RoboZag/zagHexa/androidRobotBTjoystick/README.md

# Android Bluetooth Joypad
Joystick app to control a robot over Bluetooth.

A demo video of the app can be found [here](https://drive.google.com/open?id=0B3lPRdhows9ATnFwX2w3UmVPc2M).

## Feature
  * video overlay through integration with IPwebcam [IPwebcam](https://play.google.com/store/apps/details?id=com.pas.webcam&hl=en)
  * Normal Joypad 4 direction and 4 buttons
  * Configurable buttons.
  * Quick setting using QRCode scanner.
  * Vibrate on click.
  * Debug mode.

## Screenshot

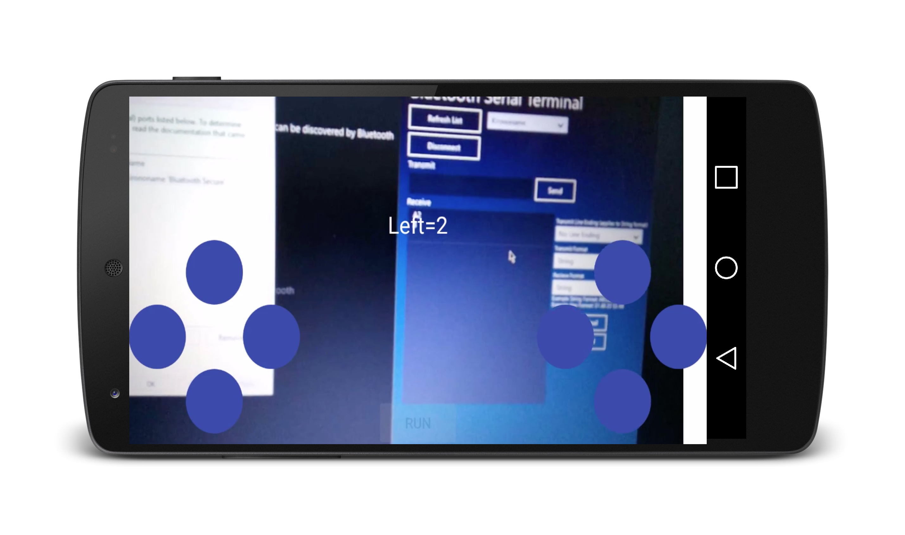
[picture p1: androidRobotBTjoystick/screenshots/vedioOverlay.png]


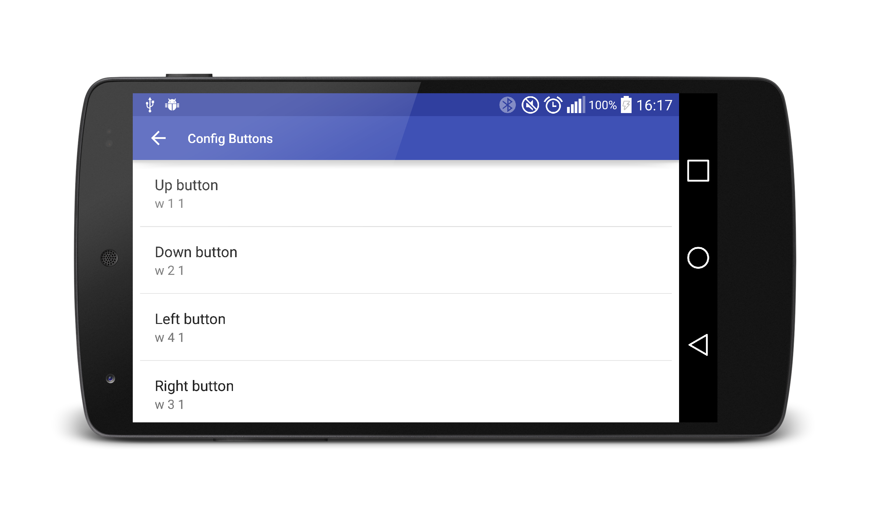
[picture p2: androidRobotBTjoystick/screenshots/DFG_2015-11-27-16-36-59.png]


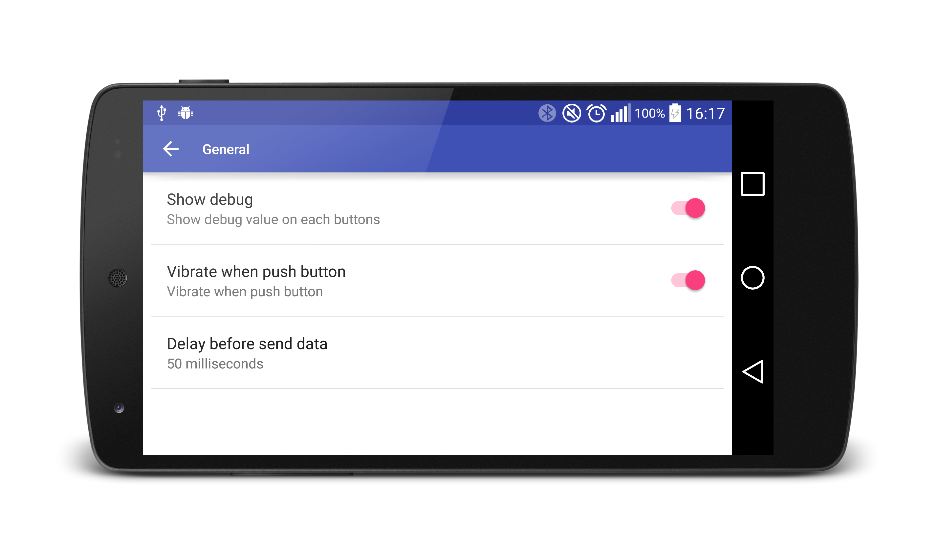
[picture p3: androidRobotBTjoystick/screenshots/DFG_2015-11-27-16-37-12.png]
     

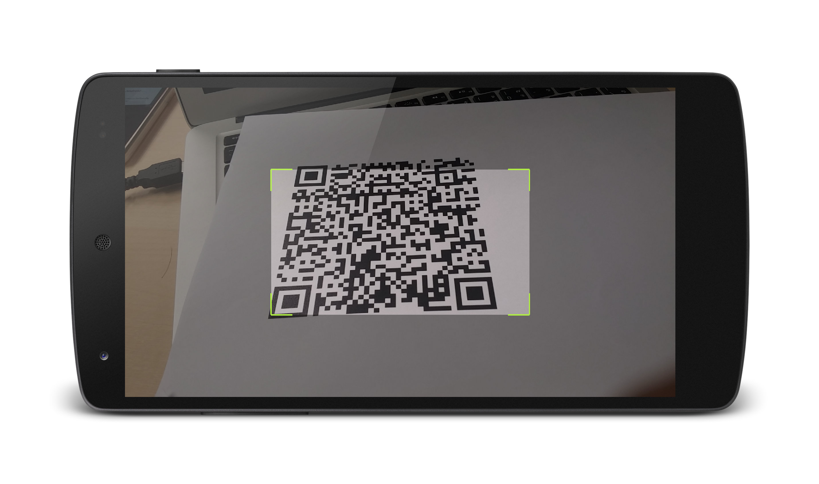
[picture p4: androidRobotBTjoystick/screenshots/DFG_2015-12-09-10-57-40.png]
         

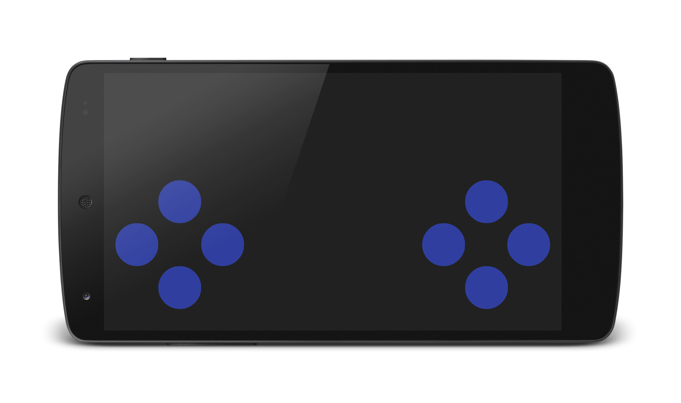
[picture p5: androidRobotBTjoystick/screenshots/DFG_2015-12-16-21-09-15.png]
 

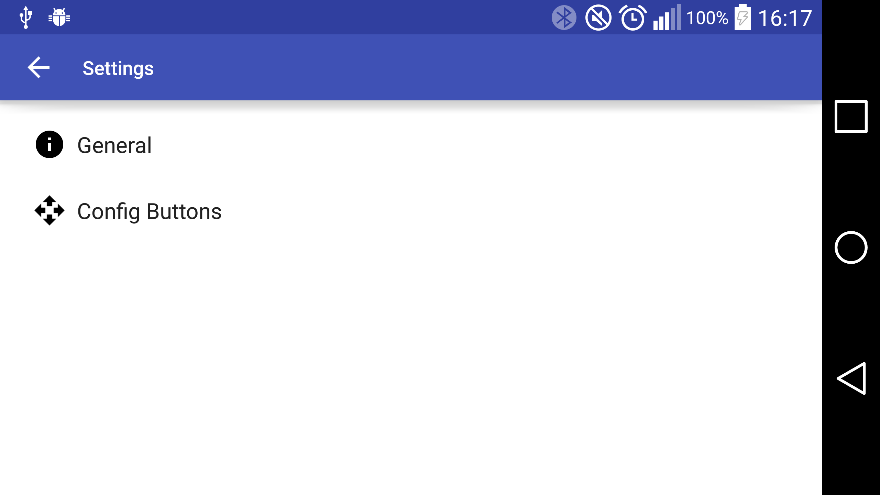
[picture p6: androidRobotBTjoystick/screenshots/Screenshot_2015-11-27-16-17-21.png]
