RoboZag/zagHexa/publications/IUGRC/2017IUGRC-ZagHexa.tex

%% bare_conf.tex
%% V1.4b
%% 2015/08/26
%% by Michael Shell
%% See:
%% http://www.michaelshell.org/
%% for current contact information.
%%
%% This is a skeleton file demonstrating the use of IEEEtran.cls
%% (requires IEEEtran.cls version 1.8b or later) with an IEEE
%% conference paper.
%%
%% Support sites:
%% http://www.michaelshell.org/tex/ieeetran/
%% http://www.ctan.org/pkg/ieeetran
%% and
%% http://www.ieee.org/

%%*************************************************************************
%% Legal Notice:
%% This code is offered as-is without any warranty either expressed or
%% implied; without even the implied warranty of MERCHANTABILITY or
%% FITNESS FOR A PARTICULAR PURPOSE! 
%% User assumes all risk.
%% In no event shall the IEEE or any contributor to this code be liable for
%% any damages or losses, including, but not limited to, incidental,
%% consequential, or any other damages, resulting from the use or misuse
%% of any information contained here.
%%
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
% for subfigure.sty, the latter of which is no longer maintained and is
% incompatible with some LaTeX packages including fixltx2e. However,
% subfig.sty requires and automatically loads Axel Sommerfeldt's caption.sty
% which will override IEEEtran.cls' handling of captions and this will result
% in non-IEEE style figure/table captions. To prevent this problem, be sure
% and invoke subfig.sty's "caption=false" package option (available since
% subfig.sty version 1.3, 2005/06/28) as this is will preserve IEEEtran.cls
% handling of captions.
% Note that the Computer Society format requires a larger sans serif font
% than the serif footnote size font used in traditional IEEE formatting
% and thus the need to invoke different subfig.sty package options depending
% on whether compsoc mode has been enabled.
%
% The latest version and documentation of subfig.sty can be obtained at:
% http://www.ctan.org/pkg/subfig

% *** FLOAT PACKAGES ***
%
%\usepackage{fixltx2e}
% fixltx2e, the successor to the earlier fix2col.sty, was written by
% Frank Mittelbach and David Carlisle. This package corrects a few problems
% in the LaTeX2e kernel, the most notable of which is that in current
% LaTeX2e releases, the ordering of single and double column floats is not
% guaranteed to be preserved. Thus, an unpatched LaTeX2e can allow a
% single column figure to be placed prior to an earlier double column
% figure.
% Be aware that LaTeX2e kernels dated 2015 and later have fixltx2e.sty's
% corrections already built into the system in which case a warning will
% be issued if an attempt is made to load fixltx2e.sty as it is no longer
% needed.
% The latest version and documentation can be found at:
% http://www.ctan.org/pkg/fixltx2e

%\usepackage{stfloats}
% stfloats.sty was written by Sigitas Tolusis. This package gives LaTeX2e
% the ability to do double column floats at the bottom of the page as well
% as the top. (e.g., "\begin{figure*}[!b]" is not normally possible in
% LaTeX2e). It also provides a command:
%\fnbelowfloat
% to enable the placement of footnotes below bottom floats (the standard
% LaTeX2e kernel puts them above bottom floats). This is an invasive package
% which rewrites many portions of the LaTeX2e float routines. It may not work
% with other packages that modify the LaTeX2e float routines. The latest
% version and documentation can be obtained at:
% http://www.ctan.org/pkg/stfloats
% Do not use the stfloats baselinefloat ability as the IEEE does not allow
% \baselineskip to stretch. Authors submitting work to the IEEE should note
% that the IEEE rarely uses double column equations and that authors should try
% to avoid such use. Do not be tempted to use the cuted.sty or midfloat.sty
% packages (also by Sigitas Tolusis) as the IEEE does not format its papers in
% such ways.
% Do not attempt to use stfloats with fixltx2e as they are incompatible.
% Instead, use Morten Hogholm'a dblfloatfix which combines the features
% of both fixltx2e and stfloats:
%
% \usepackage{dblfloatfix}
% The latest version can be found at:
% http://www.ctan.org/pkg/dblfloatfix

% *** PDF, URL AND HYPERLINK PACKAGES ***
%
\usepackage{url}
% url.sty was written by Donald Arseneau. It provides better support for
% handling and breaking URLs. url.sty is already installed on most LaTeX
% systems. The latest version and documentation can be obtained at:
% http://www.ctan.org/pkg/url
% Basically, \url{my_url_here}.

% *** Do not adjust lengths that control margins, column widths, etc. ***
% *** Do not use packages that alter fonts (such as pslatex).         ***
% There should be no need to do such things with IEEEtran.cls V1.6 and later.
% (Unless specifically asked to do so by the journal or conference you plan
% to submit to, of course. )

% correct bad hyphenation here
\hyphenation{op-tical net-works semi-conduc-tor}

%2nd IUGRC International Undergraduate Research Conference,
%Military Technical College, Cairo, Egypt, July 24-27, 2017.	

\begin{document}
%
% paper title
% Titles are generally capitalized except for words such as a, an, and, as,
% at, but, by, for, in, nor, of, on, or, the, to and up, which are usually
% not capitalized unless they are the first or last word of the title.
% Linebreaks \\ can be used within to get better formatting as desired.
% Do not put math or special symbols in the title.
\title{ZagHexa: Design, Construction and Control\\of a Hexapod Walking Robot}

%Faculty of Engineering, Zagazig University, Egypt, 
% khaledrisha@gmail.com, mahmoud.elsyed21@gmail.com, 3bqar10@gmail.com, amirafadaly90@gmail.com, enghkho@gmail.com, engvida2@gmail.com
%Supervisor: Mohammed Nour Abdel Gwad Ahmed, Dr. Ing.
%Faculty of Engineering, Zagazig University, Egypt, 
%mnahmed@eng.zu.edu.eg

% author names and affiliations
% use a multiple column layout for up to three different
% affiliations

\author{
      \IEEEauthorblockN{Mohammed Nour Abdelgwad Ahmed}
    \IEEEauthorblockA{Computer and Systems Dept., Faculty of Engineering, Zagazig University, Egypt}

    \IEEEauthorblockN{Khaled Mohamed Risha, Mahmoud Mohamed Awadallah, Muhammad Alaa Muhammad, \\
        Amira Elsayed Fadaly, Hend Khairy Abdelhamed, Nehad Abdelsalam Afifi}
    \IEEEauthorblockA{Computer and Systems Dept., Faculty of Engineering\\
         Zagazig University, Egypt\\
     Email: mnahmedeng.zu.edu.eg}}

%\author{\IEEEauthorblockN{Author One\IEEEauthorrefmark{1},
%        Author Two\IEEEauthorrefmark{2}, Author Three\IEEEauthorrefmark{3} and
%        Author Four\IEEEauthorrefmark{4}}
%    \IEEEauthorblockA{Computer and Systems Dept., Faculty of Engineering, Zagazig University, Egypt\\
%        Email: \IEEEauthorrefmark{1}author.one@add.on.net,
%        \IEEEauthorrefmark{2}author.two@add.on.net,
%        \IEEEauthorrefmark{3}author.three@add.on.net,
%        \IEEEauthorrefmark{4}author.four@add.on.net}}
%    
%\author{%
%\IEEEauthorblockN{Khaled Mohamed Mohamed Abdelrahman Risha}
%\IEEEauthorblockA{khaledrisha@gmail.com}
%\and
%\IEEEauthorblockN{Mahmoud Mohamed Awadallah}
%\IEEEauthorblockA{khaledrisha@gmail.com}
%\and
%\IEEEauthorblockN{Muhammad Alaa Muhammad}
%\IEEEauthorblockA{khaledrisha@gmail.com}
%\and
%\IEEEauthorblockN{ Amira Elsayed Soliman Fadaly}
%\IEEEauthorblockA{khaledrisha@gmail.com}
%\and
%\IEEEauthorblockN{Hend Khairy Abdelhamed}
%\IEEEauthorblockA{khaledrisha@gmail.com}
%\and
%\IEEEauthorblockN{Nehad Abdelsalam Afifi}
%\IEEEauthorblockA{khaledrisha@gmail.com}

%\IEEEauthorblockA{School of Electrical and\\Computer Engineering\\
%Georgia Institute of Technology\\
%Atlanta, Georgia 30332--0250\\
%Email: http://www.michaelshell.org/contact.html}
%\and
%\IEEEauthorblockN{Homer Simpson}
%\IEEEauthorblockA{Twentieth Century Fox\\
%Springfield, USA\\
%Email: homer@thesimpsons.com}
%\and
%\IEEEauthorblockN{James Kirk\\ and Montgomery Scott}
%\IEEEauthorblockA{Starfleet Academy\\
%San Francisco, California 96678--2391\\
%Telephone: (800) 555--1212\\
%Fax: (888) 555--1212}}

% conference papers do not typically use \thanks and this command
% is locked out in conference mode. If really needed, such as for
% the acknowledgment of grants, issue a \IEEEoverridecommandlockouts
% after \documentclass

% for over three affiliations, or if they all won't fit within the width
% of the page, use this alternative format:
% 
%\author{\IEEEauthorblockN{Michael Shell\IEEEauthorrefmark{1},
%Homer Simpson\IEEEauthorrefmark{2},
%James Kirk\IEEEauthorrefmark{3}, 
%Montgomery Scott\IEEEauthorrefmark{3} and
%Eldon Tyrell\IEEEauthorrefmark{4}}
%\IEEEauthorblockA{\IEEEauthorrefmark{1}School of Electrical and Computer Engineering\\
%Georgia Institute of Technology,
%Atlanta, Georgia 30332--0250\\ Email: see http://www.michaelshell.org/contact.html}
%\IEEEauthorblockA{\IEEEauthorrefmark{2}Twentieth Century Fox, Springfield, USA\\
%Email: homer@thesimpsons.com}
%\IEEEauthorblockA{\IEEEauthorrefmark{3}Starfleet Academy, San Francisco, California 96678-2391\\
%Telephone: (800) 555--1212, Fax: (888) 555--1212}
%\IEEEauthorblockA{\IEEEauthorrefmark{4}Tyrell Inc., 123 Replicant Street, Los Angeles, California 90210--4321}}

% use for special paper notices
%\IEEEspecialpapernotice{(Invited Paper)}

% make the title area
\maketitle

% As a general rule, do not put math, special symbols or citations
% in the abstract
\begin{abstract}
This paper presents design, construction and control of a hexapod robot named ZagHexa which is a six-legged walking robot. As walking robots in general and hexapod robots in particular attract considerable attention for several decades. Thus, many studies are carried out in research and industry. We provide an overview of the state of the art on walking robots. In addition, an account of the basic characteristics of legged robots will be given with description of some of existing robots and their pros and cons. 

Our main goal is to produce an efficient walking machines that is designed and built with performances suitable for as many as possible applications. Therefore, careful attention is given to the main design issues and constraints that influence the technical feasibility and operation performance. A design procedure is outlined to systematically design a hexapod walking robot. In particular, the proposed design procedure considers the main features, such as mechanical structure and leg configuration, actuating and driving systems, payload, motion conditions, and walking gait.

The result of this project is the legged robot ZagHexa, which can walk using tripod, wave and ripple gait and is equipped with a couple of sensors. The robot is controlled and monitored from a user interface program based on the Robotic Operating System (ROS). It can display data from the sensors and the positions of robot legs. The robot can be used to test and verify algorithms, gaits and features of walking machines.
\end{abstract}

% no keywords
\begin{IEEEkeywords}
Hexapod, Legged chassis, Walking robot, Hexapod gaits, design procedure.
\end{IEEEkeywords}

% For peer review papers, you can put extra information on the cover
% page as needed:
% \ifCLASSOPTIONpeerreview
% \begin{center} \bfseries EDICS Category: 3-BBND \end{center}
% \fi
%
% For peerreview papers, this IEEEtran command inserts a page break and
% creates the second title. It will be ignored for other modes.
\IEEEpeerreviewmaketitle

%==============================================================================
\section{Introduction}
% no \IEEEPARstart
Robots can be found everywhere. One of the most
important part of a robot is its chassis. There are several
basic chassis types: wheeled, tracked and legged chassis. Wheeled chassis are fast, but not suitable for rough terrain. Tracked chassis are slower, but more suitable to rugged terrain. Legged chassis are quite slow and more difficult to control, but extremely robust in rough terrain. Legged chassis are capable to cross large holes and can operate even after losing a leg. [1] Many researches were performed in this
field in past few years, because of its large potential. Legged chassis are especially ideal for space missions [2,3]. There are also several projects in military research [4, 5, 6].

A hexapod robot is a mechanical vehicle that walks on six legs. Since a robot can be statically stable on three or more legs, a hexapod robot has a great deal of flexibility in how it can move. If legs become disabled, the robot may still be able to walk. Furthermore, not all of the robot's legs are needed for stability; other legs are free to reach new foot placements or manipulate a payload.

As technology developed, so did the potential uses for the robots. With six legs, the hexapod has a remarkable degree of stability. It can balance its weight on a combination of its legs using an alternating tripod gait, and can engage in complex activities like climbing stairs relatively easily.

Development of hexapods is increasingly robust in the military sector. Armies all over the world are exploring ways of using hexapods to detect land mines, traverse rocky, unstable terrain, and carry out simple delivery missions in danger zones.
\begin{figure}
    \centering
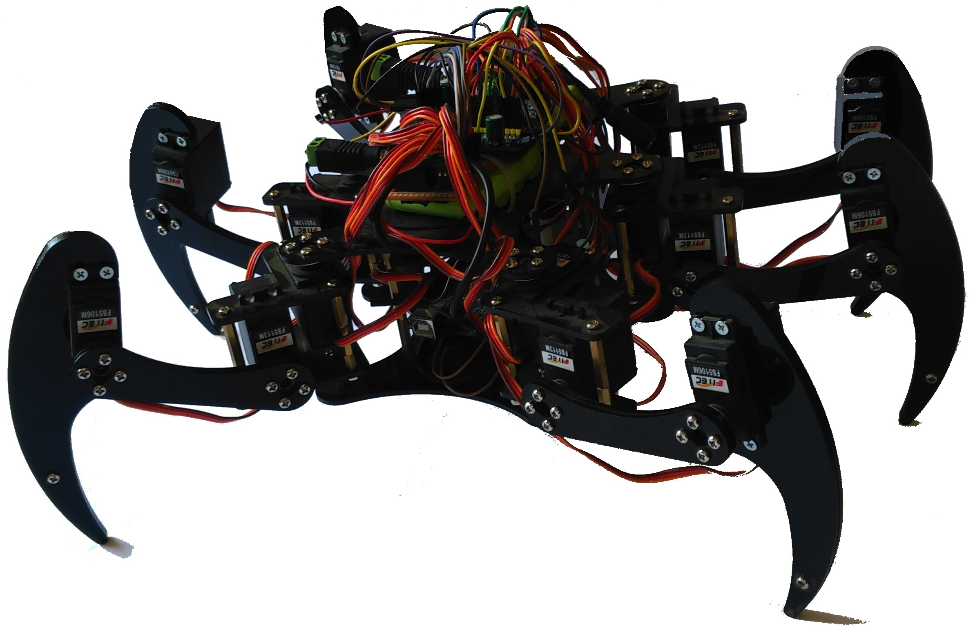
[picture p80: publications/IUGRC/figures/ZagHexa.jpg]
    
    \caption{ZagHexa Robot.}
    \label{fig:zaghexa}
\end{figure}

We aim to create a cheap legged platform, which would allow research and testing of walking patterns. Create a system with many sensors that allows the robot any movement or behavior. The robot should be driven from wirelessly connected computer and should send all available data from sensors, which will be displayed on the computer in the user interface program. Figure 1 shows the 3D CAD design of the robot.
%==============================================================================

\section{Hardware and software architectures}
There are many ways how to classify walking robots – by a body shape [7], number of legs, number of degrees of freedom per leg or locomotion technique. Various options can be combined to achieve many different configurations. At least two degrees of freedom are needed to construct a walking robot – the first for lifting the leg, second for rotating it. Nevertheless, there should be three degrees of freedom for a good functioning chassis, because the legs move along a circle and the forward movement of the body causes slipping between the foot and the terrain, which can be compensated by third joint [8, 9]. Walking chassis movement can be divided into statically stable and dynamically stable [1, 9]. Static stability represents the ability of the chassis to remain in a stable position in every moment of movement. Static stability is typical for hexapod, which is always stable during its movement. Dynamically stable chastises are sometimes out of balance – balancing or falling. This is common for two-legged robots.

ZagHexa is a hexapod robot with 18 DOFs (3 DOFs each leg), it can walk in any direction (translation), or turn in place (rotation), or any combination of the two. The leg lift and ride height is adjustable as well. 
It is an integrated multi-legged walking robot based on de fecto standard robotic platforms and operating system (ROS) that employs novel and different walking patterns.
We have an interactive website for robot inspection and online control in addition to leaning materials such as robot building and implementation walkthroughs and as well as step-by-setup tutorials.

The hexapod is controlled remotely using hand-held devices such as: a mobile application or a joystick. Furthermore, it has its own navigation system and a camera for instant video recording and streaming.

The power to the entire system is supplied through two 5 volts NiMH batteries, which can supply sufficient power required for basic movement. There is an additional power bank to power up the Raspberry Pi and other electronic components. 
%------------------------------------------------------------------------------

\subsection{Hardware}
ZagHexa is equipped with all necessary resources to interact with his world. The system is supplied with an embedded computing system which is Raspberry Pi 3 Model B that use Ubuntu Xilinx.  Raspberry Pi is a miniature computer the size of a credit card, to which a standard monitor, a keyboard and a mouse can be connected. It has extremely low power consumption (max. 3.5 W) and can run ROS based on Ubuntu operating system. There are several models, which differ in RAM, the number of USB ports or GPIO pins and the connation methods. Raspberry Pi is equipped with a USB Wi-Fi dongle, which is connected to a wireless network, and runs Qt [11] client program, which is able to find the IP address of the server and gets connected to it. Sensor data are sent to a computer after successful connection. Client is also capable of reconnect after disconnection.

ZagHexa can use all the sensors form any mobile phone thanks to its own mobile application that communicate through Bluetooth, which able it to sense the environment and deal with it. 

All servomotors are connected and driven by an external controller PCA9685 that take the walking pattern from the raspberry through I2C pins controlling the sequence of order and keep the position in the last order it was in (see Fig.2).
%------------------------------------------------------------------------------

\subsection{Software}
The high–level functionality and control of the robot are implemented in ROS packages. The Robot Operating System (ROS) is a standard and open–source operating system for robot control [10]. ROS is not an operating system in the traditional sense of process management and scheduling; rather, it provides a structured communication layer above the host operating systems of a heterogeneous compute cluster. Our software ROS packages interact with each of the subsystems in C++ and Python for direct system control. The system described uses a Linux based software framework as an operating system (OS) for providing the advantages of using an OS which supports developing additional modules that can be easily implemented and integrated. ROS provides operating system like service for the robot. It is a meta-operating system which loads on top of an operating system to provide a standardized set of software framework and APIs. These facilities cannot only help robots but also other embedded systems with a rich set of tools to successfully manage the complexity. With ROS handling the basic communications and data exchange.
%==============================================================================

\section{Mechanical Design}
We, firstly, developed our hexapod robot design using the well-known solid design software called SOLIDWORKS, then we have our model into real world using a laser cutter.

This hexapod has rectangular body type – it has two groups of legs, three on each side. Each leg has three degrees of freedom and is powered by hobby servomotors with different torque rating (FS5113M on coxa and femur and FS5106M on tibia joints

\begin{figure}
    \centering
   % \includegraphics[width=0.7\linewidth]{"../../Google Drive/ZagHexa2017/publications/IUGRC/Untitled"}
    \caption{Front view of the leg}
    \label{fig:untitled}
\end{figure}

Servomotors must be sufficiently powerful, depending on the desired behavior. If tripod gait is required, then each motor on the middle legs must be powerful enough to hold half of the weight of the robot.
It is important to choose a suitable material for the body. It must be solid enough, but not too heavy.
Therefore, aluminum profiles were chosen for the body construction. They are quite light-weighted and solid enough. In addition, they are available in various sizes and shapes and are easy to handle. The project is made of a double layer profile of thickness equals 3 mm each. 
%==============================================================================

\section{Conclusion}
This paper presents a system description and the main aspects related to the design, construction, and implementation of six leg robot "ZagHexa", a legged robot for search and rescue mission. The robot benefits form the reliability of the legged robot with the ﬂexibility and versatility required to operate in different types of surface.

These features are mainly achieved due to its original movement that make it deal with different surfaces. Additionally, its shape and weight give it more stability, and its ability to continue with its moving and sensing capabilities after collisions or even small falls. However, more tests and experiments to improve and validate the design and sensor performance are to be carried out in order to optimize the system performance.

Finally, some issues have to be addressed in order to fulﬁll fully autonomous operation and integration into a heterogeneous system. in order to make the integration of ZagHexa into different missions easier, an effort is being carried out so as to provide it with a standard connectivity by using the common robot operating system (ROS) framework. This task becomes easier since it natively works using Ubuntu as its operating system and encapsulate its functionality in ROS packages.
%==============================================================================

\section*{Acknowledgment}
We thank all team members of this project who provided valuable comments, ideas, and assistance, which were essential to this study. This work is developed for and funded by CSE Department Zagazig University as a part of development for graduation project.

\subsubsection{Subsubsection Heading Here}
Subsubsection text here.

% An example of a floating figure using the graphicx package.
% Note that \label must occur AFTER (or within) \caption.
% For figures, \caption should occur after the \includegraphics.
% Note that IEEEtran v1.7 and later has special internal code that
% is designed to preserve the operation of \label within \caption
% even when the captionsoff option is in effect. However, because
% of issues like this, it may be the safest practice to put all your
% \label just after \caption rather than within \caption{}.
%
% Reminder: the "draftcls" or "draftclsnofoot", not "draft", class
% option should be used if it is desired that the figures are to be
% displayed while in draft mode.
%
%\begin{figure}[!t]
%\centering
%\includegraphics[width=2.5in]{myfigure}
% where an .eps filename suffix will be assumed under latex, 
% and a .pdf suffix will be assumed for pdflatex; or what has been declared
% via \DeclareGraphicsExtensions.
%\caption{Simulation results for the network.}
%\label{fig_sim}
%\end{figure}

% Note that the IEEE typically puts floats only at the top, even when this
% results in a large percentage of a column being occupied by floats.

% An example of a double column floating figure using two subfigures.
% (The subfig.sty package must be loaded for this to work.)
% The subfigure \label commands are set within each subfloat command,
% and the \label for the overall figure must come after \caption.
% \hfil is used as a separator to get equal spacing.
% Watch out that the combined width of all the subfigures on a 
% line do not exceed the text width or a line break will occur.
%
%\begin{figure*}[!t]
%\centering
%\subfloat[Case I]{\includegraphics[width=2.5in]{box}%
%\label{fig_first_case}}
%\hfil
%\subfloat[Case II]{\includegraphics[width=2.5in]{box}%
%\label{fig_second_case}}
%\caption{Simulation results for the network.}
%\label{fig_sim}
%\end{figure*}
%
% Note that often IEEE papers with subfigures do not employ subfigure
% captions (using the optional argument to \subfloat[]), but instead will
% reference/describe all of them (a), (b), etc., within the main caption.
% Be aware that for subfig.sty to generate the (a), (b), etc., subfigure
% labels, the optional argument to \subfloat must be present. If a
% subcaption is not desired, just leave its contents blank,
% e.g., \subfloat[].

% An example of a floating table. Note that, for IEEE style tables, the
% \caption command should come BEFORE the table and, given that table
% captions serve much like titles, are usually capitalized except for words
% such as a, an, and, as, at, but, by, for, in, nor, of, on, or, the, to
% and up, which are usually not capitalized unless they are the first or
% last word of the caption. Table text will default to \footnotesize as
% the IEEE normally uses this smaller font for tables.
% The \label must come after \caption as always.
%
%\begin{table}[!t]
%% increase table row spacing, adjust to taste
%\renewcommand{\arraystretch}{1.3}
% if using array.sty, it might be a good idea to tweak the value of
% \extrarowheight as needed to properly center the text within the cells
%\caption{An Example of a Table}
%\label{table_example}
%\centering
%% Some packages, such as MDW tools, offer better commands for making tables
%% than the plain LaTeX2e tabular which is used here.
%\begin{tabular}{|c||c|}
%\hline
%One & Two\\
%\hline
%Three & Four\\
%\hline
%\end{tabular}
%\end{table}

% Note that the IEEE does not put floats in the very first column
% - or typically anywhere on the first page for that matter. Also,
% in-text middle ("here") positioning is typically not used, but it
% is allowed and encouraged for Computer Society conferences (but
% not Computer Society journals). Most IEEE journals/conferences use
% top floats exclusively. 
% Note that, LaTeX2e, unlike IEEE journals/conferences, places
% footnotes above bottom floats. This can be corrected via the
% \fnbelowfloat command of the stfloats package.

\section{Conclusion}
The conclusion goes here.

% conference papers do not normally have an appendix

% use section* for acknowledgment
\section*{Acknowledgment}

The authors would like to thank...

% trigger a \newpage just before the given reference
% number - used to balance the columns on the last page
% adjust value as needed - may need to be readjusted if
% the document is modified later
%\IEEEtriggeratref{8}
% The "triggered" command can be changed if desired:
%\IEEEtriggercmd{\enlargethispage{-5in}}

% references section

% can use a bibliography generated by BibTeX as a .bbl file
% BibTeX documentation can be easily obtained at:
% http://mirror.ctan.org/biblio/bibtex/contrib/doc/
% The IEEEtran BibTeX style support page is at:
% http://www.michaelshell.org/tex/ieeetran/bibtex/
%\bibliographystyle{IEEEtran}
% argument is your BibTeX string definitions and bibliography database(s)
%\bibliography{IEEEabrv,../bib/paper}
%
% <OR> manually copy in the resultant .bbl file
% set second argument of \begin to the number of references
% (used to reserve space for the reference number labels box)
\begin{thebibliography}{1}

\bibitem{IEEEhowto:kopka}
H.~Kopka and P.~W. Daly, \emph{A Guide to \LaTeX}, 3rd~ed.\hskip 1em plus
  0.5em minus 0.4em\relax Harlow, England: Addison-Wesley, 1999.

\end{thebibliography}

% that's all folks
\end{document}
