RoboZag/zagHexa/documents/Presentation/Pck.pptx

Movement

Up U
Down D
Left L
Right R
BUTTON_X X
BUTTON_Y Y
BUTTON_B B
BUTTON_A A
BUTTON_RB M
BUTTON_RT N
BUTTON_LB O
BUTTON_LT P
BUTTON_Back K
BUTTON_Start S

Joystick_node

Arduino_node

Joystick_

Publish

Subscribe

Publish

Ultrasonic

## Slide 2

Sensors Reading

Get sensor Reading

Over TCP/IP

Client_node

sensorsV

ROS GUI

Publish

Subscribe

Subscribe

Oreading

Publish
