RoboZag/zagHexa/documents/finalReport/myFrontMatter/title.tex

%\titlehead{\centering\includegraphics[width=0.15\textwidth]{myFrontMatter/figures/zuLogo}
%    \includegraphics[width=0.2\textwidth]{myFrontMatter/figures/engLogo}}
\begin{titlepage}
\centering
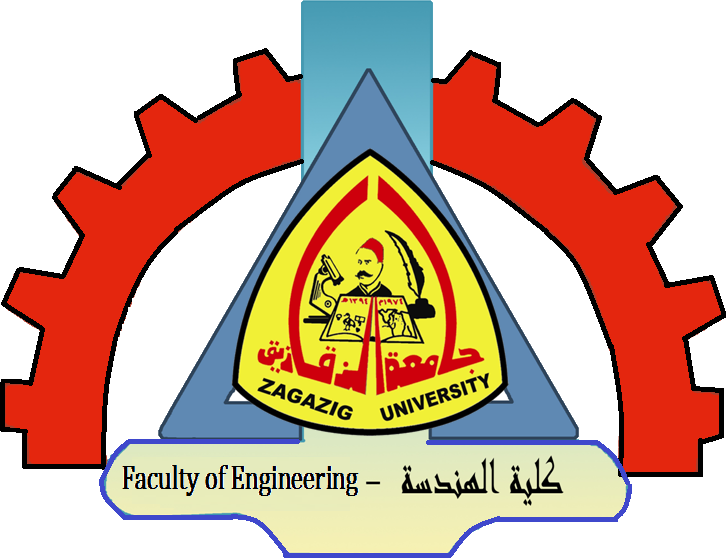
[picture p81: documents/finalReport/myFrontMatter/figures/engLogo.png]
 \qquad \\
{\usekomafont{titlehead}   Zagazig University, Faculty of Engineering,\\Computer and Systems Engineering Dept.}

  \vskip 10ex
{\LARGE\usekomafont{title} {\LARGE  ZagHexa: Design, Construction and Control of a Hexapod Walking Robot} }
\vskip 8ex
\emph{Graduation project for the degree Bachelor of Science (B.Sc.)\\
Submitted to Computer and Systems Engineering Dept., Faculty of Engineering, Zagazig University, Egypt}

\vskip 8ex
{\usekomafont{subtitle} By}
\vskip 1ex
{\usekomafont{author} 
    Mahmoud Mohammed Elsayed\\
    Khaled Mohammed  Risha\\
    Mohammed Alaa Mohammed\\
    Hend Khairy Abdelhamed\\
    Nehad Abdelsalam Mohammed\\
    Amira Elsayed Soliman
}

\vskip 6ex
{\usekomafont{subtitle} Supervisor}
\vskip 1ex

{\usekomafont{author}
    \emph{\normalsize  Asst. Prof. Dr.Ing.}\\
    \textbf{Mohammed Nour A. Ahmed} \\
     {\itshape\small Computer and Systems Engineering Dept.\\
    Faculty of Engineering, Zagazig University, Zagazig, Egypt}
}

\vfill
July, 2017
\end{titlepage}
%%% Rückseite der Titelseite %%%%%%%%%%%%%%%%%%%%%%%%%%%%%%%%%%%%%%%%%%%
%\uppertitleback{Graduation Project Report to be submitted to\\
%Zagazig University, faculty of Engineering\\
%in partial fulfillment of the requirements for the degree \\
%Bachelor of Science in Engineering (B.Sc.)\\
%\textcopyright 2017\\
%
%\vspace{2cm}
%   {\footnotesize
%      Copyright \textcopyright 2017 Dr.Ing. Mohammed Nour Abdelgwad Ahmed as part of the course work and learning material. All Rights Reserved. 
%      Where otherwise noted, this work is licensed under 
%      \href{https://creativecommons.org/licenses/by-nc-sa/4.0/}{ a Creative Commons Attribution-NonCommercial-ShareAlike 4.0 International License}.}
% \includegraphics[width=0.2\textwidth]{byncsa}
%
%}
%
%
%
%\lowertitleback{\textbf{Date of Presentation}\\
%  18. July 2017\\~\\
%  
%  \textbf{Supervisors}\\
%Dr.Ing. \textbf{Mohammed Nour Abdel Gwad Ahmed}\\
%\footnotesize{\itshape 
% Computer and Systems Engineering Department,\\
%  Faculty of Engineering, Zagazig University, Egypt}\\~\\
%
%
%%\textbf{Defense Commete}\\
%%Prof. Dr. Xyz Wuv\\
%%Prof. Dr. Abc Def
%}
%

%% Rückseite der Titelseite %%%%%%%%%%%%%%%%%%%%%%%%%%%%%%%%%%%%%%%%%%%
\newpage
{Graduation Project Report submitted to\\
    \textbf{Zagazig University, faculty of Engineering, Computer and Systems Engineering Department}, Zagazig, Egypt\\
    in partial fulfillment of the requirements for the degree \\
    Bachelor of Science in Engineering (\textbf{B.Sc.})\\
    \textcopyright 2017\\~\\
    
      \vspace{1cm}
    {\footnotesize
        Copyright \textcopyright 2017 Asst. Prof. Dr.Ing. Mohammed Nour Abdelgwad Ahmed as part of his course work and learning material. All Rights Reserved. 
        Where otherwise noted, this work is licensed under 
        \href{https://creativecommons.org/licenses/by-nc-sa/4.0/}{ a Creative Commons Attribution-NonCommercial-ShareAlike 4.0 International License}.}\\
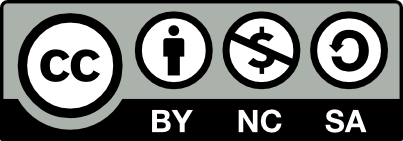
[picture p82: documents/finalReport/figures/byncsa.png]
    }\\

  \vspace{1cm}
{\textbf{Date of Presentation}\\
  18. July 2017\\~\\

    {\textbf{Project Team Members}\\
        \noindent\begin{tabular}{ll}
             Mahmoud Mohammed Elsayed&        Khaled Mohammed  Risha\\
            Mohammed Alaa Mohammed&            Hend Khairy Abdelhamed\\
            Nehad Abdelsalam Mohammed&        Amira Elsayed Soliman
        \end{tabular}\\~\\
        
        \textbf{Project Leader}\\
        Asst. Prof. Dr.Ing. \textbf{Mohammed Nour A. Ahmed}\\
        {\itshape \footnotesize
            Computer and Systems Engineering Department,\\
            Faculty of Engineering, Zagazig University, Egypt}\\~\\

        \vfill
        {\tiny Revision git.198.50.\mydate   % get git version number to be used as the version no. of the doc.
            \immediate\write18{./myGitVer.sh.command \jobname.txt}
            Version: \input{\jobname.txt}}
    }
