RoboZag/zagHexa/documents/finalReport/New Folder With Items/myFinalReportSettings.tex

\documentclass[12pt,BCOR=1cm,bibliography=totoc]{thesis}
\pdfminorversion=5 
\pdfcompresslevel=9 
\pdfobjcompresslevel=3
%\usepackage{showframe}

%\KOMAoptions{headings=small}
%\addtokomafont{disposition}{\rmfamily\mdseries}
%\renewcommand*{\contentsname}{Table of Contents}
%\setkomafont{chapterprefix}{\rmfamily\Large\bfseries}

% customize chapter format:
%\KOMAoption{headings}{twolinechapter}
%\renewcommand*\chapterformat{\thechapter\autodot}

% customize dictum format:
\setkomafont{dictumtext}{\itshape\small}
\setkomafont{dictumauthor}{\tiny}
\renewcommand*\dictumwidth{0.5\linewidth}
\renewcommand*\dictumauthorformat[1]{--- #1}
\renewcommand*\dictumrule{}

%*****************************************************************************
\graphicspath{ {figures/} }

%** new commands ******************************************************
\include{commands}

\usepackage{float}

\usepackage{pdfpages}
