RoboZag/zagHexa/documents/finalReport/New Folder With Items/myFrontMatter/title.tex

%%% German Title page----------------------------------------------------------------------
%% Angaben zur Standardformatierung des Titels %%%%%%%%%%%%%%%%%%%%%%%%
\titlehead{\centering
    }

\subject{Zagazig University, Faculty of Engineering,\\
    Computer and Systems Engineering Dept.}

\title{ZagHexa\\
    Design, Construction and Control\\
    of a Hexapod Walking Robot}

\subtitle{\vspace{2cm}a B.Sc. Graduation Project\\
\emph{Submitted by}}

\author{
    Mahmoud Mohammed Elsayed
\and{Khaled Mohammed  Risha} 
\and{Mohammed Alaa Mohammed} 
\and{Amira Elsayed Soliman} 
\and{Hend Khairy Abdelhamed} 
\and{Nehad Abdelsalam Mohammed}}

%\thanks{some foot note text} % entspr. \footnote im Fließtext
\date{July, 2017}

\publishers{Submitted to The  Computer and Systems Engineering Dept., Faculty of Engineering, Zagazig University, Egypt}

%% Rückseite der Titelseite %%%%%%%%%%%%%%%%%%%%%%%%%%%%%%%%%%%%%%%%%%%
\uppertitleback{Graduation Project Report to be submitted to\\
Zagazig University, faculty of Engineering\\
in partial fulfillment of the requirements for the degree \\
Bachelor of Science in Engineering (B.Sc.)\\
\textcopyright 2017}

\lowertitleback{\textbf{Date of Presentation}\\
  24. Juni 2015\\~\\
  
  \textbf{Supervisors}\\
Dr.Ing. \textbf{Mohammed Nour Abdel Gwad Ahmed}\\
\footnotesize{\itshape 
 Computer and Systems Engineering Department,\\
  Faculty of Engineering, Zagazig University, Egypt}\\~\\
Dr. \textbf{Ahmed Hamdy Hassanien}\\
\footnotesize{\itshape ~~ Mechanical Engineering Department, \\
    Faculty of Engineering, Zagazig University, Egypt}\\

\textbf{Defense Commete}\\
Prof. Dr. Xyz Wuv\\
Prof. Dr. Abc Def}
