RoboZag/zagHexa/docs/about/img/amira.jpg

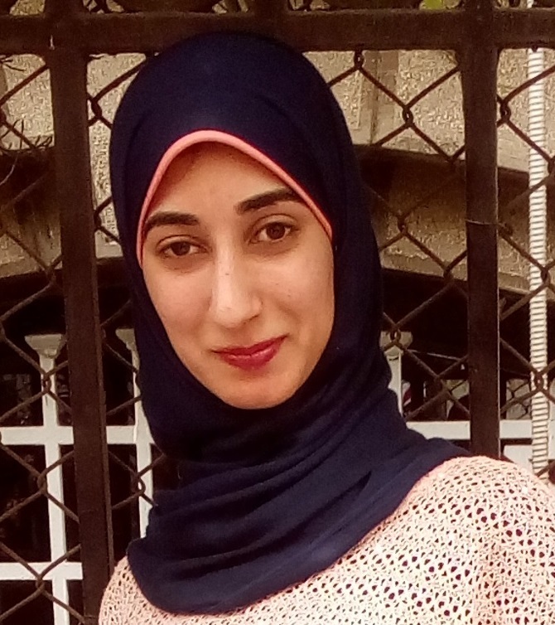
docs/about/img/amira.jpg
