RoboZag/zagHexa/docs/about/img/fw.png

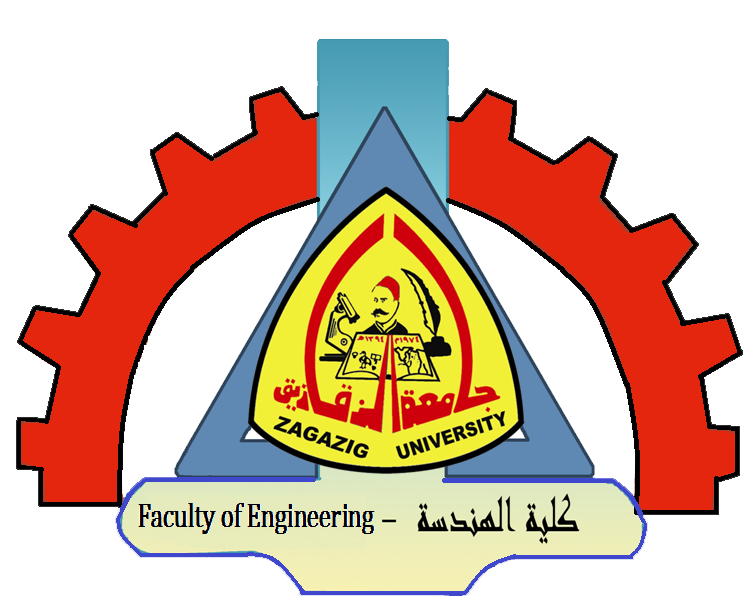
docs/about/img/fw.png
