RoboZag/zagHexa/docs/about/img/hend.png

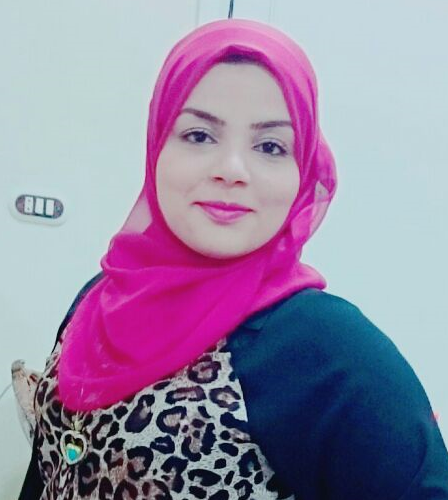
docs/about/img/hend.png
