RoboZag/zagHexa/docs/about/img/hexa1.png

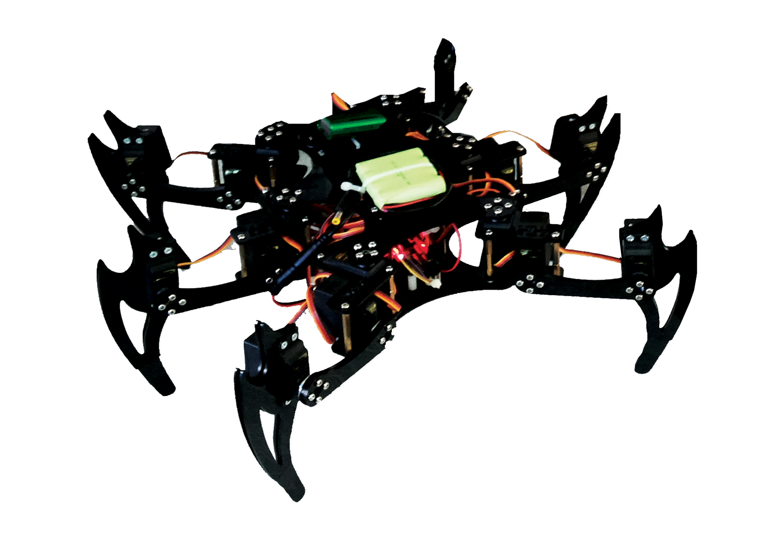
docs/about/img/hexa1.png
