RoboZag/zagHexa/docs/about/img/hexa2.png

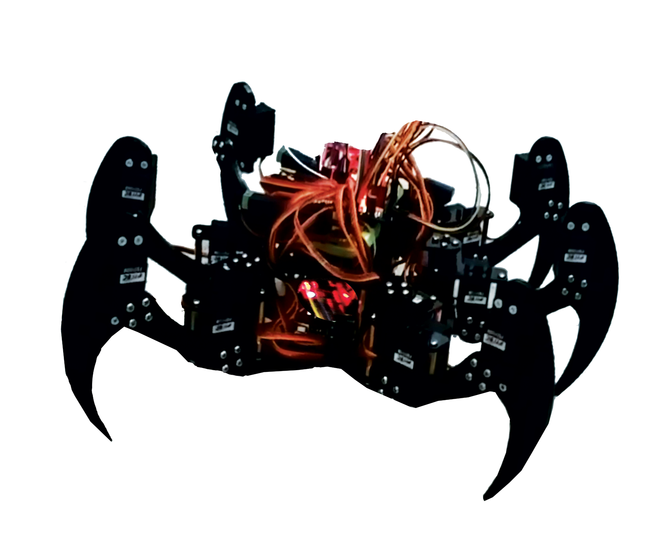
docs/about/img/hexa2.png
