RoboZag/zagHexa/docs/about/img/IMG-20170208-WA0011.jpg

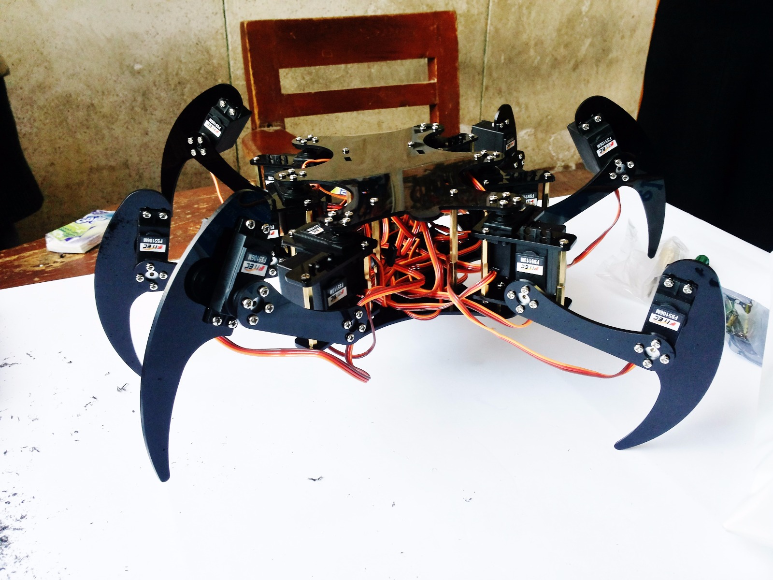
docs/about/img/IMG-20170208-WA0011.jpg
