RoboZag/zagHexa/docs/about/img/khaled.jpg

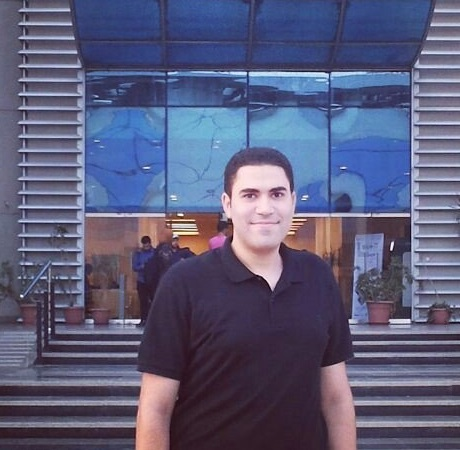
docs/about/img/khaled.jpg
