RoboZag/zagHexa/docs/about/img/mahmod.jpg

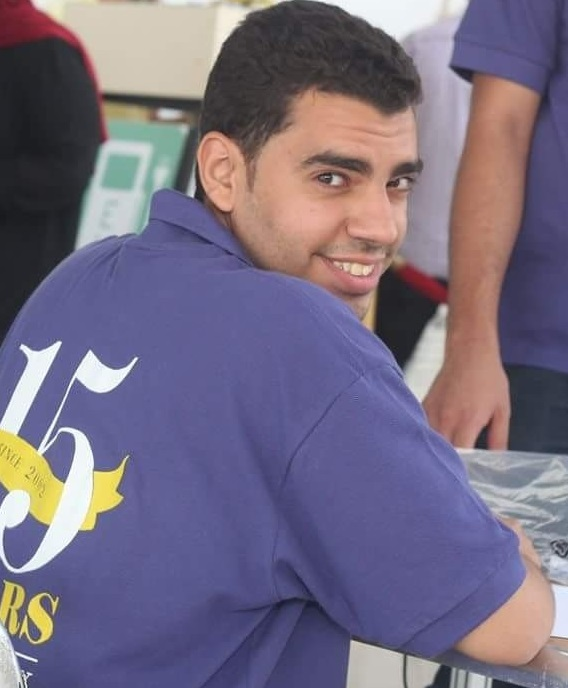
docs/about/img/mahmod.jpg
