RoboZag/zagHexa/docs/about/img/meSmall.jpg

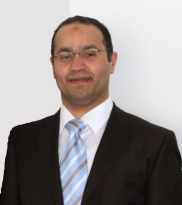
docs/about/img/meSmall.jpg
