RoboZag/zagHexa/docs/about/img/muhamed.jpg

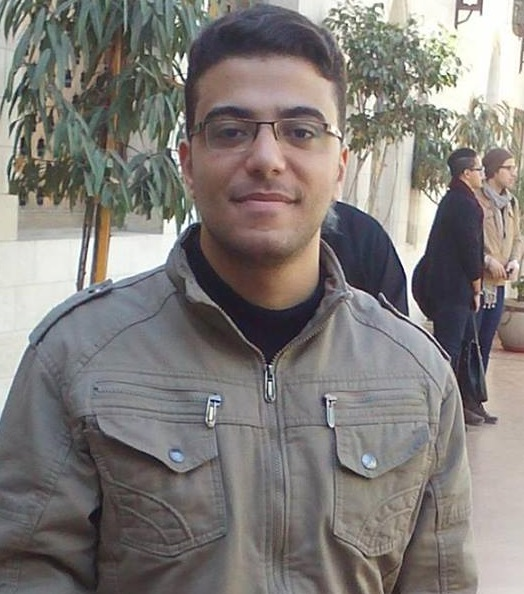
docs/about/img/muhamed.jpg
