RoboZag/zagHexa/docs/about/img/nehad.jpg

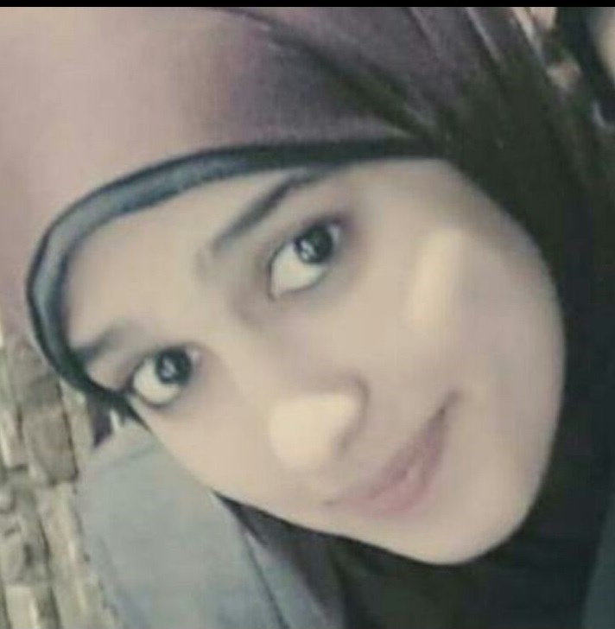
docs/about/img/nehad.jpg
