RoboZag/zagHexa/docs/about/img/roshero2.jpg

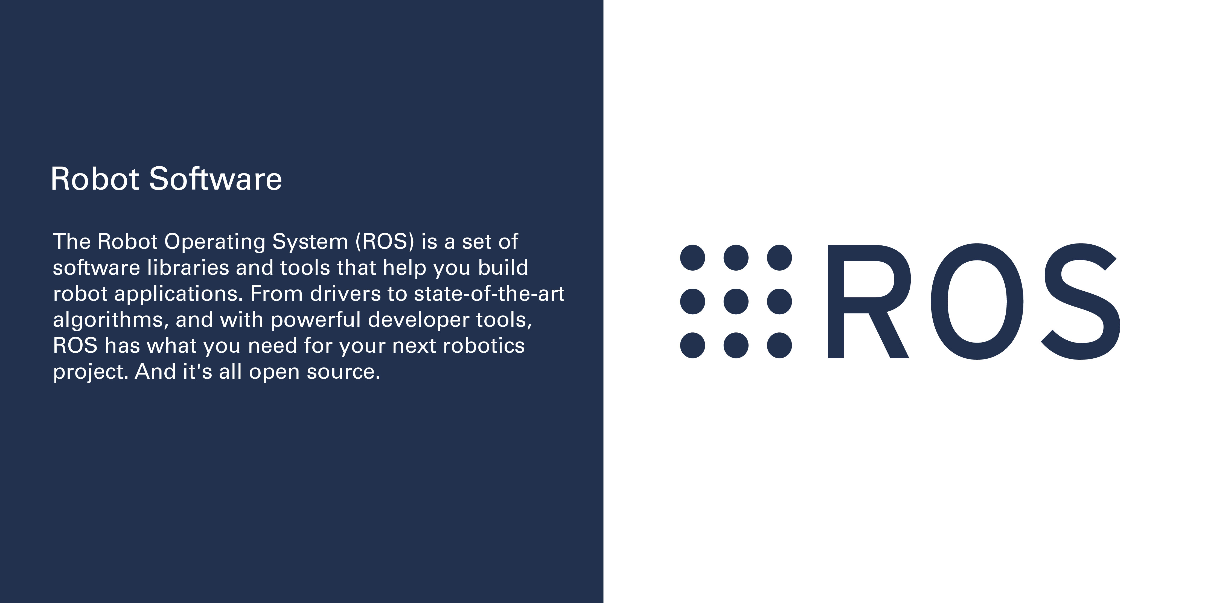
docs/about/img/roshero2.jpg
