RoboZag/zagHexa/docs/img/91668-Lynxmotion-CH3-R-Hexapod-Robot-Kit-with-BotBoarduino-2-700x700.jpg

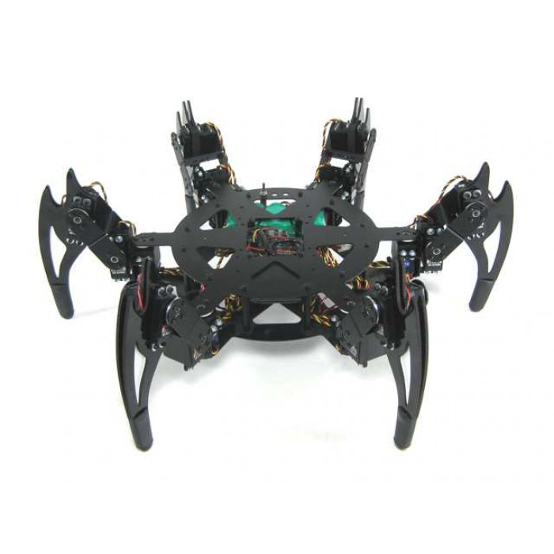
docs/img/91668-Lynxmotion-CH3-R-Hexapod-Robot-Kit-with-BotBoarduino-2-700x700.jpg
