RoboZag/zagHexa/docs/img/22274899.jpg

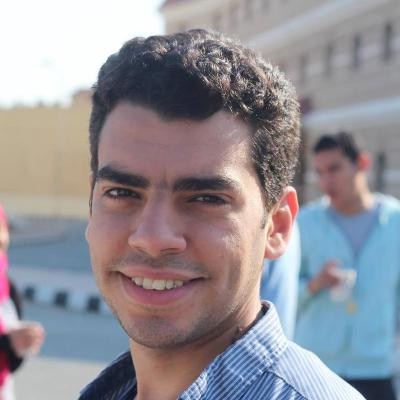
docs/img/22274899.jpg
