RoboZag/zagHexa/docs/img/23381247.jpg

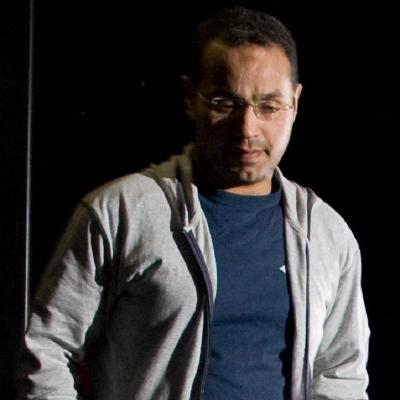
docs/img/23381247.jpg
