RoboZag/zagHexa/docs/img/download.jpg

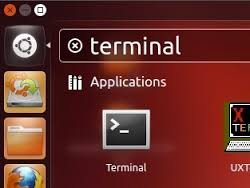
docs/img/download.jpg
