RoboZag/zagHexa/docs/img/Giant-ZagHexa1.png

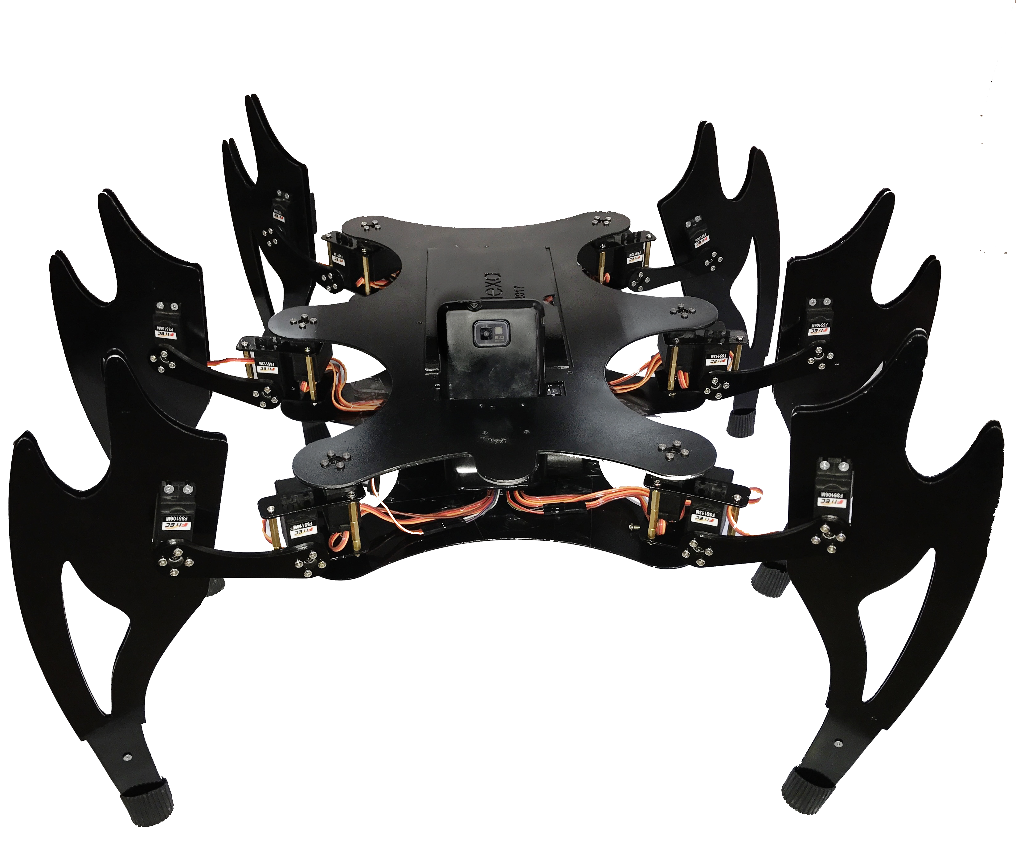
docs/img/Giant-ZagHexa1.png
