RoboZag/zagHexa/docs/img/Hexapod wgripperA.jpg

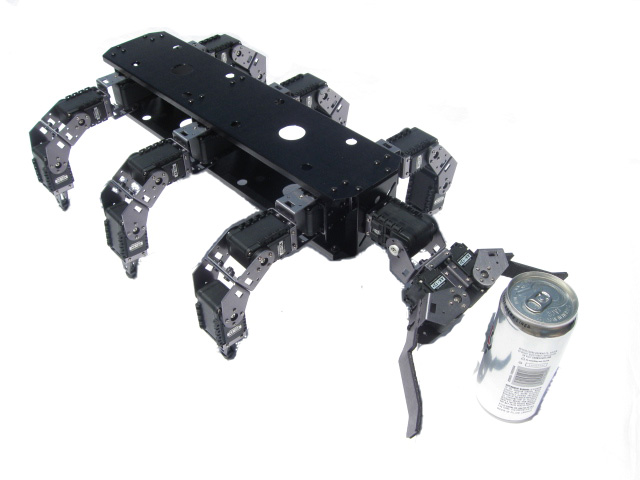
docs/img/Hexapod wgripperA.jpg
