RoboZag/zagHexa/docs/img/hexapod-portrait.jpg

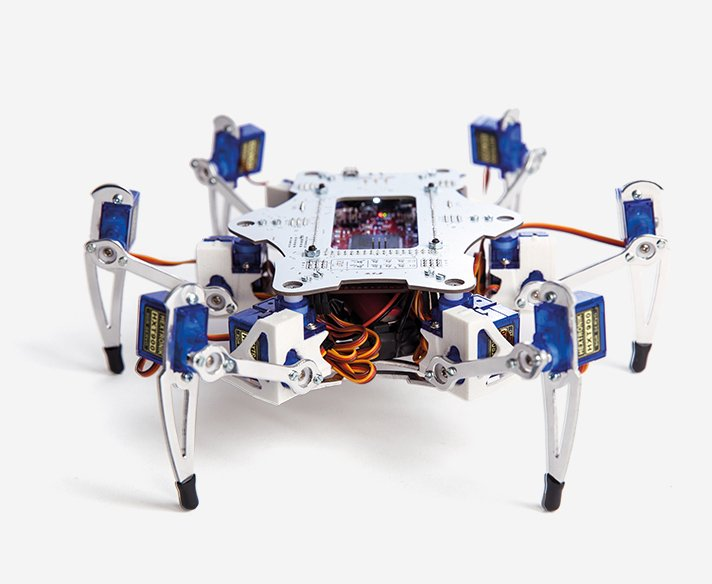
docs/img/hexapod-portrait.jpg
