RoboZag/zagHexa/docs/img/hexapod.jpg

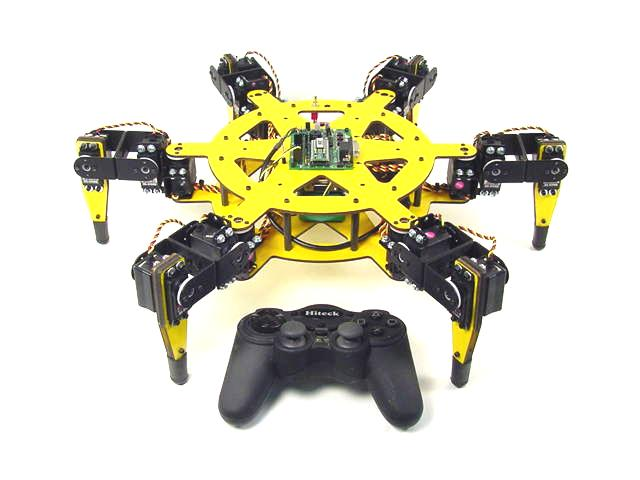
docs/img/hexapod.jpg
