RoboZag/zagHexa/docs/img/hqdefault.jpg

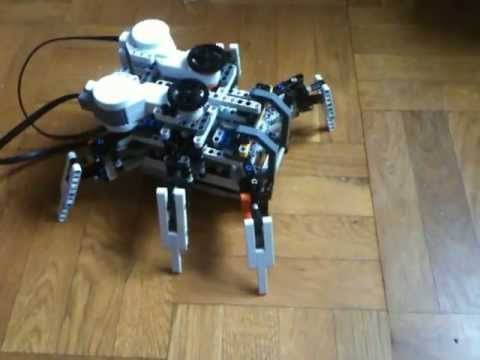
docs/img/hqdefault.jpg
