RoboZag/zagHexa/docs/img/linux.jpg

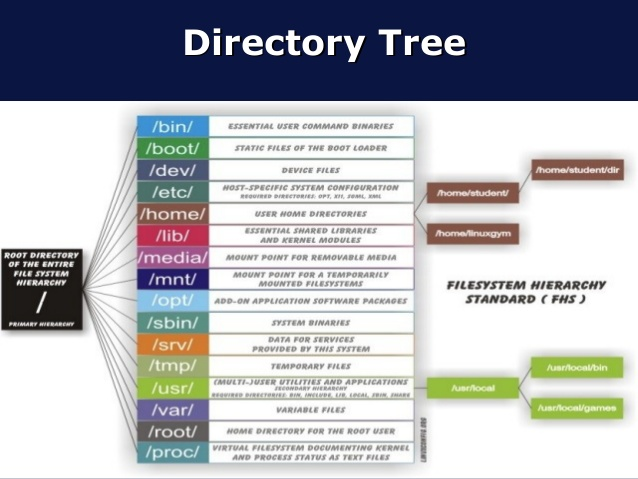
docs/img/linux.jpg
