RoboZag/zagHexa/docs/img/LqNxN.png

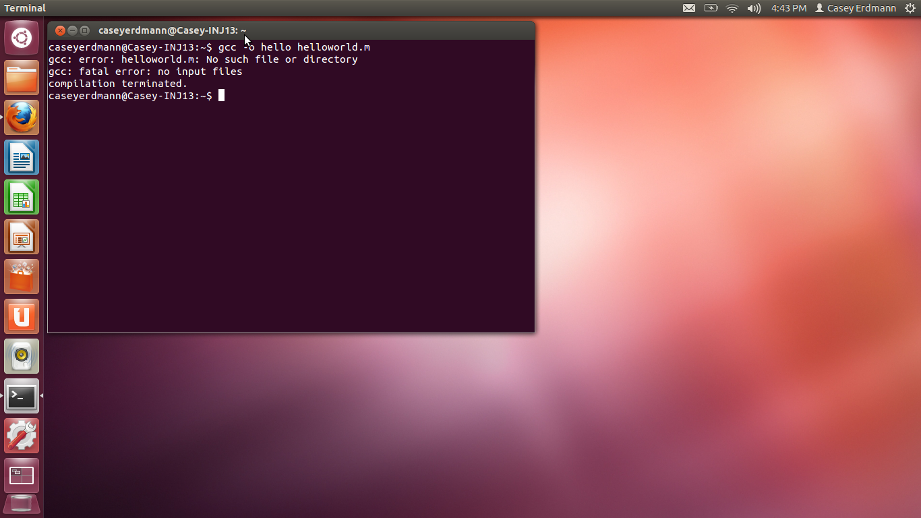
docs/img/LqNxN.png
