RoboZag/zagHexa/docs/img/lynxmotion-a-pod-hexapod-robot-kit-hardware-only-3-large.jpg

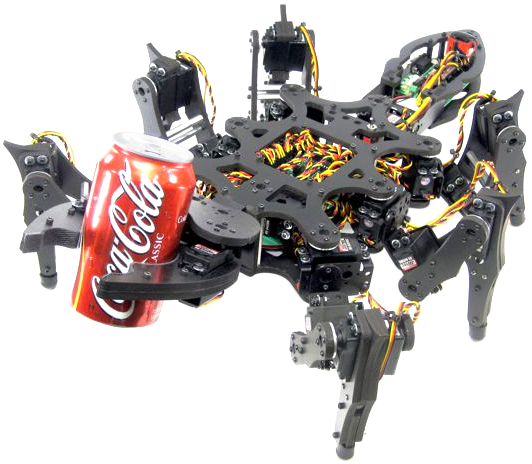
docs/img/lynxmotion-a-pod-hexapod-robot-kit-hardware-only-3-large.jpg
