RoboZag/zagHexa/docs/img/mantis02-heller.jpg

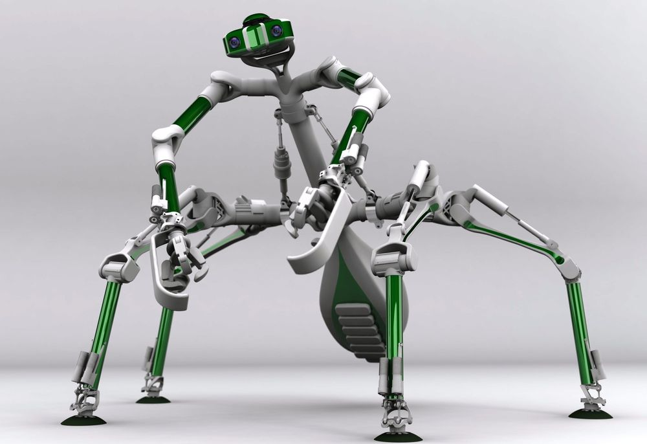
docs/img/mantis02-heller.jpg
