RoboZag/zagHexa/docs/img/Mantis-016_2_02.jpg

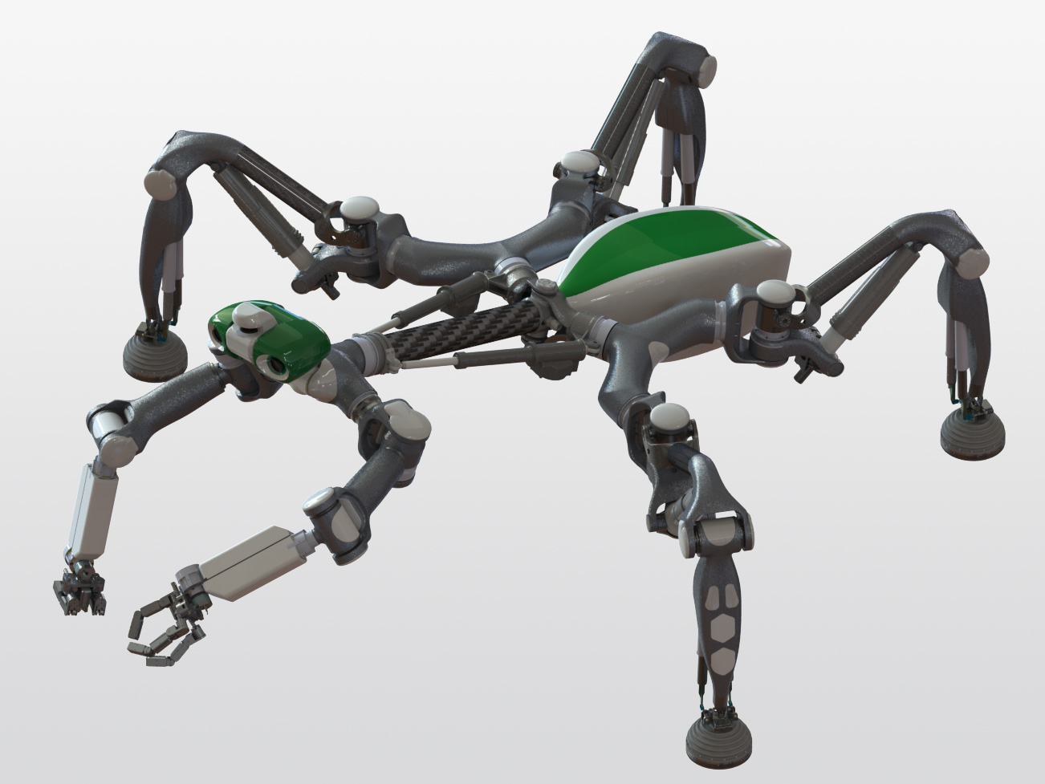
docs/img/Mantis-016_2_02.jpg
