RoboZag/zagHexa/docs/img/mantis.jpg

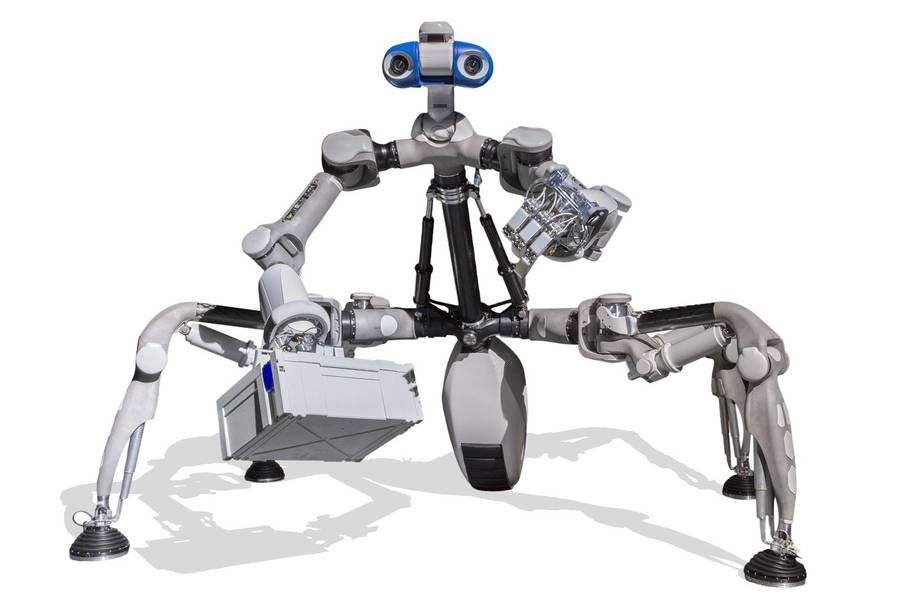
docs/img/mantis.jpg
