RoboZag/zagHexa/docs/img/poster1.png

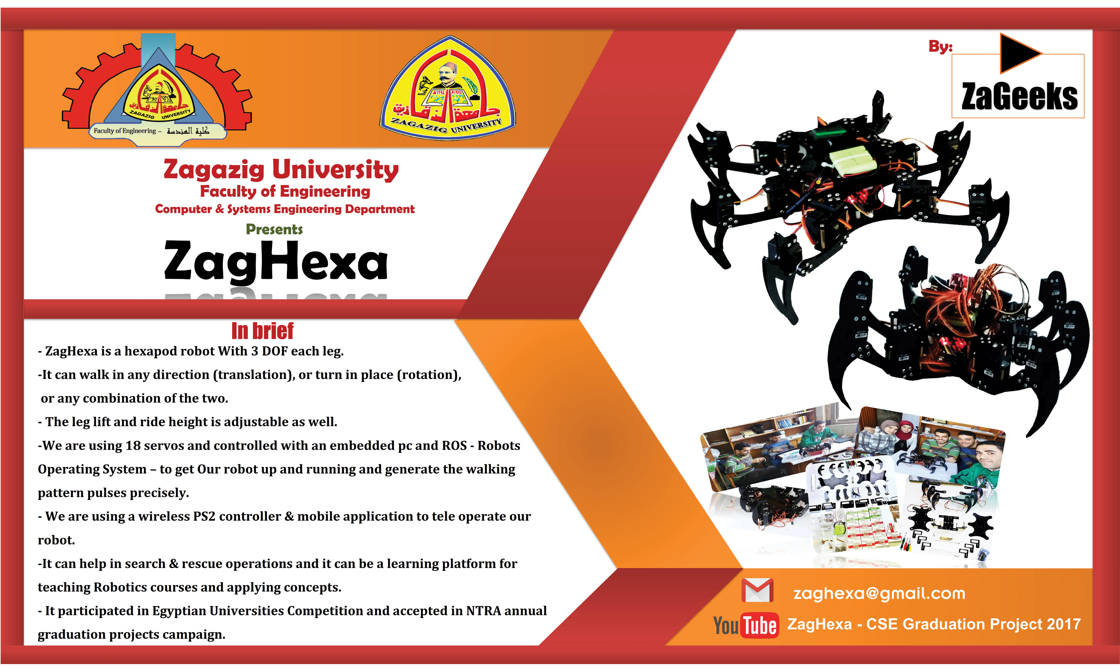
docs/img/poster1.png
