RoboZag/zagHexa/docs/img/raspberry-pi-ros-10-638.jpg

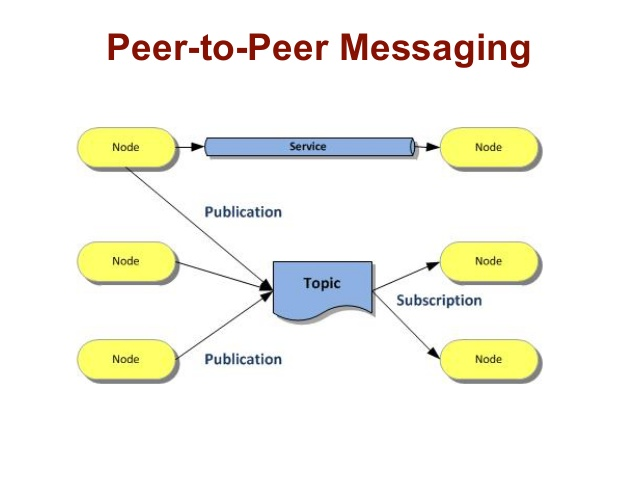
docs/img/raspberry-pi-ros-10-638.jpg
