RoboZag/zagHexa/docs/img/Slide1.png

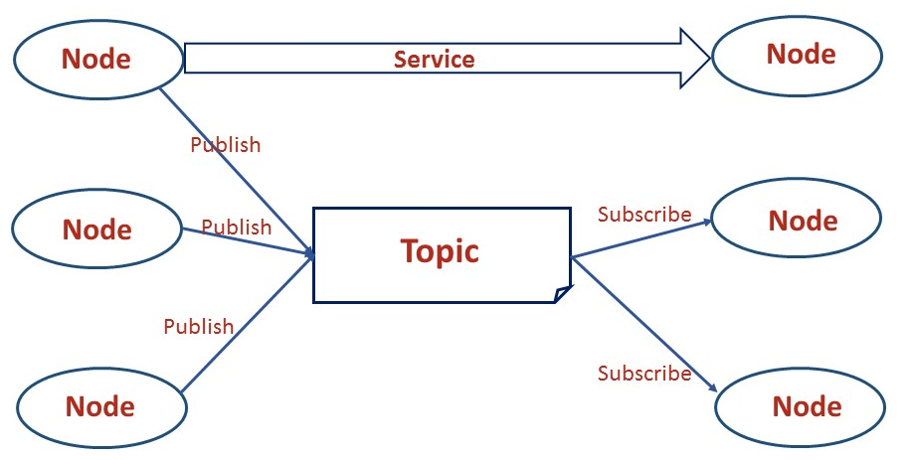
docs/img/Slide1.png
