RoboZag/zagHexa/docs/img/uZagHexaFinalShadows.JPG

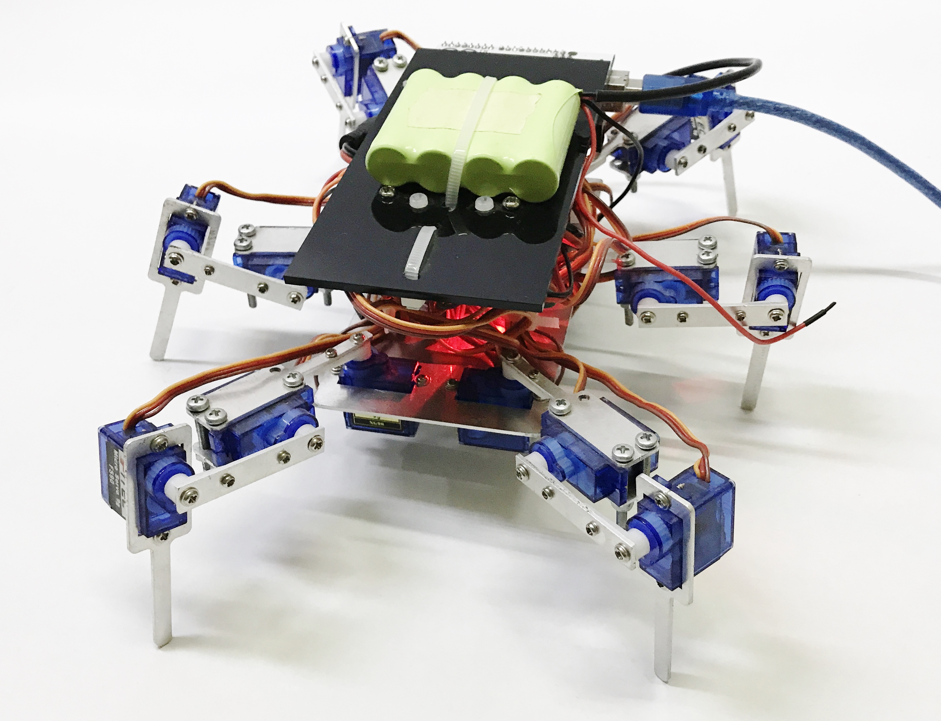
docs/img/uZagHexaFinalShadows.JPG
