RoboZag/zagHexa/docs/img/wpid-img_20121210_1227271.jpg

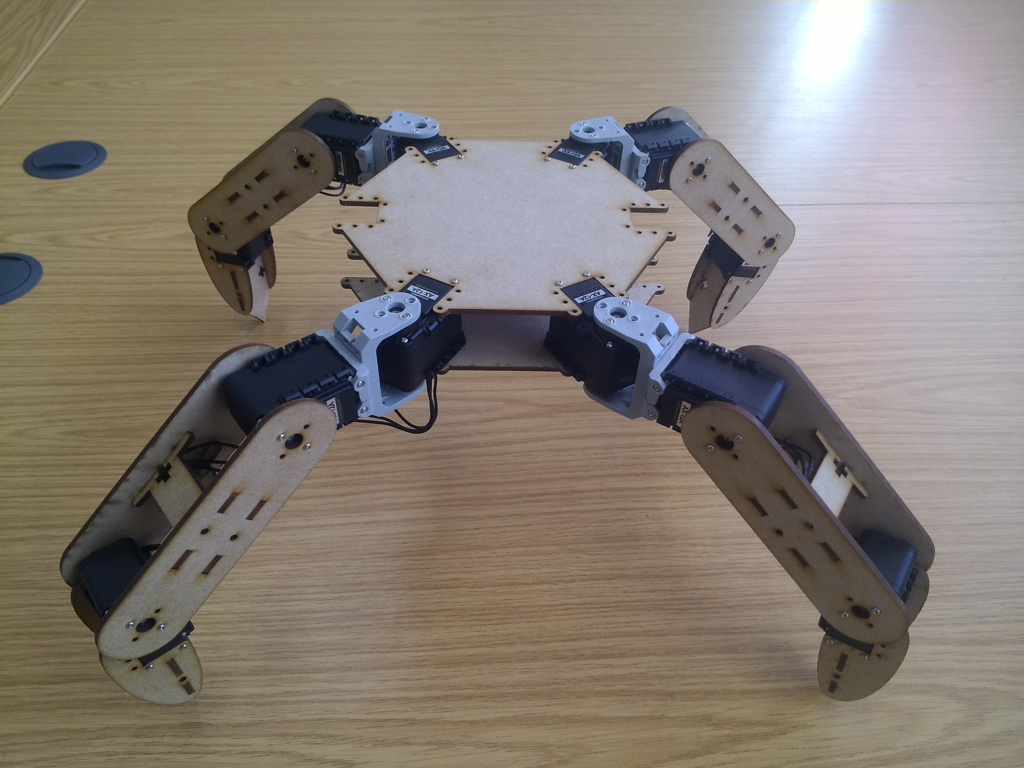
docs/img/wpid-img_20121210_1227271.jpg
