RoboZag/zagHexa/documents/finalReport/figures/9283982.png

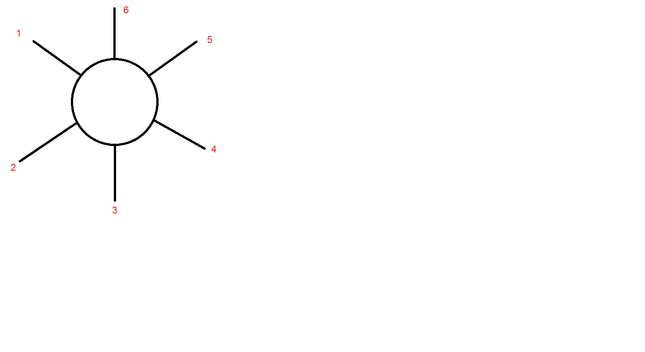
documents/finalReport/figures/9283982.png
