RoboZag/zagHexa/documents/finalReport/figures/1316341425.jpg

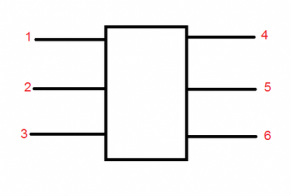
documents/finalReport/figures/1316341425.jpg
