RoboZag/zagHexa/documents/finalReport/figures/Architecture and Systems Integration.png

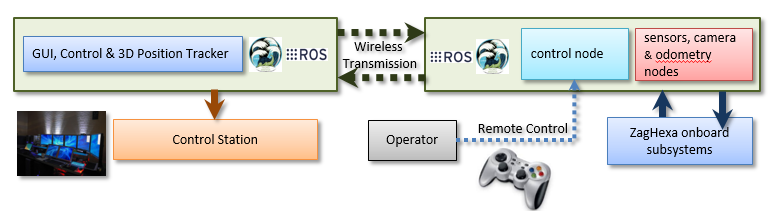
documents/finalReport/figures/Architecture and Systems Integration.png
