RoboZag/zagHexa/documents/finalReport/figures/axies.png

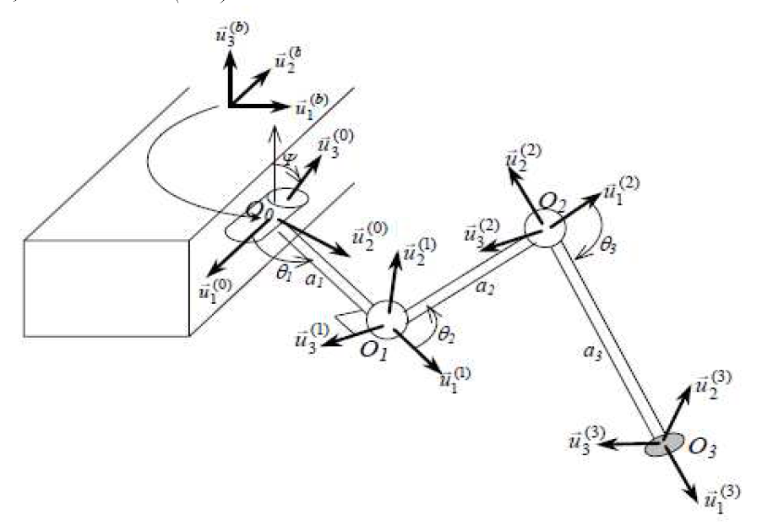
documents/finalReport/figures/axies.png
