RoboZag/zagHexa/documents/finalReport/figures/body motion.png

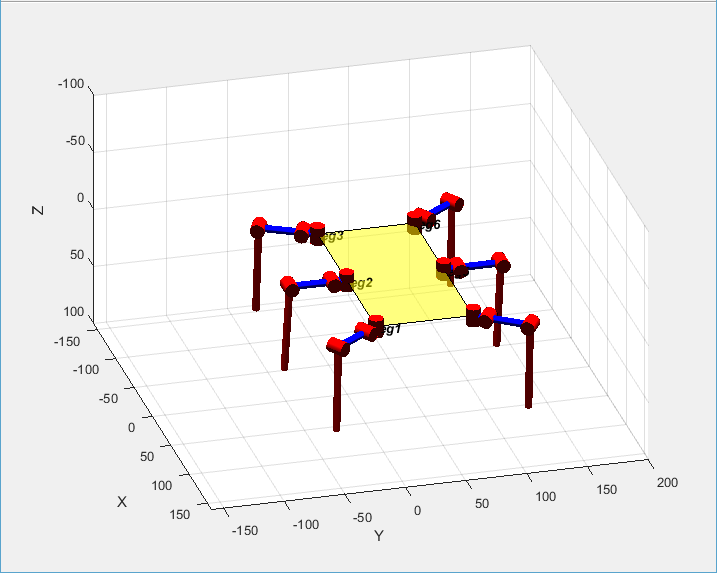
documents/finalReport/figures/body motion.png
