RoboZag/zagHexa/documents/finalReport/figures/Chassis.png

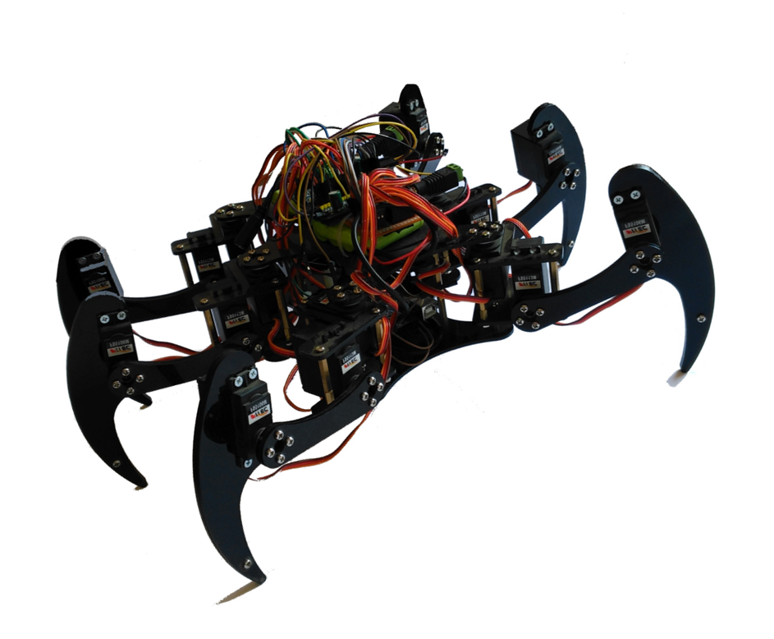
documents/finalReport/figures/Chassis.png
