RoboZag/zagHexa/documents/finalReport/figures/Communication system layout.jpg

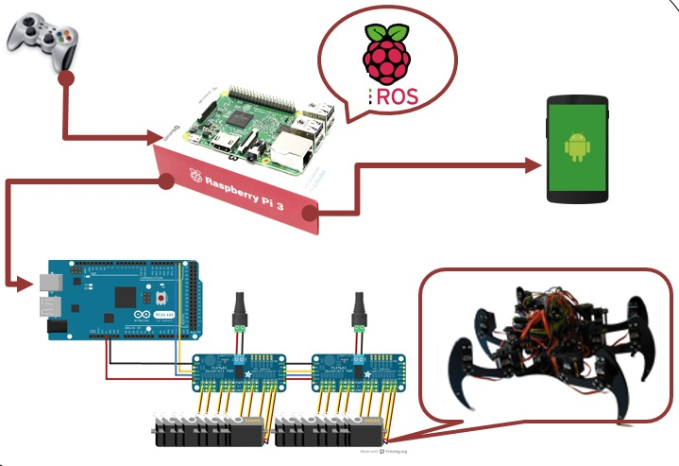
documents/finalReport/figures/Communication system layout.jpg
