RoboZag/zagHexa/documents/finalReport/figures/Control Layout.png

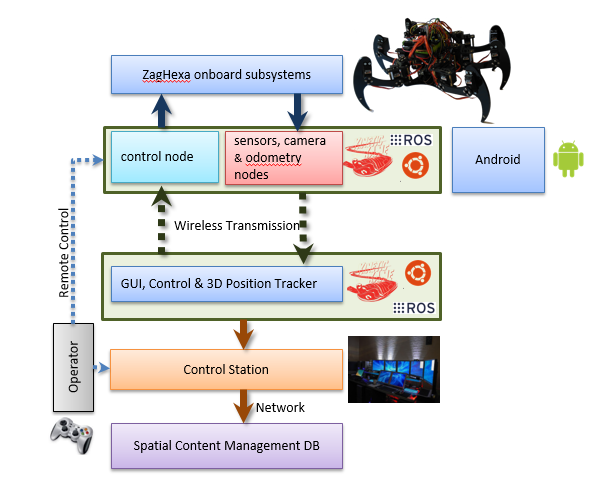
documents/finalReport/figures/Control Layout.png
