RoboZag/zagHexa/documents/finalReport/figures/fig1 sim.png

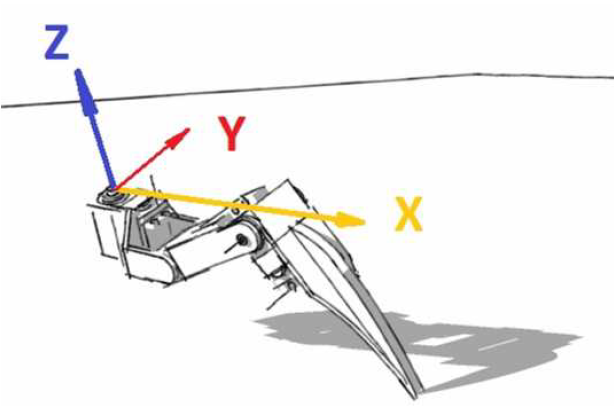
documents/finalReport/figures/fig1 sim.png
