RoboZag/zagHexa/documents/finalReport/figures/Fig1.png

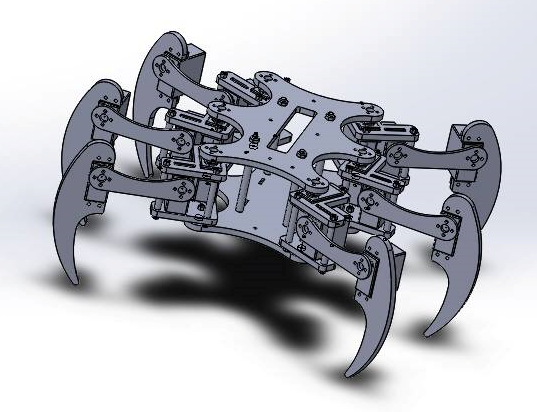
documents/finalReport/figures/Fig1.png
