RoboZag/zagHexa/documents/finalReport/figures/fig2 sim.png

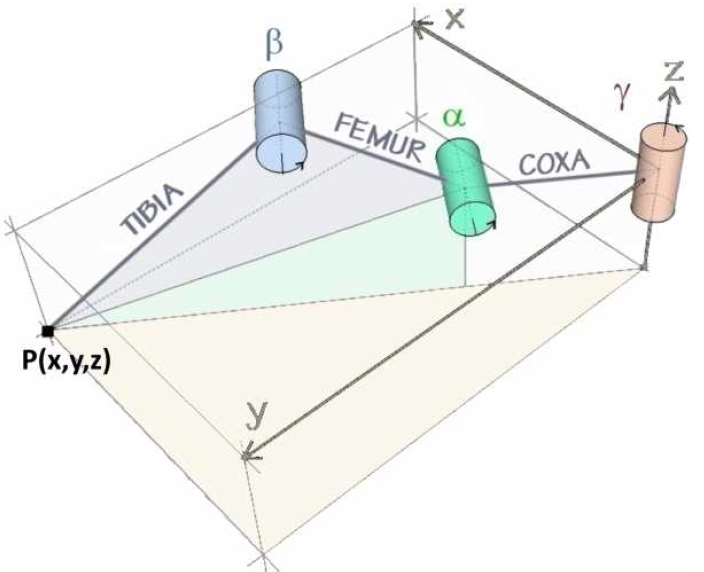
documents/finalReport/figures/fig2 sim.png
