RoboZag/zagHexa/documents/finalReport/figures/Fig4.png

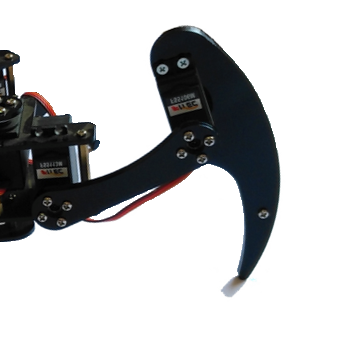
documents/finalReport/figures/Fig4.png
