RoboZag/zagHexa/documents/finalReport/figures/Fig5.jpg

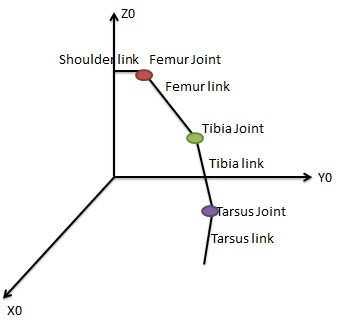
documents/finalReport/figures/Fig5.jpg
