RoboZag/zagHexa/documents/finalReport/figures/Fig6.png

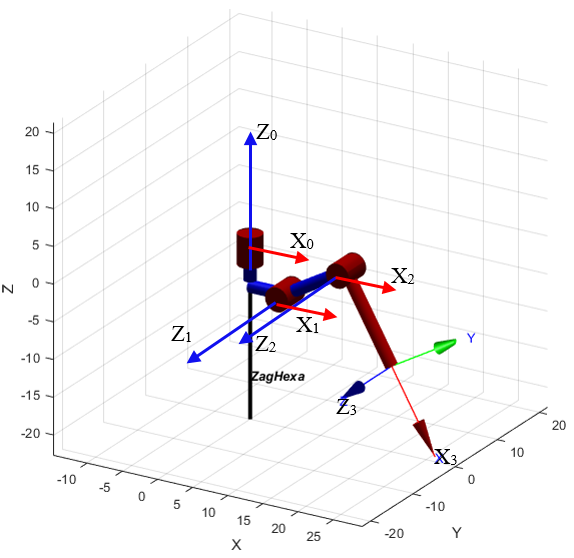
documents/finalReport/figures/Fig6.png
