RoboZag/zagHexa/documents/finalReport/figures/Fig9.jpg

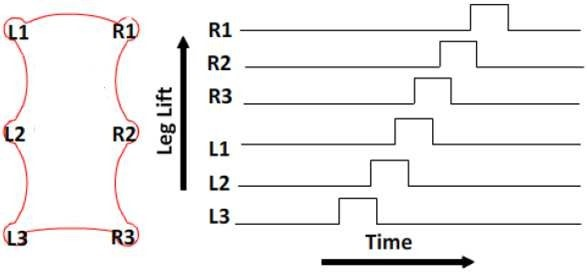
documents/finalReport/figures/Fig9.jpg
