RoboZag/zagHexa/documents/finalReport/figures/Fig10.jpg

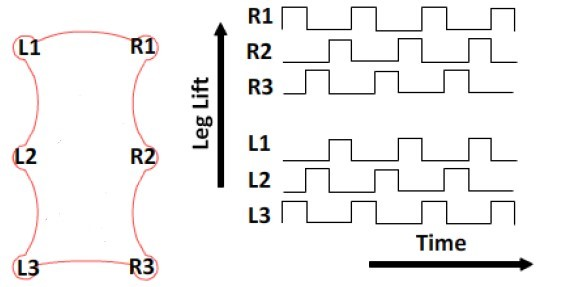
documents/finalReport/figures/Fig10.jpg
