RoboZag/zagHexa/documents/finalReport/figures/Fig11.jpg

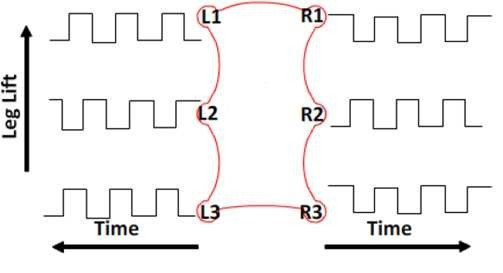
documents/finalReport/figures/Fig11.jpg
