RoboZag/zagHexa/documents/finalReport/figures/FS.png

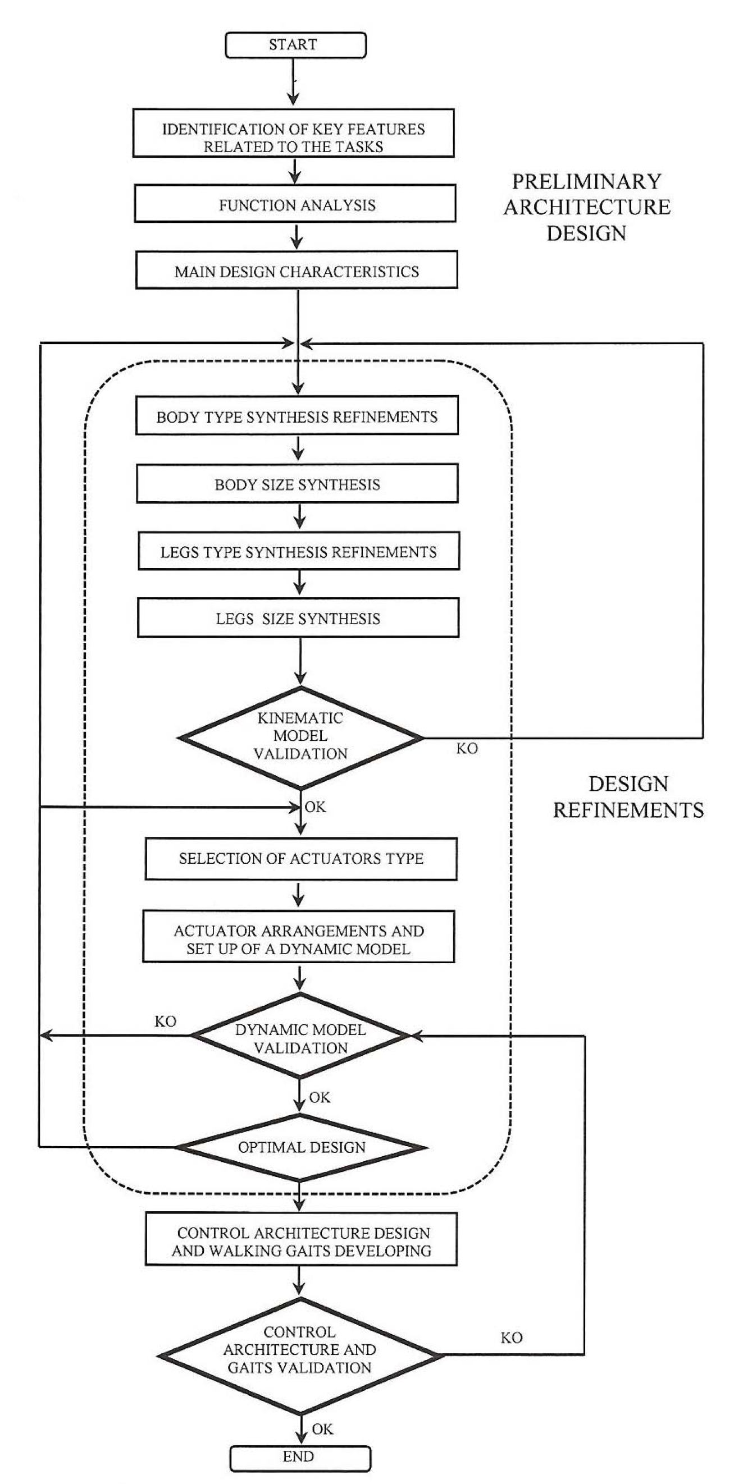
documents/finalReport/figures/FS.png
