RoboZag/zagHexa/documents/finalReport/figures/leg motion.png

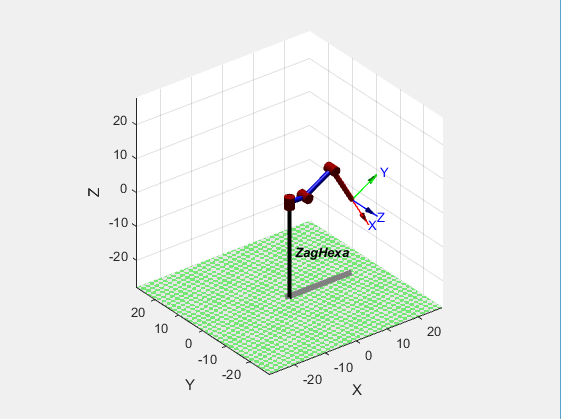
documents/finalReport/figures/leg motion.png
