RoboZag/zagHexa/documents/finalReport/figures/OC.png

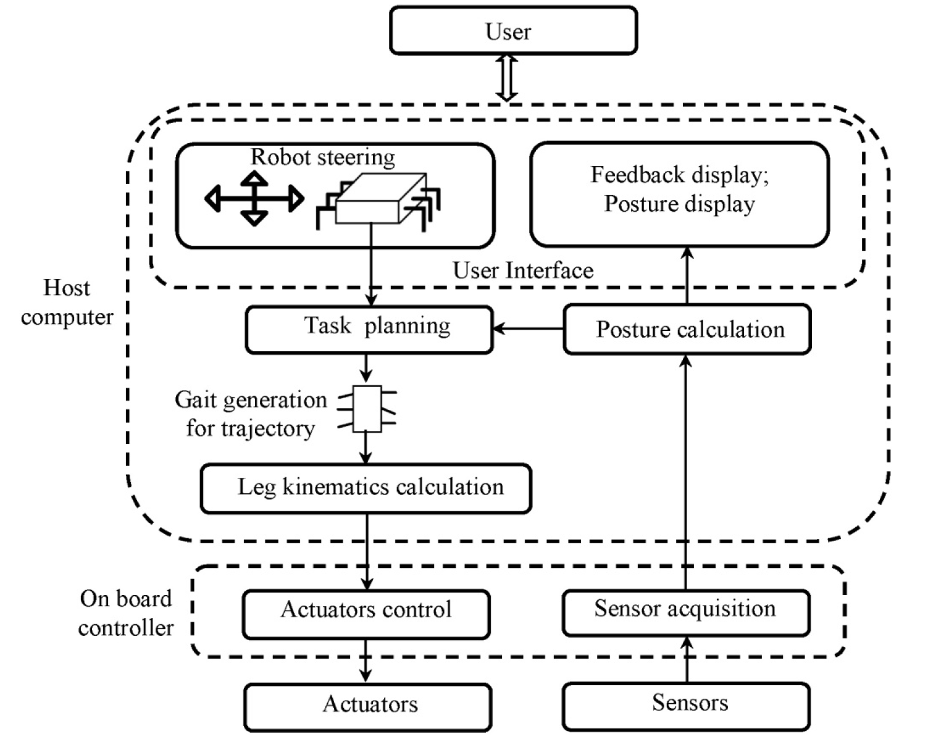
documents/finalReport/figures/OC.png
