RoboZag/zagHexa/documents/finalReport/figures/RP3.png

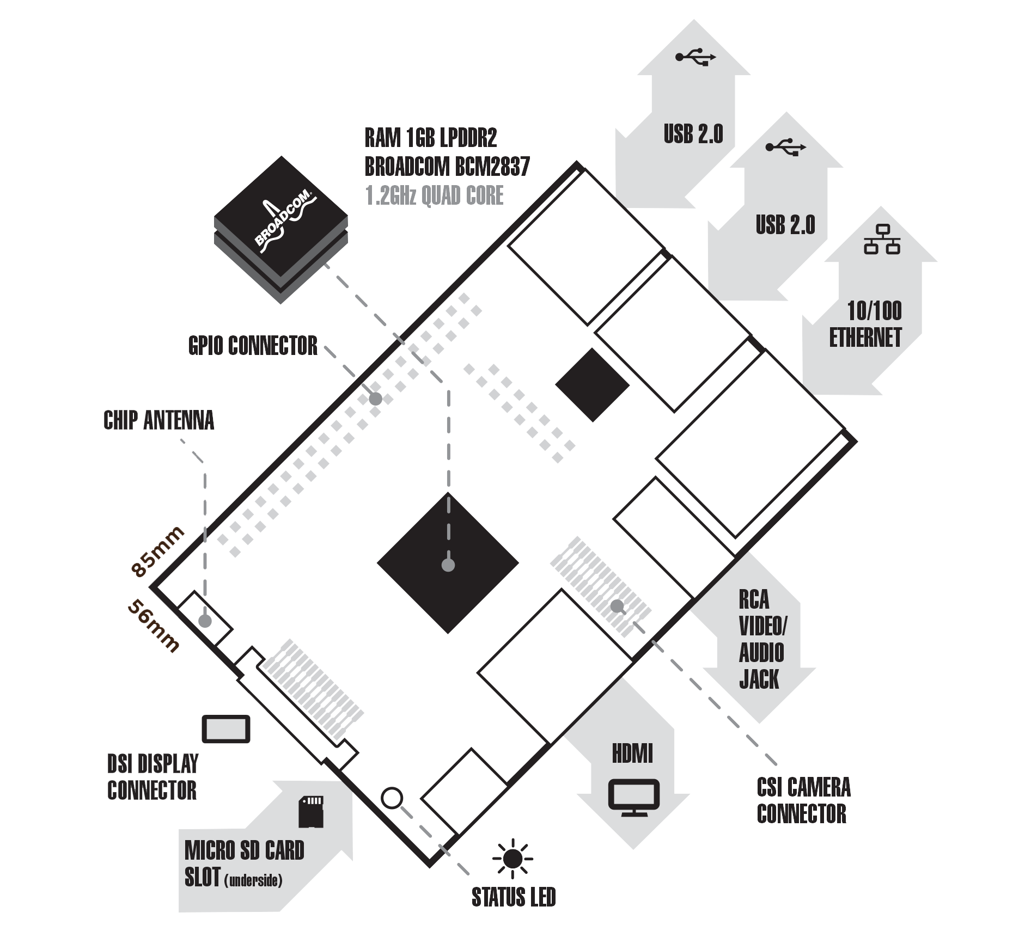
documents/finalReport/figures/RP3.png
