RoboZag/zagHexa/documents/finalReport/figures/System Design and Control.png

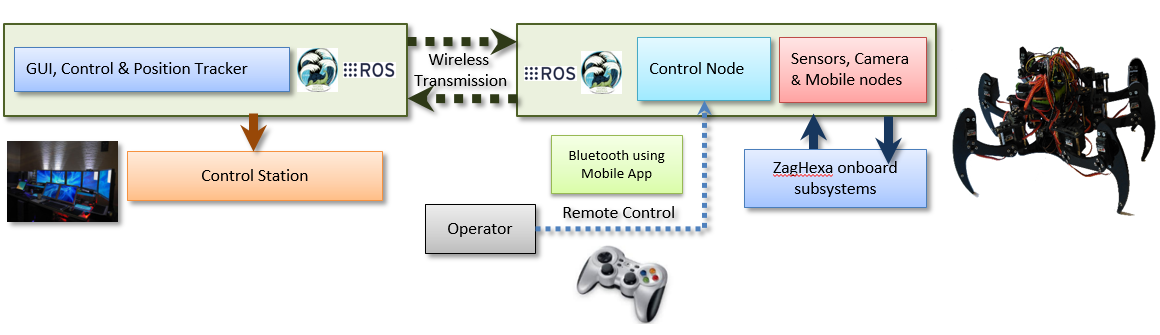
documents/finalReport/figures/System Design and Control.png
