RoboZag/zagHexa/documents/finalReport/figures/The Progression of the Mechanical Design of the Vehicle.jpg

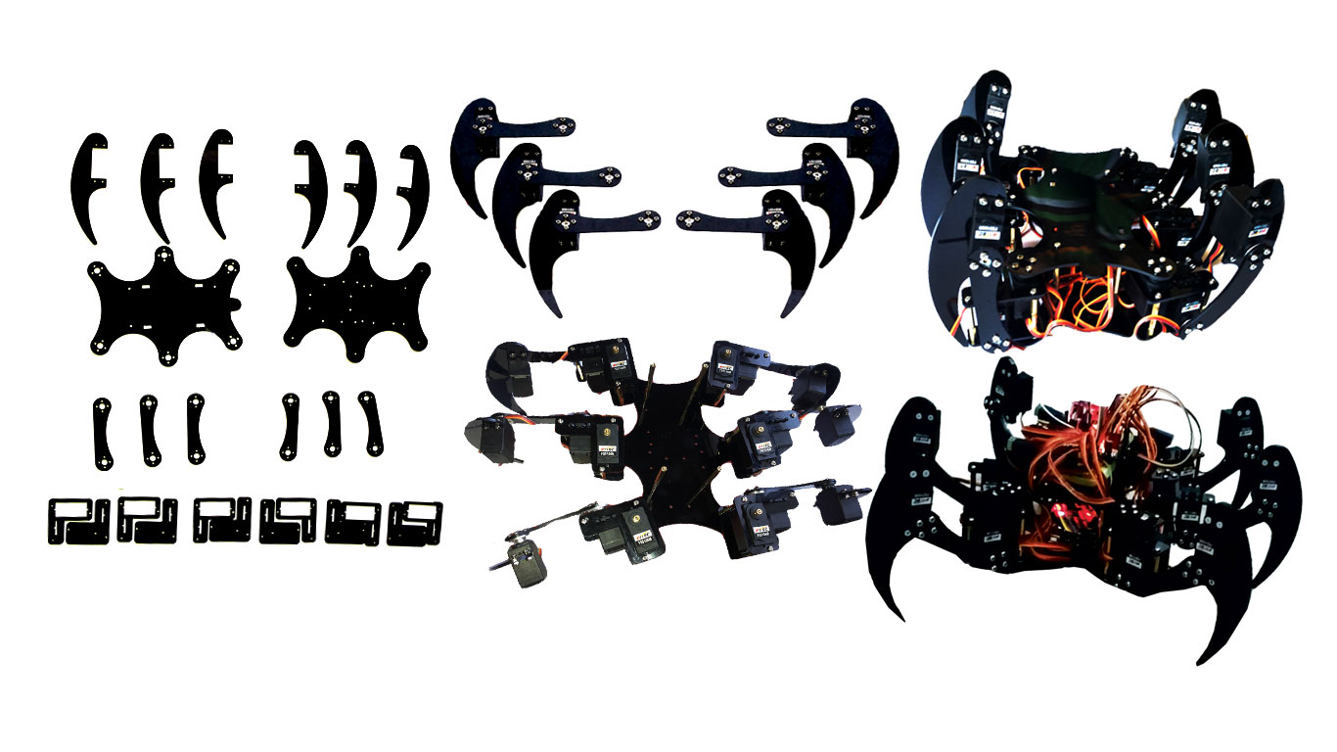
documents/finalReport/figures/The Progression of the Mechanical Design of the Vehicle.jpg
