RoboZag/zagHexa/documents/finalReport/figures/walking pattern.png

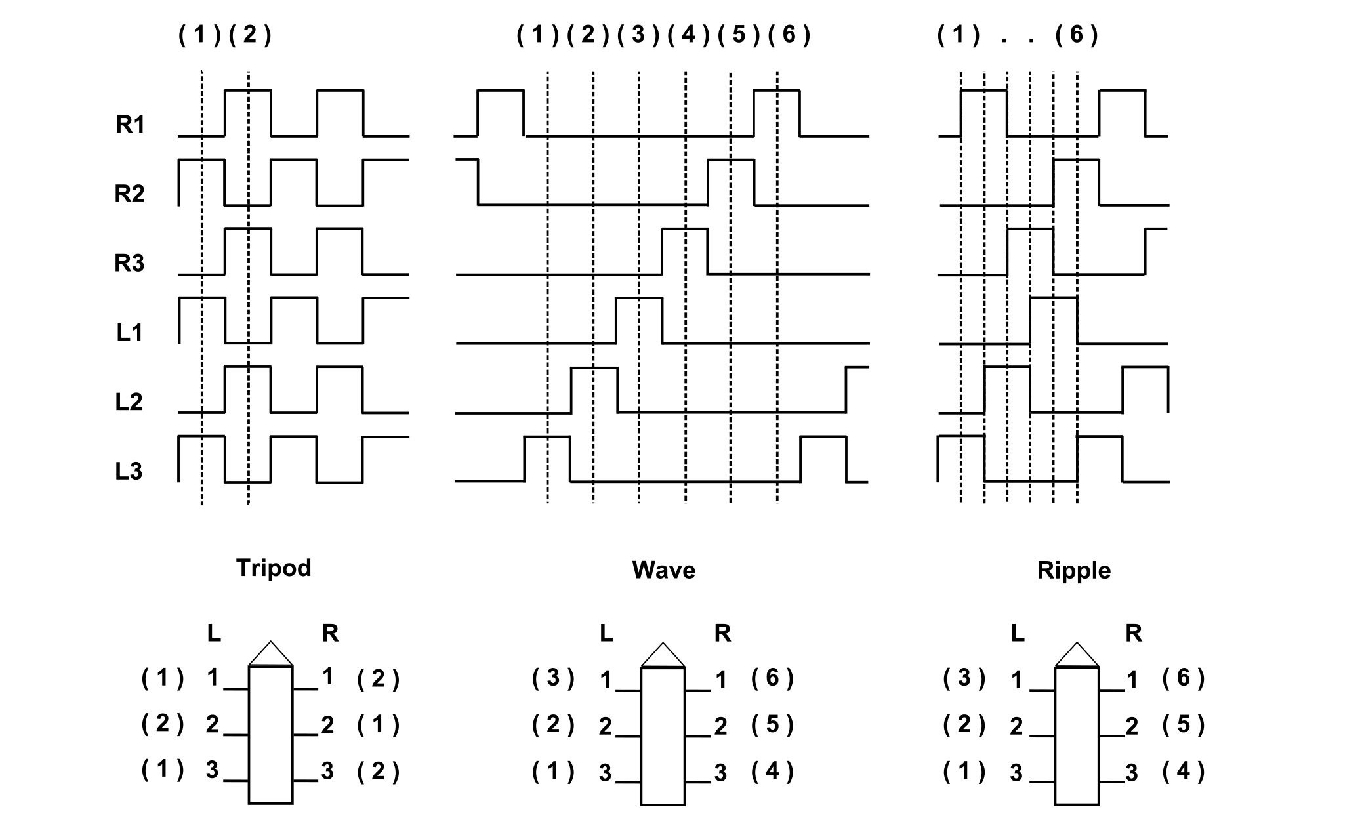
documents/finalReport/figures/walking pattern.png
