RoboZag/zagHexa/documents/finalReport/figures/walking.jpg

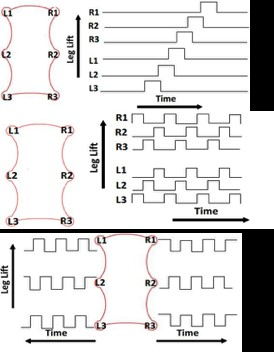
documents/finalReport/figures/walking.jpg
