RoboZag/zagHexa/documents/finalReport/figures/walking.png

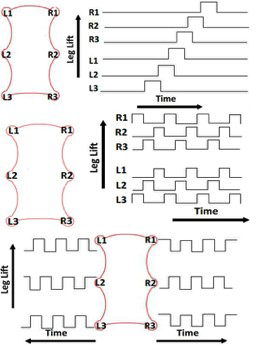
documents/finalReport/figures/walking.png
