RoboZag/zagHexa/documents/Media/Giant ZagHexa/Giant ZagHexa (2).JPG

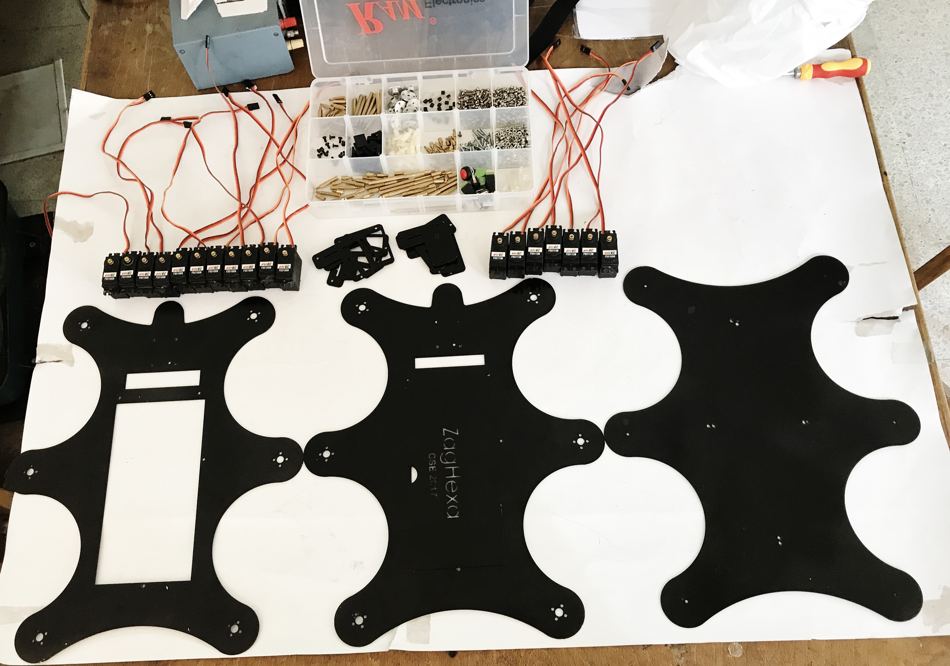
documents/Media/Giant ZagHexa/Giant ZagHexa (2).JPG
