RoboZag/zagHexa/documents/Media/Giant ZagHexa/Giant ZagHexa (3).JPG

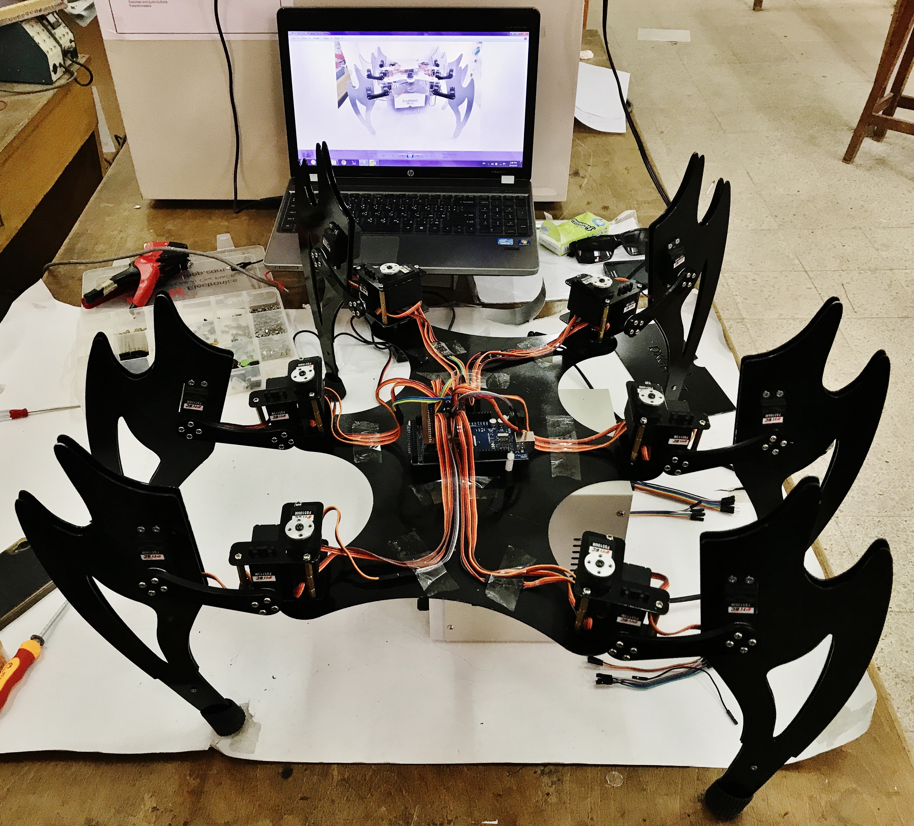
documents/Media/Giant ZagHexa/Giant ZagHexa (3).JPG
