RoboZag/zagHexa/documents/Media/Giant ZagHexa/Giant ZagHexa (4).JPG

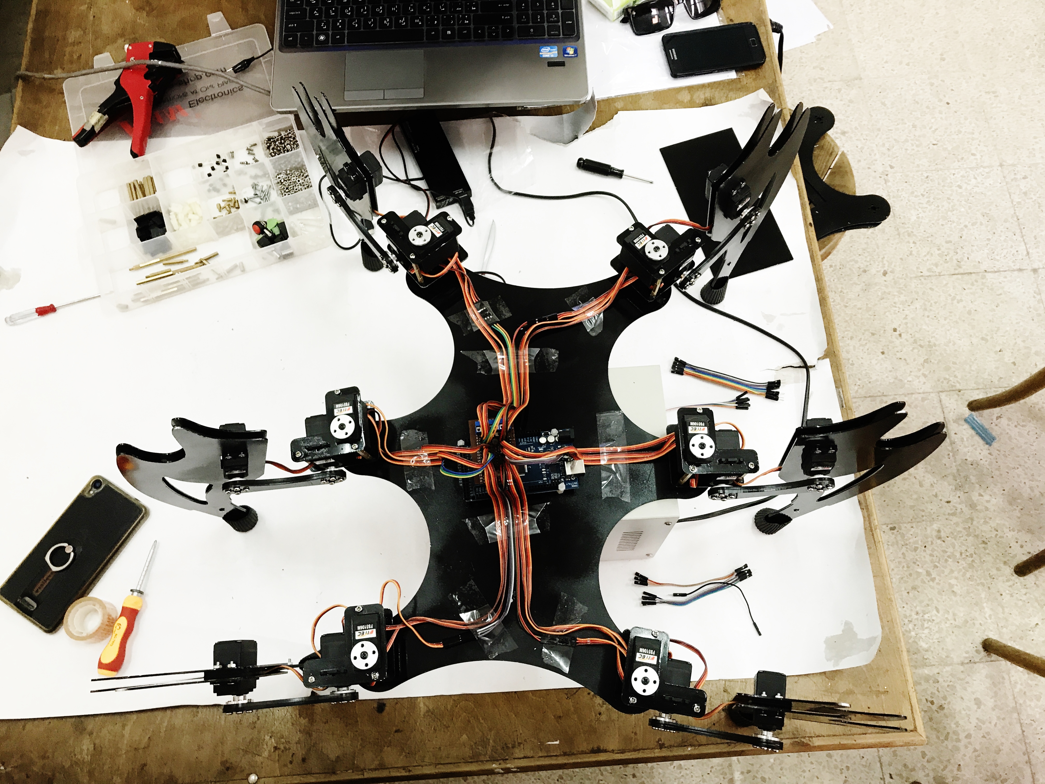
documents/Media/Giant ZagHexa/Giant ZagHexa (4).JPG
