RoboZag/zagHexa/documents/Media/Giant ZagHexa/Giant ZagHexa (6).JPG

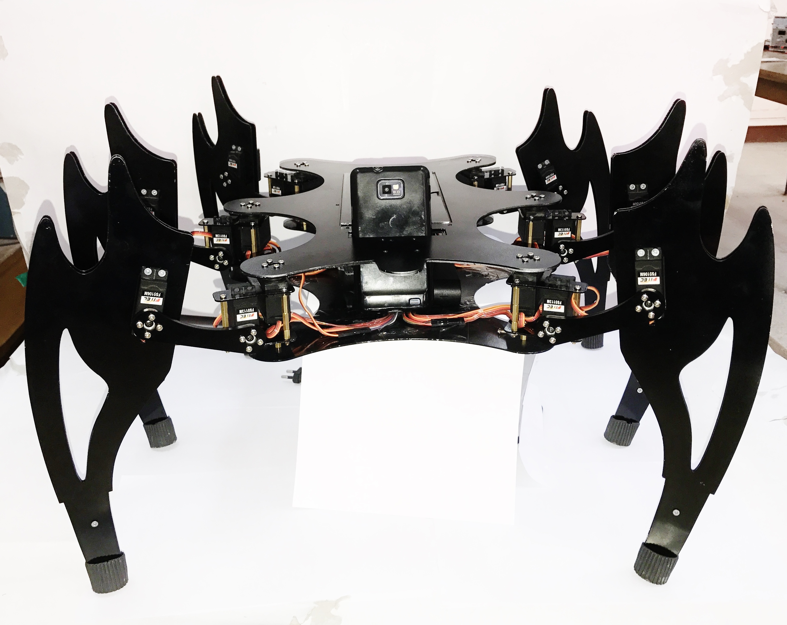
documents/Media/Giant ZagHexa/Giant ZagHexa (6).JPG
