RoboZag/zagHexa/documents/Media/Giant ZagHexa/Giant ZagHexa (7).JPG

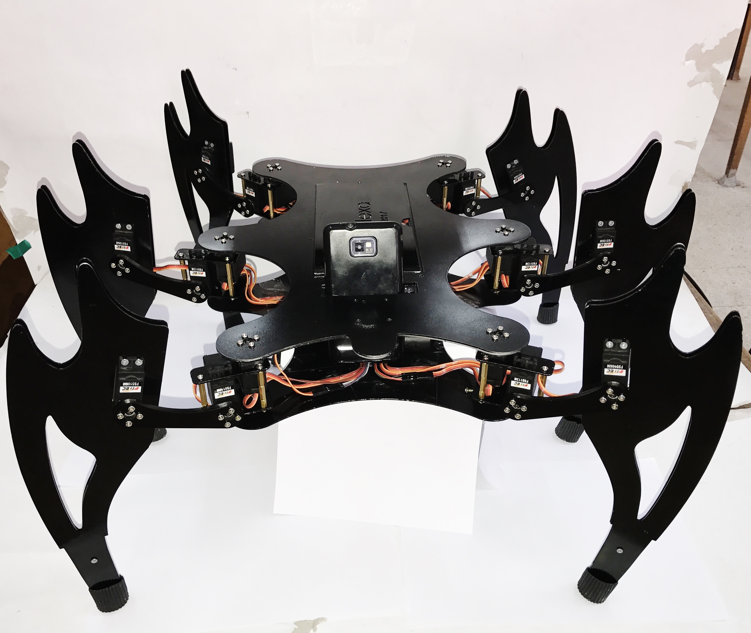
documents/Media/Giant ZagHexa/Giant ZagHexa (7).JPG
