RoboZag/zagHexa/documents/Media/Giant ZagHexa/Giant ZagHexa (8).JPG

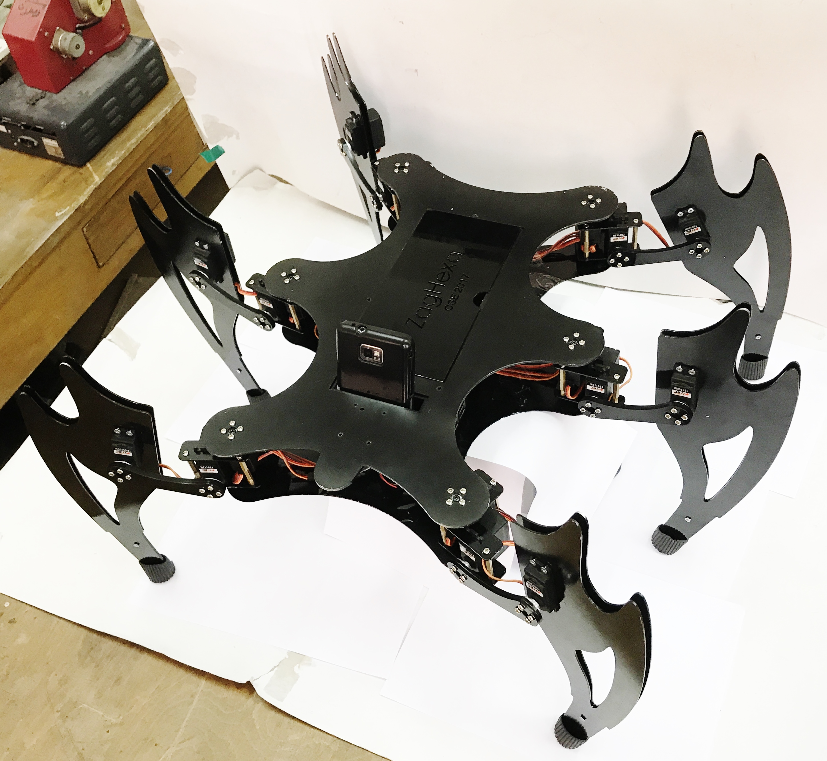
documents/Media/Giant ZagHexa/Giant ZagHexa (8).JPG
