RoboZag/zagHexa/documents/Media/Giant ZagHexa/Giant ZagHexa (9).JPG

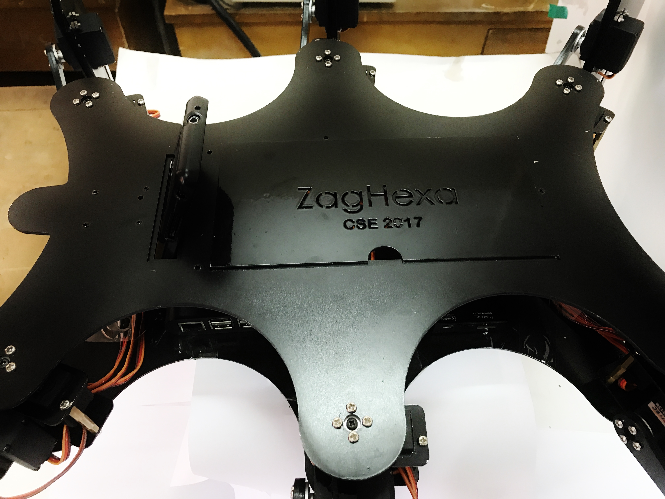
documents/Media/Giant ZagHexa/Giant ZagHexa (9).JPG
