RoboZag/zagHexa/documents/Media/Giant ZagHexa/Giant ZagHexa (10).JPG

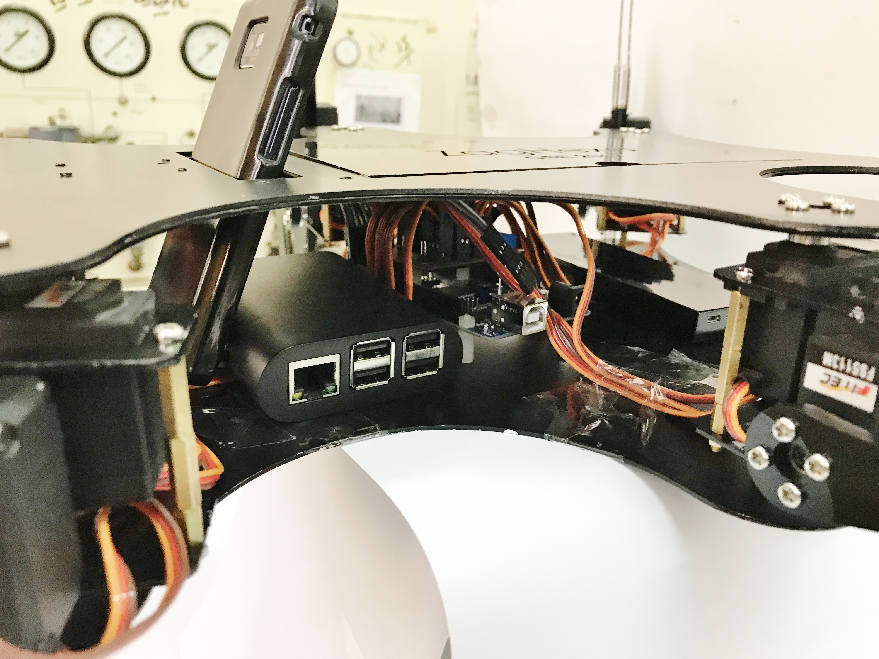
documents/Media/Giant ZagHexa/Giant ZagHexa (10).JPG
