RoboZag/zagHexa/documents/Media/Giant ZagHexa/Giant ZagHexa (11).JPG

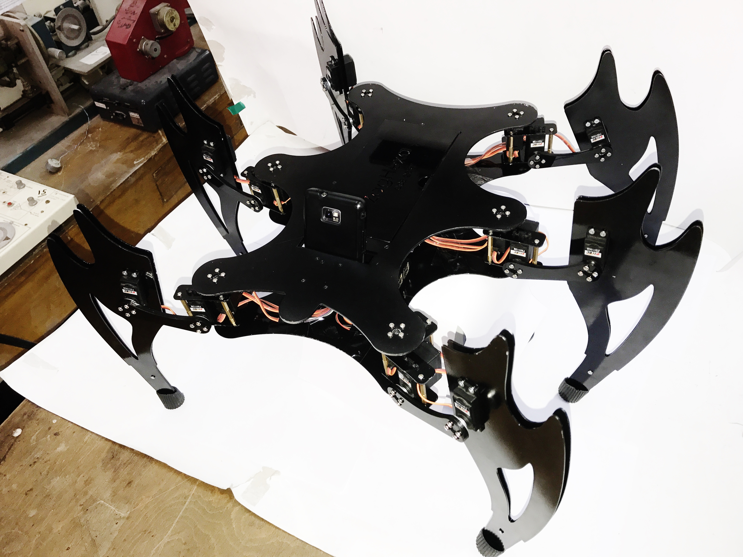
documents/Media/Giant ZagHexa/Giant ZagHexa (11).JPG
