RoboZag/zagHexa/documents/Media/Giant ZagHexa/Giant ZagHexa (12).JPG

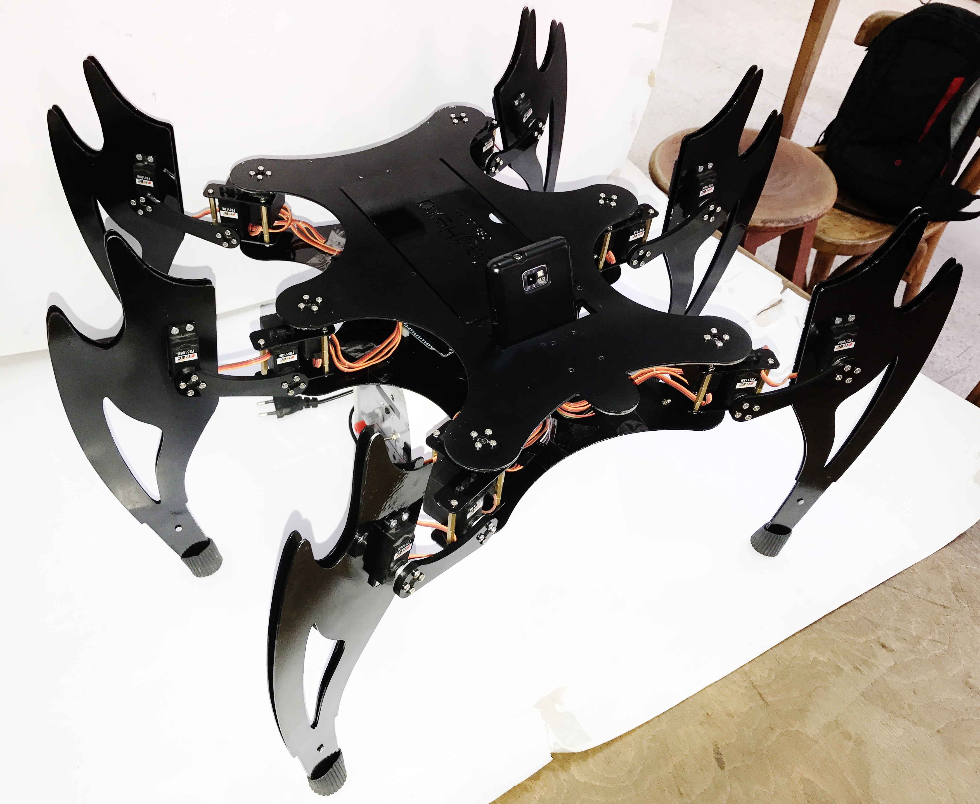
documents/Media/Giant ZagHexa/Giant ZagHexa (12).JPG
