RoboZag/zagHexa/documents/Media/Giant ZagHexa/Giant ZagHexa (13).JPG

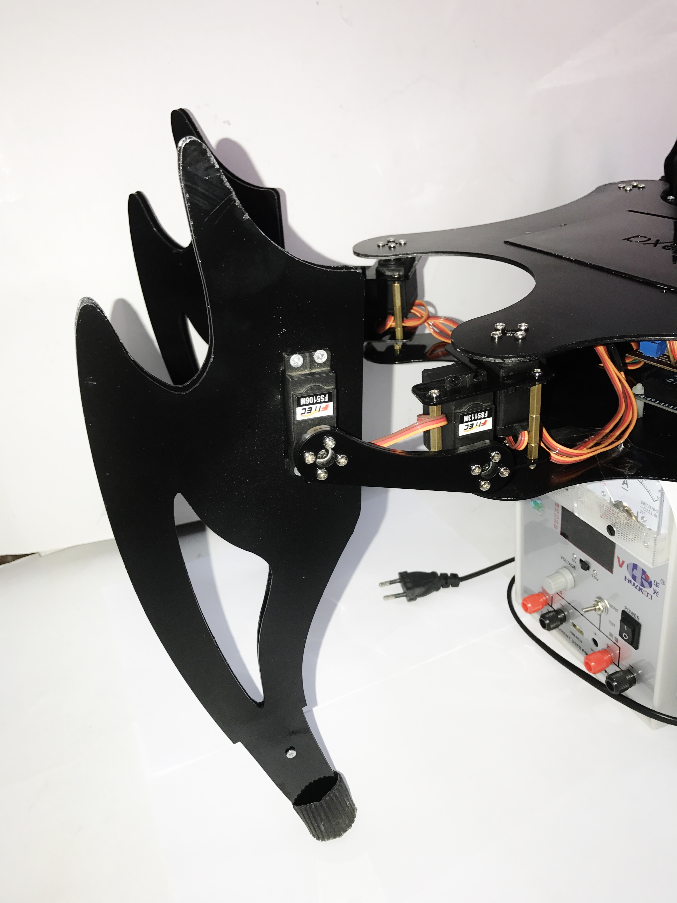
documents/Media/Giant ZagHexa/Giant ZagHexa (13).JPG
