RoboZag/zagHexa/documents/Media/Giant ZagHexa/Giant ZagHexa (14).JPG

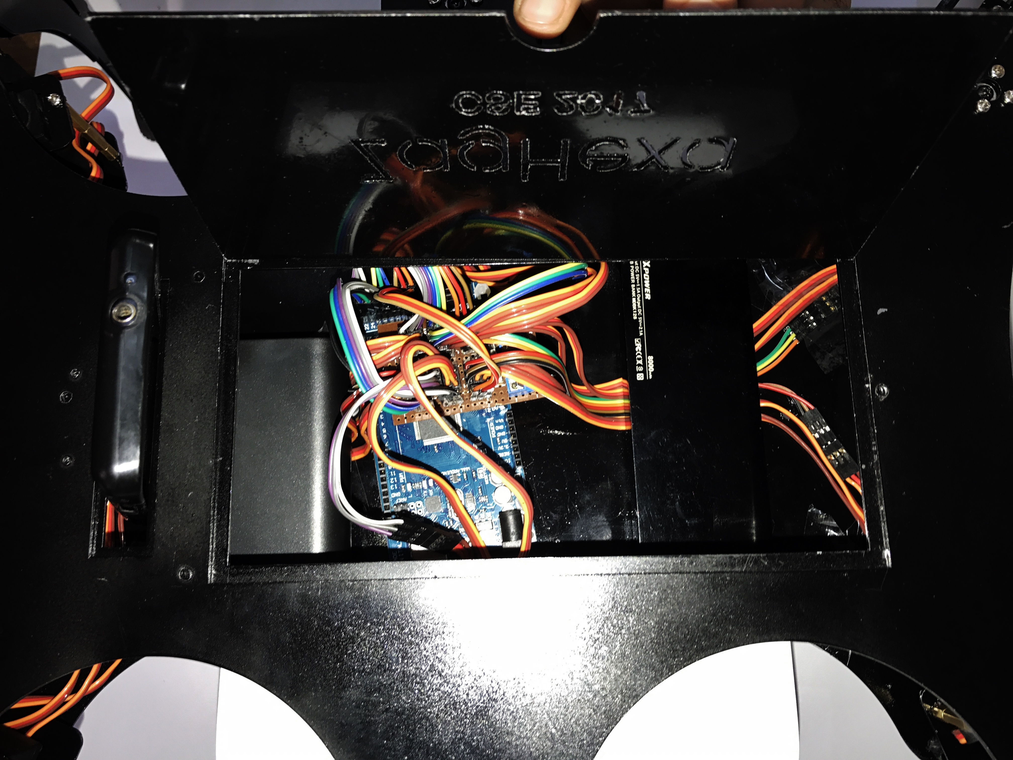
documents/Media/Giant ZagHexa/Giant ZagHexa (14).JPG
