RoboZag/zagHexa/documents/Media/Giant ZagHexa/Giant ZagHexa (15).JPG

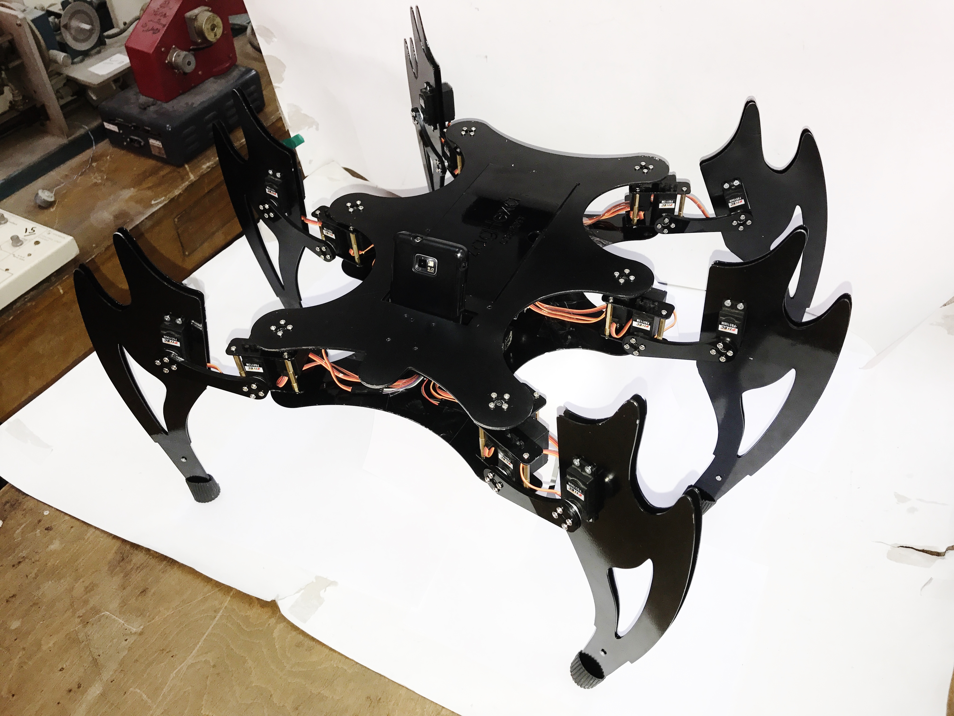
documents/Media/Giant ZagHexa/Giant ZagHexa (15).JPG
