RoboZag/zagHexa/documents/Media/Giant ZagHexa/Giant ZagHexa (16).JPG

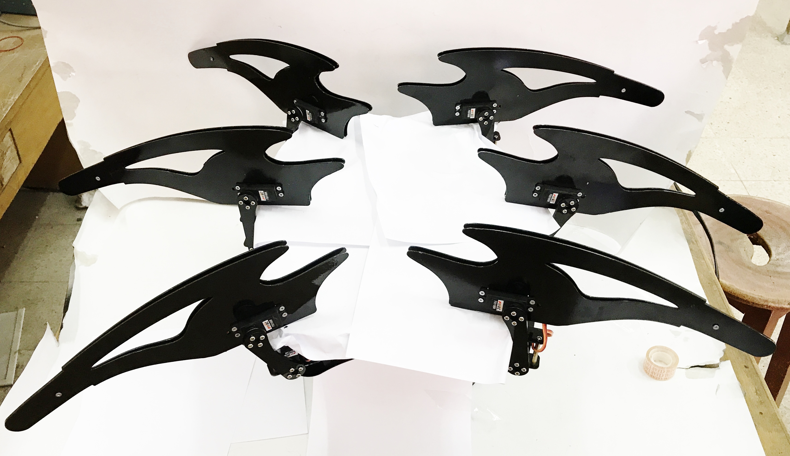
documents/Media/Giant ZagHexa/Giant ZagHexa (16).JPG
