RoboZag/zagHexa/documents/Media/Giant ZagHexa/Giant ZagHexa (17).JPG

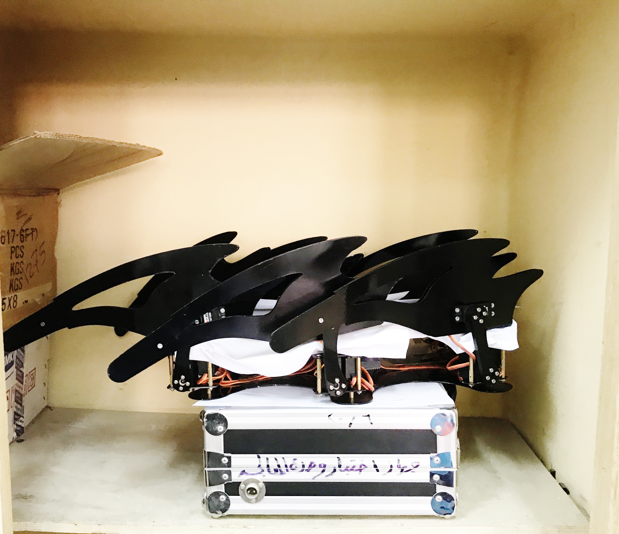
documents/Media/Giant ZagHexa/Giant ZagHexa (17).JPG
