RoboZag/zagHexa/documents/Media/Giant ZagHexa/Giant ZagHexa (18).JPG

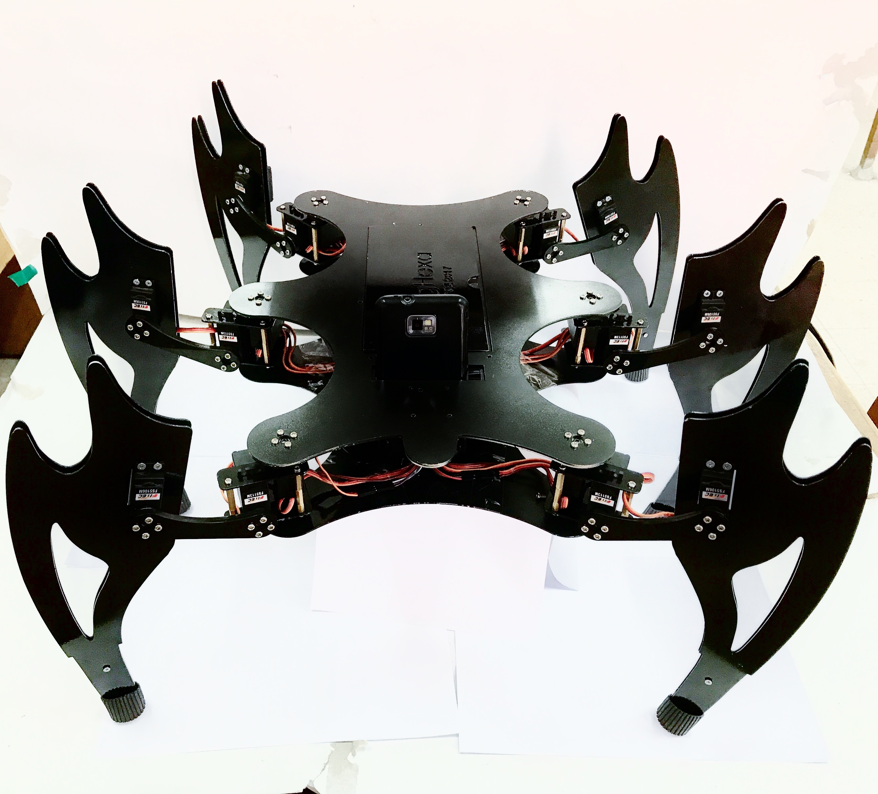
documents/Media/Giant ZagHexa/Giant ZagHexa (18).JPG
