RoboZag/zagHexa/documents/Media/Micro ZagHexa/Micro ZagHexa (1).JPG

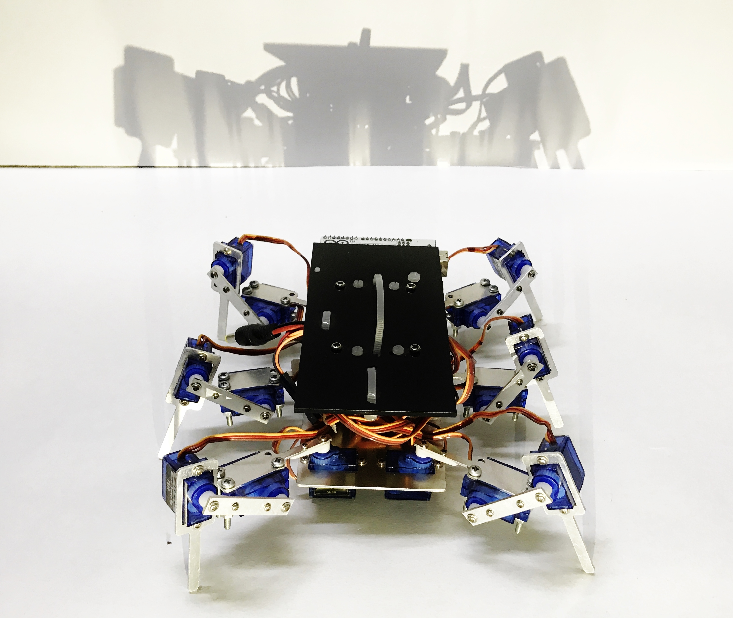
documents/Media/Micro ZagHexa/Micro ZagHexa (1).JPG
