RoboZag/zagHexa/documents/Media/Micro ZagHexa/Micro ZagHexa (2).JPG

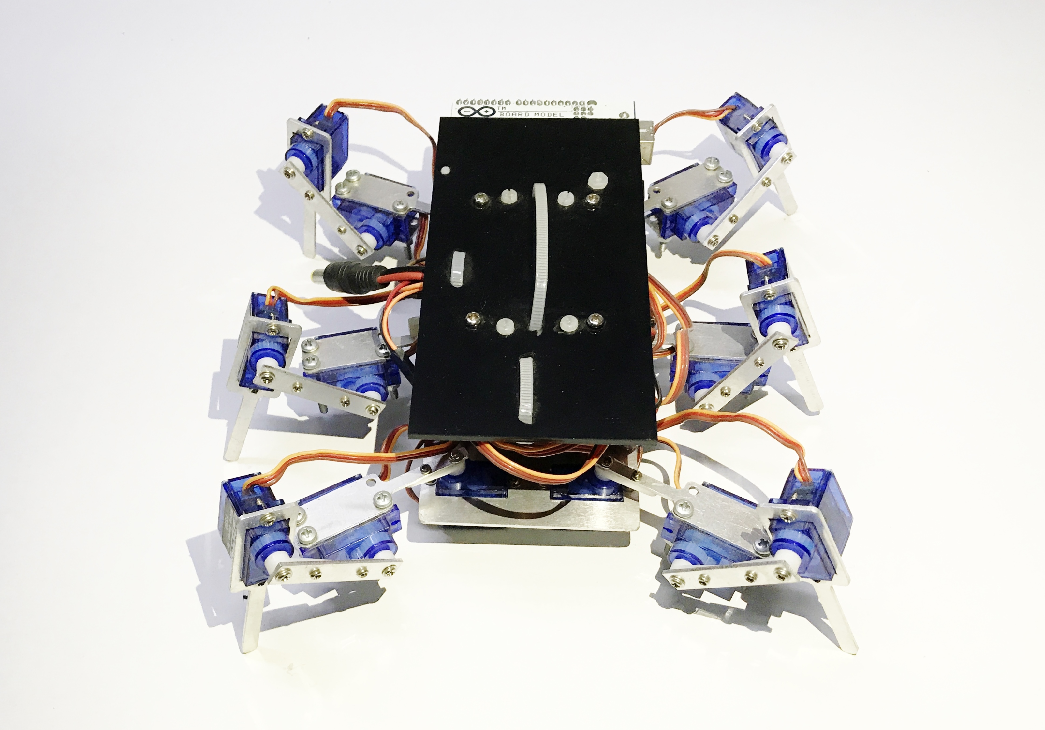
documents/Media/Micro ZagHexa/Micro ZagHexa (2).JPG
