RoboZag/zagHexa/documents/Media/Micro ZagHexa/Micro ZagHexa (3).JPG

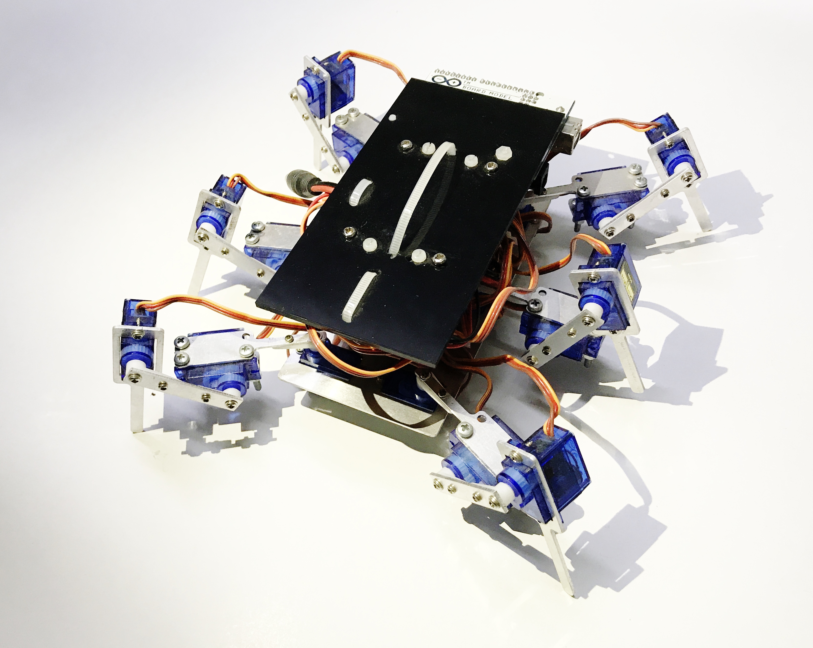
documents/Media/Micro ZagHexa/Micro ZagHexa (3).JPG
