RoboZag/zagHexa/documents/Media/Micro ZagHexa/Micro ZagHexa (4).JPG

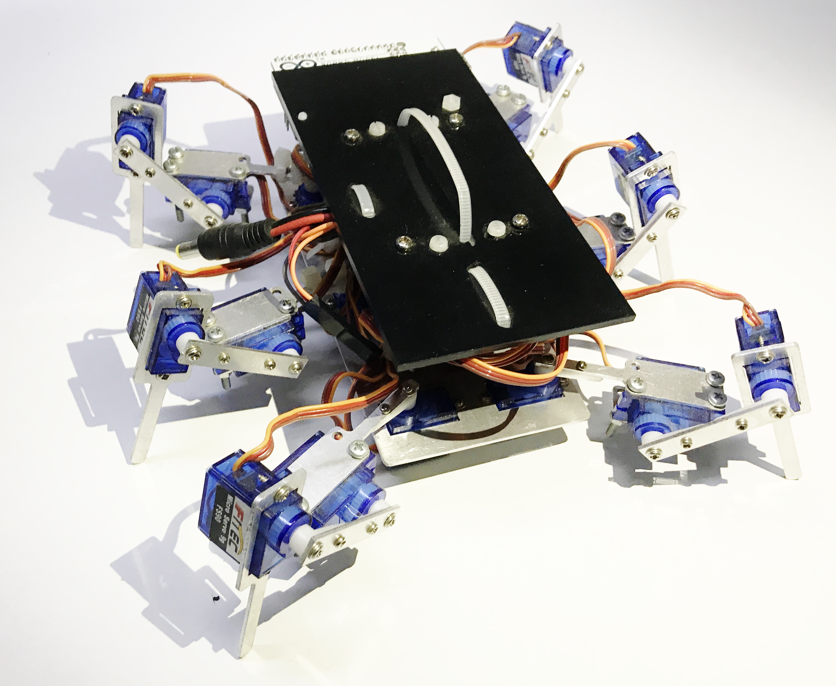
documents/Media/Micro ZagHexa/Micro ZagHexa (4).JPG
