RoboZag/zagHexa/documents/Media/Micro ZagHexa/Micro ZagHexa (5).JPG

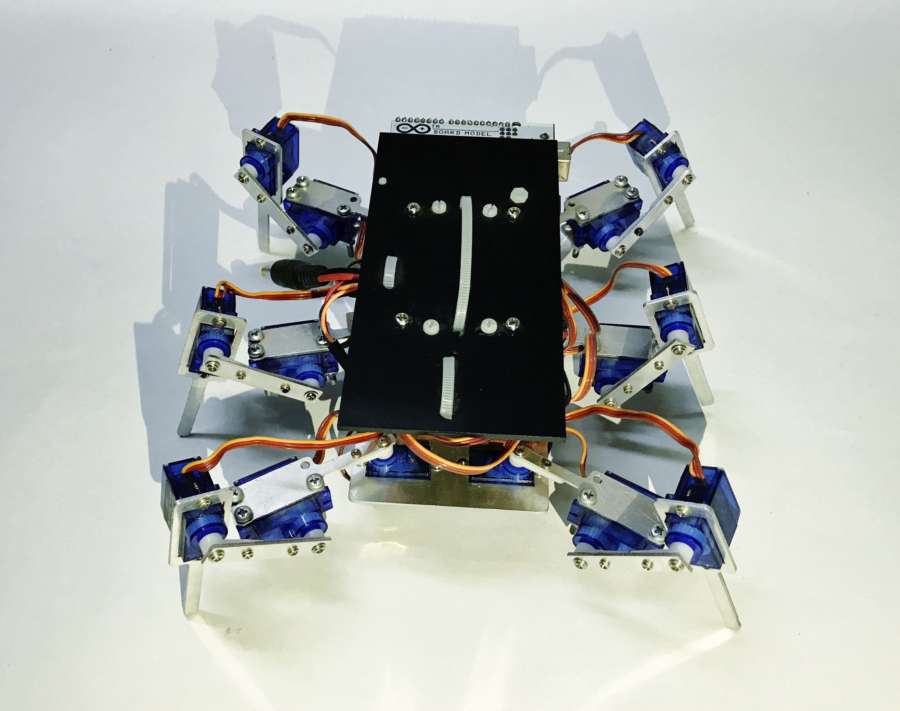
documents/Media/Micro ZagHexa/Micro ZagHexa (5).JPG
