RoboZag/zagHexa/documents/Media/Micro ZagHexa/Micro ZagHexa (6).JPG

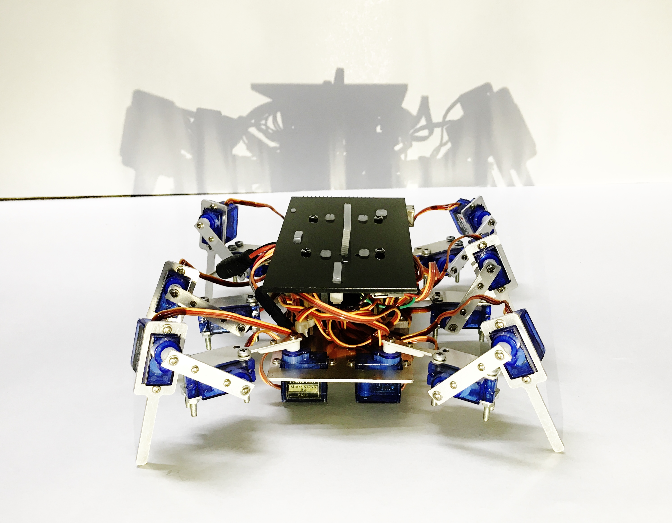
documents/Media/Micro ZagHexa/Micro ZagHexa (6).JPG
