RoboZag/zagHexa/documents/Media/Micro ZagHexa/Micro ZagHexa (7).JPG

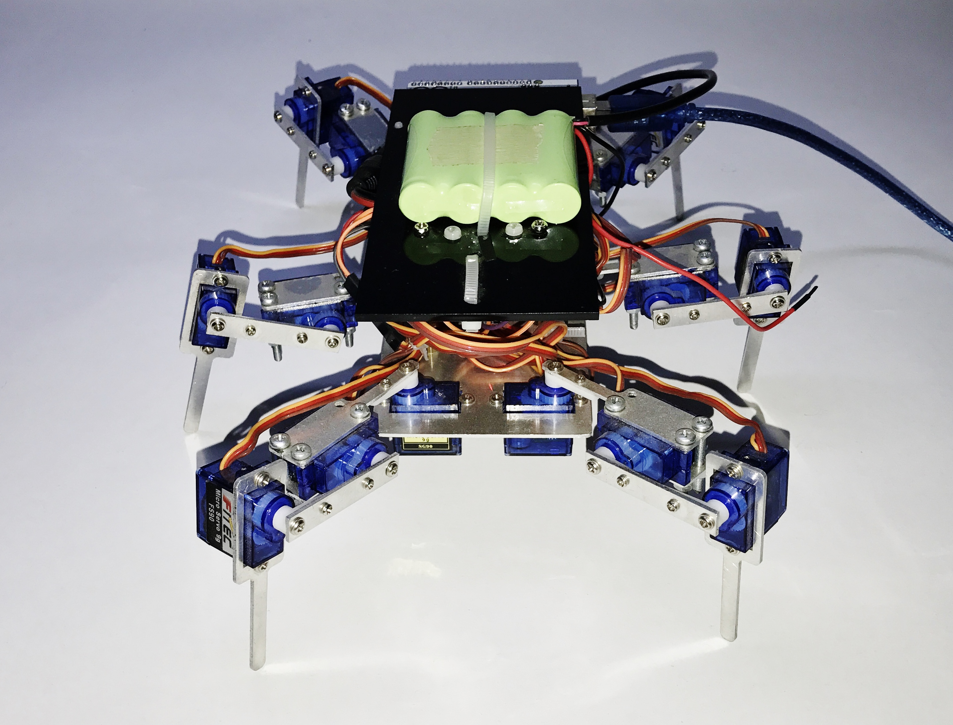
documents/Media/Micro ZagHexa/Micro ZagHexa (7).JPG
