RoboZag/zagHexa/documents/Media/Micro ZagHexa/Micro ZagHexa (8).JPG

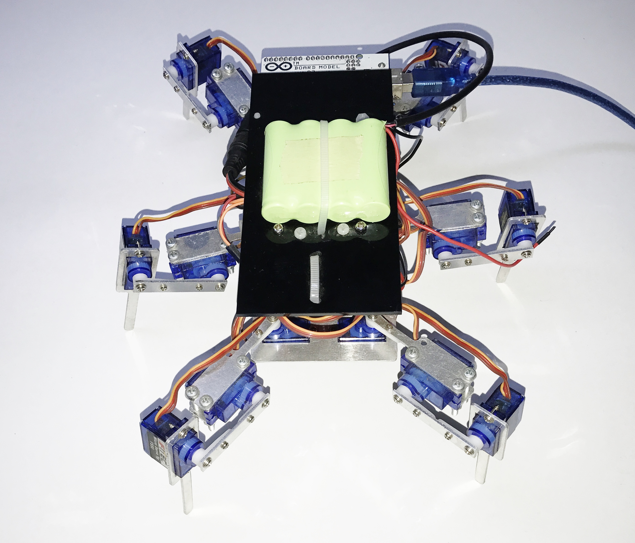
documents/Media/Micro ZagHexa/Micro ZagHexa (8).JPG
