RoboZag/zagHexa/documents/Media/Micro ZagHexa/Micro ZagHexa (9).JPG

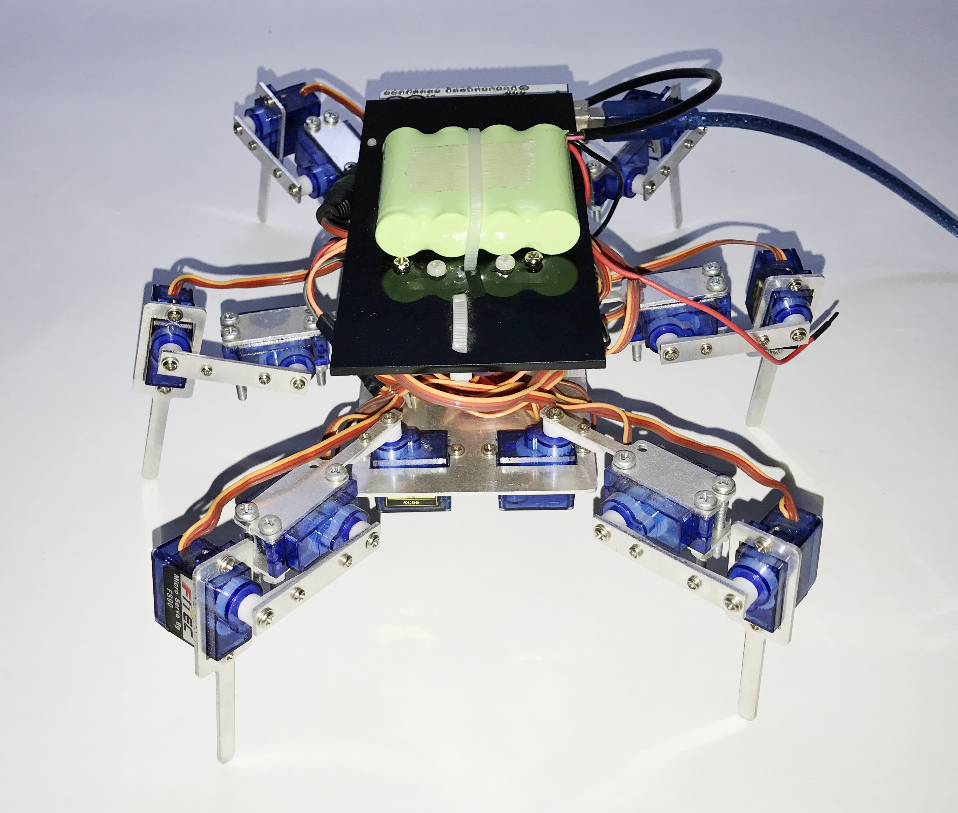
documents/Media/Micro ZagHexa/Micro ZagHexa (9).JPG
