RoboZag/zagHexa/documents/Media/Micro ZagHexa/Micro ZagHexa (10).JPG

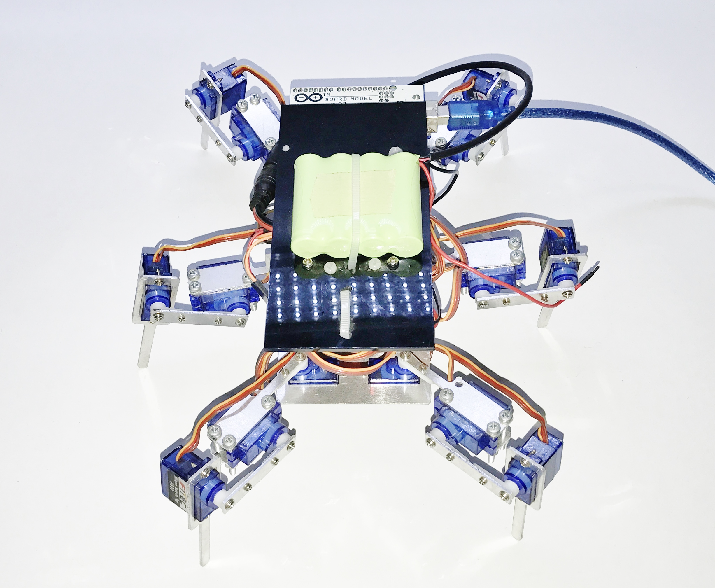
documents/Media/Micro ZagHexa/Micro ZagHexa (10).JPG
