RoboZag/zagHexa/documents/Media/ZagHexa/ZagHexa (1).JPG

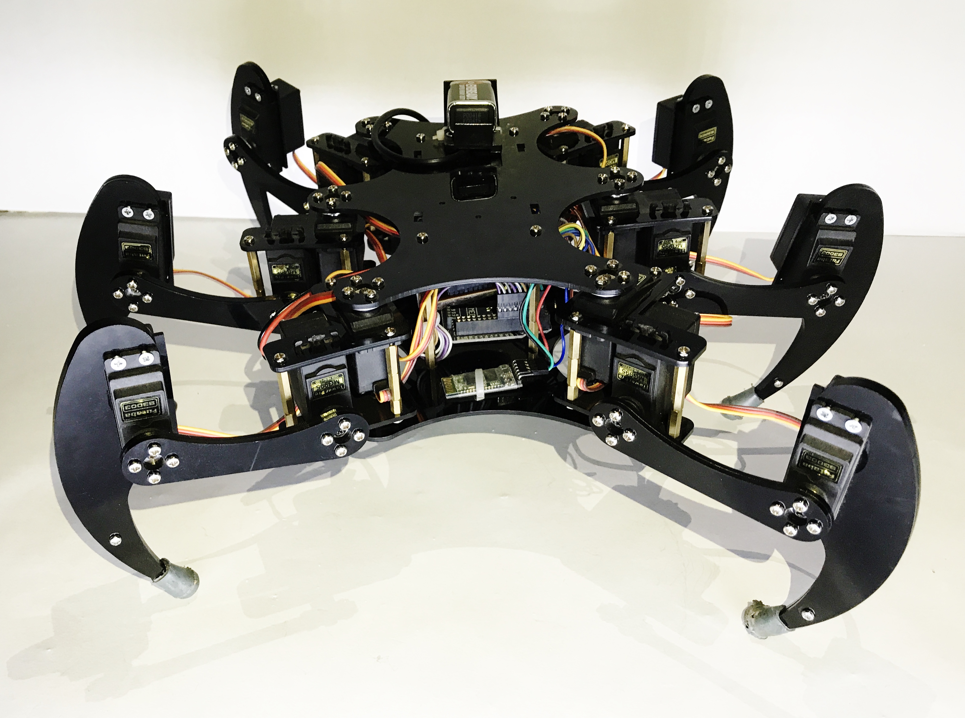
documents/Media/ZagHexa/ZagHexa (1).JPG
