RoboZag/zagHexa/documents/Media/ZagHexa/ZagHexa (2).JPG

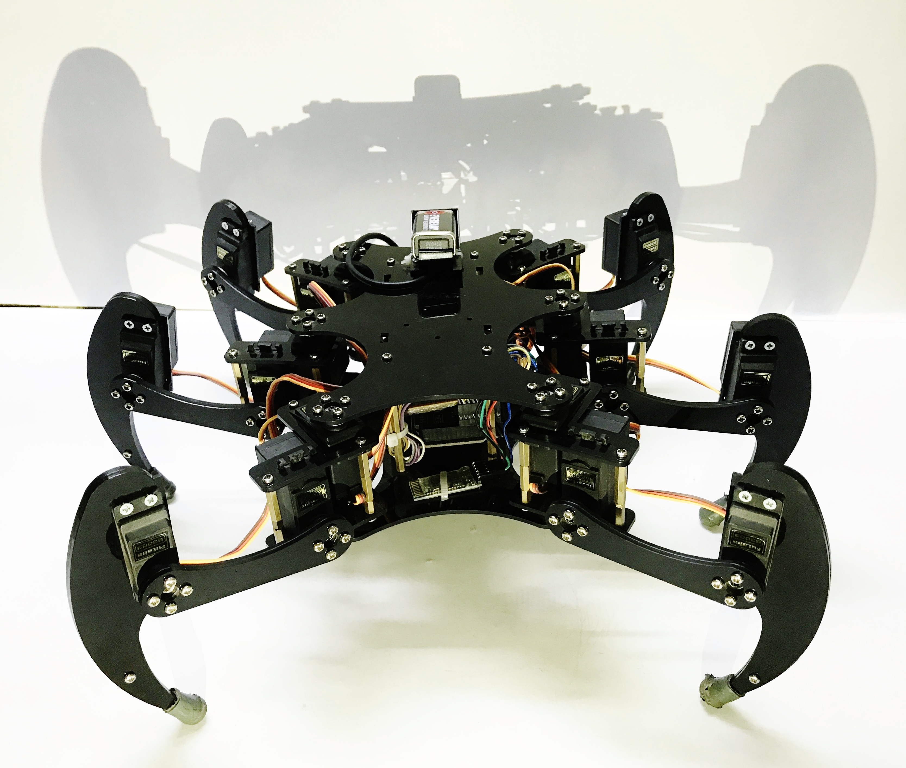
documents/Media/ZagHexa/ZagHexa (2).JPG
