RoboZag/zagHexa/documents/Media/ZagHexa/ZagHexa (3).JPG

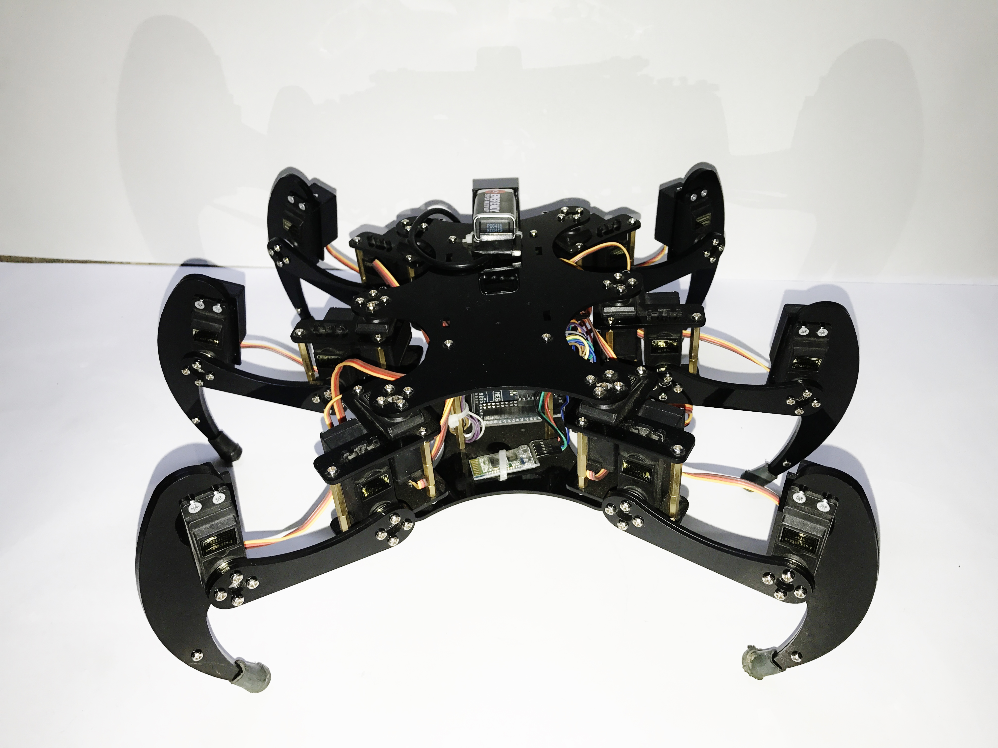
documents/Media/ZagHexa/ZagHexa (3).JPG
