RoboZag/zagHexa/documents/Media/ZagHexa/ZagHexa (4).JPG

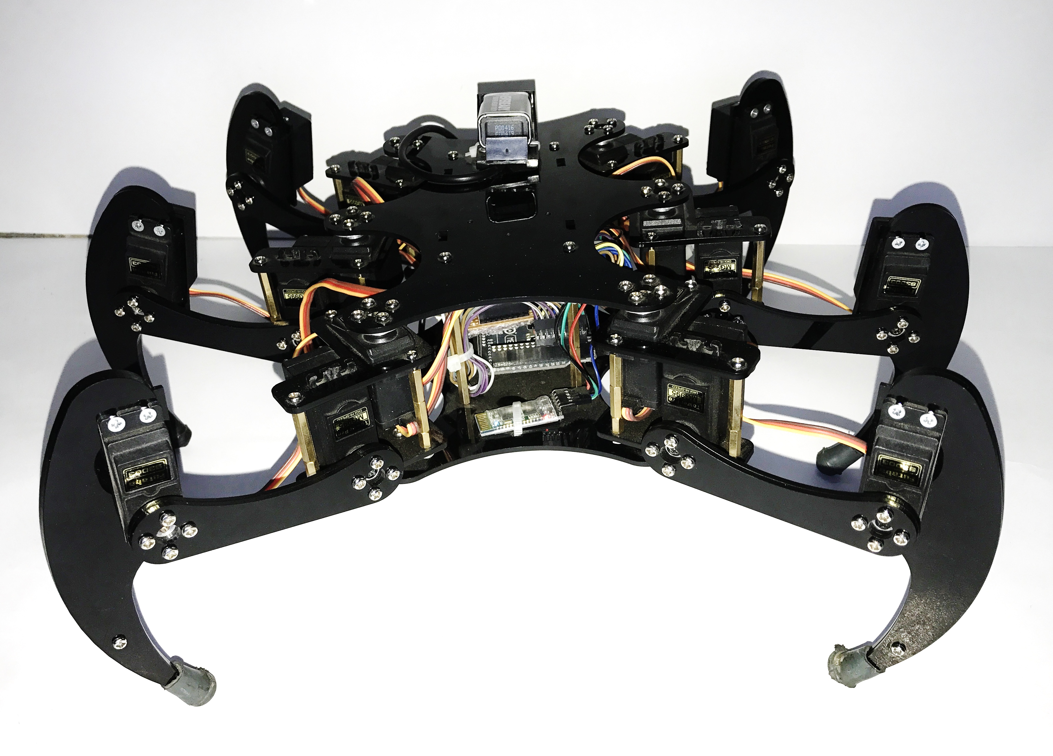
documents/Media/ZagHexa/ZagHexa (4).JPG
