RoboZag/zagHexa/documents/Media/ZagHexa/ZagHexa (5).JPG

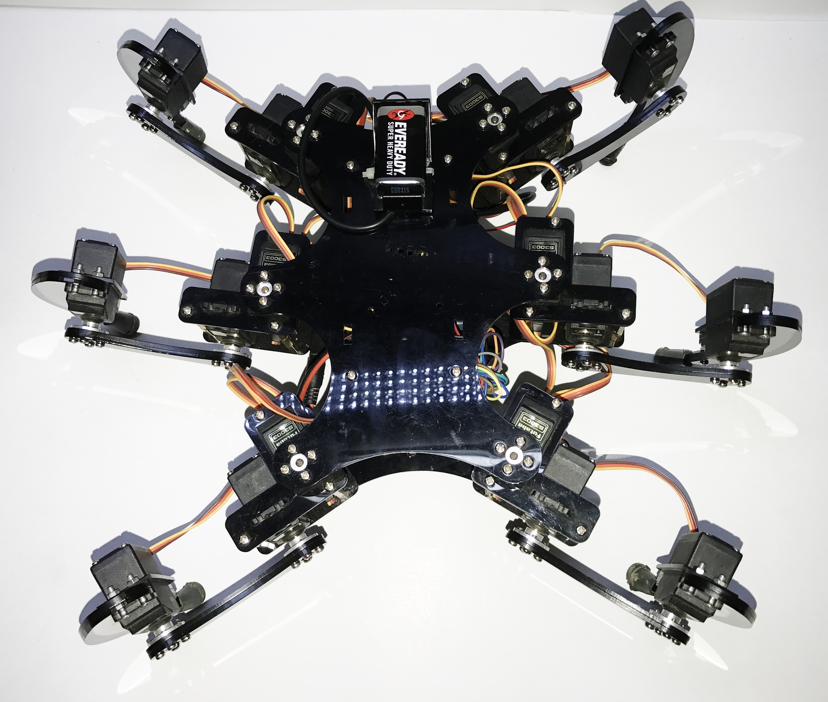
documents/Media/ZagHexa/ZagHexa (5).JPG
