RoboZag/zagHexa/documents/Media/ZagHexa/ZagHexa (6).JPG

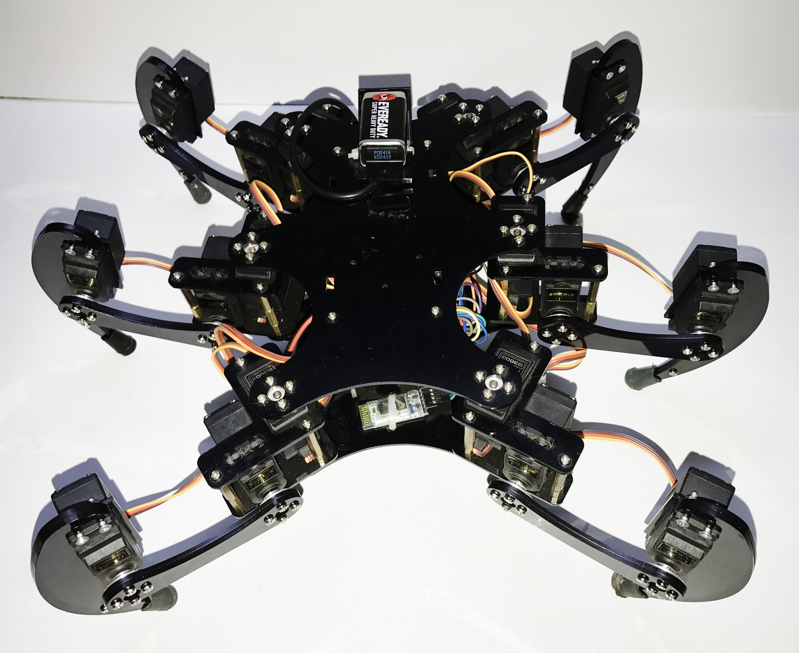
documents/Media/ZagHexa/ZagHexa (6).JPG
