RoboZag/zagHexa/documents/Media/ZagHexa/ZagHexa (7).JPG

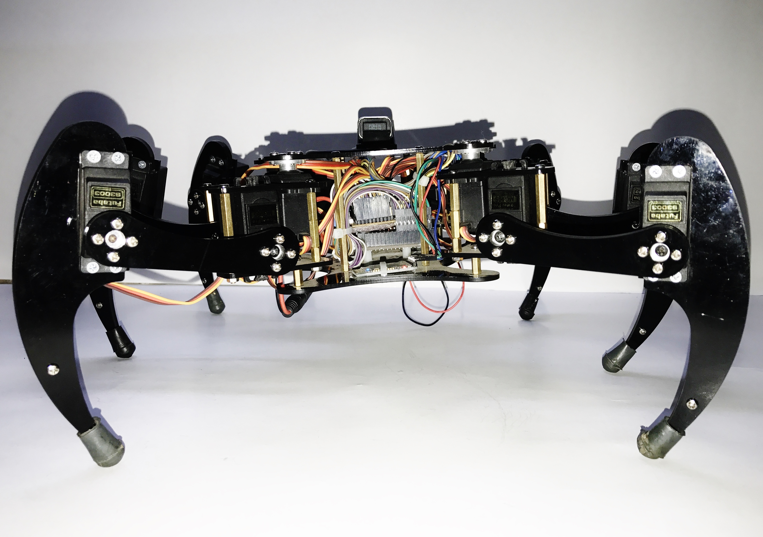
documents/Media/ZagHexa/ZagHexa (7).JPG
