RoboZag/zagHexa/documents/Media/ZagHexa/ZagHexa (8).JPG

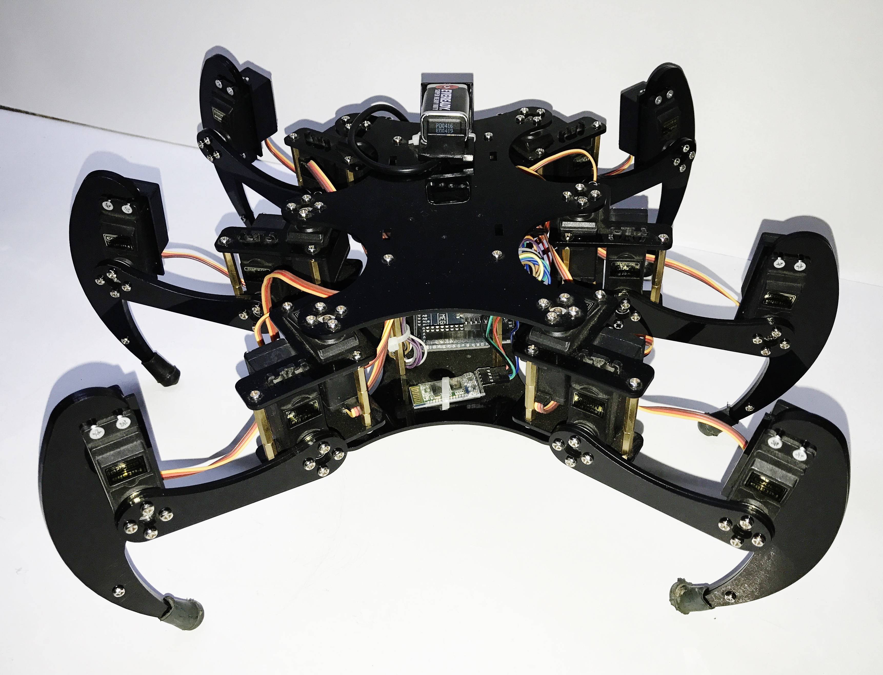
documents/Media/ZagHexa/ZagHexa (8).JPG
