RoboZag/zagHexa/documents/Media/ZagHexa/ZagHexa (9).JPG

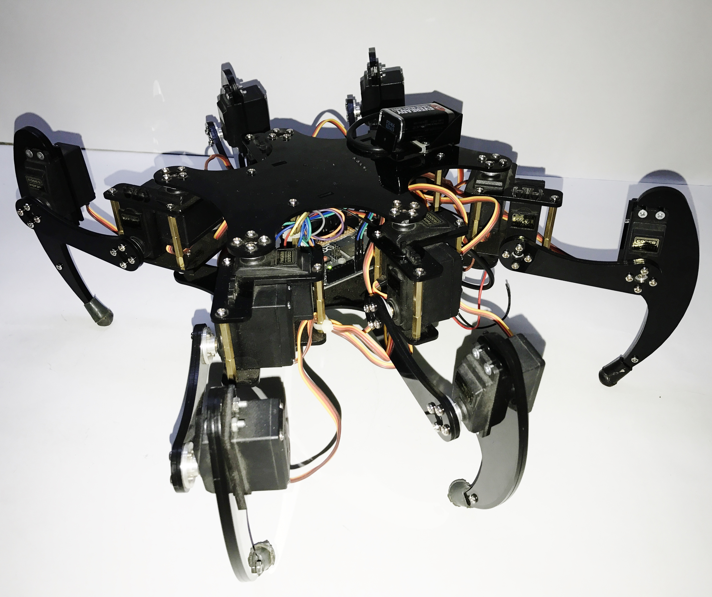
documents/Media/ZagHexa/ZagHexa (9).JPG
