RoboZag/zagHexa/documents/Media/ZagHexa/ZagHexa (10).JPG

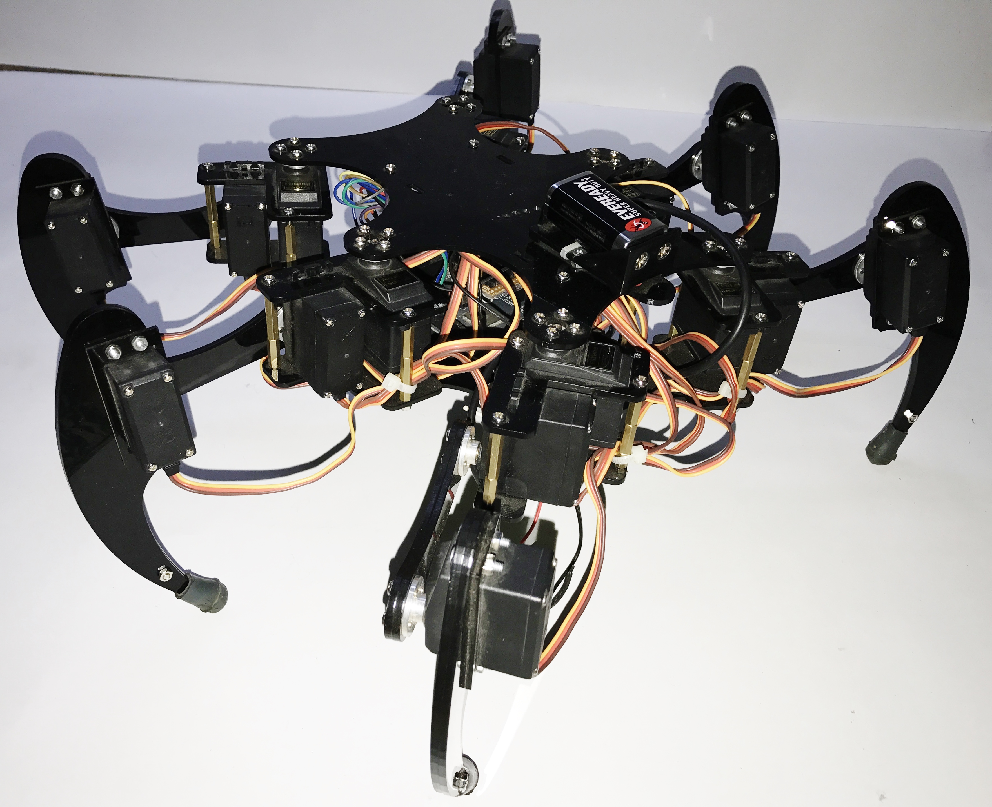
documents/Media/ZagHexa/ZagHexa (10).JPG
