RoboZag/zagHexa/documents/Media/ZagHexa/ZagHexa (11).JPG

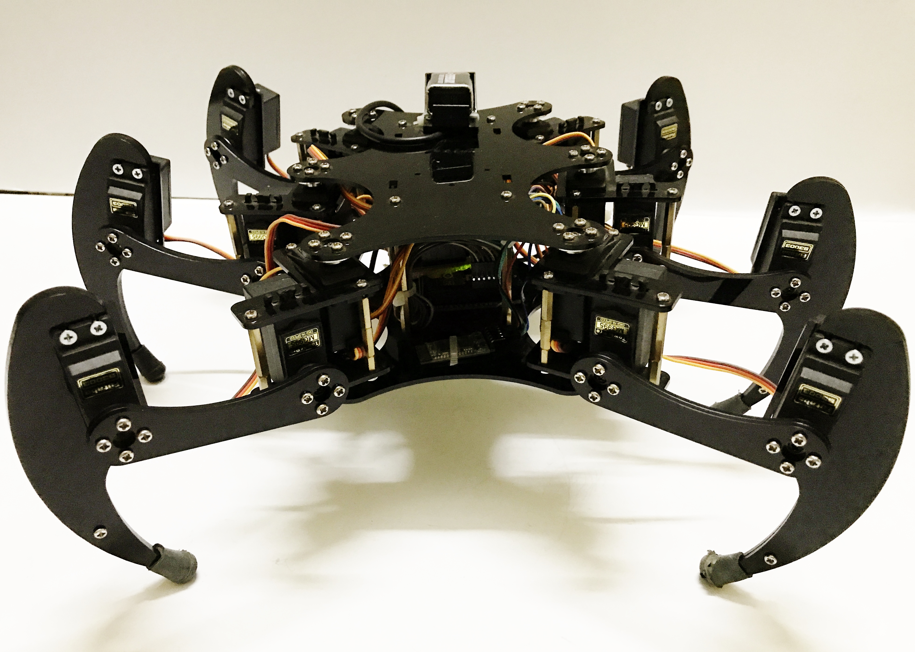
documents/Media/ZagHexa/ZagHexa (11).JPG
