RoboZag/zagHexa/documents/Media/ZagHexa/ZagHexa (12).JPG

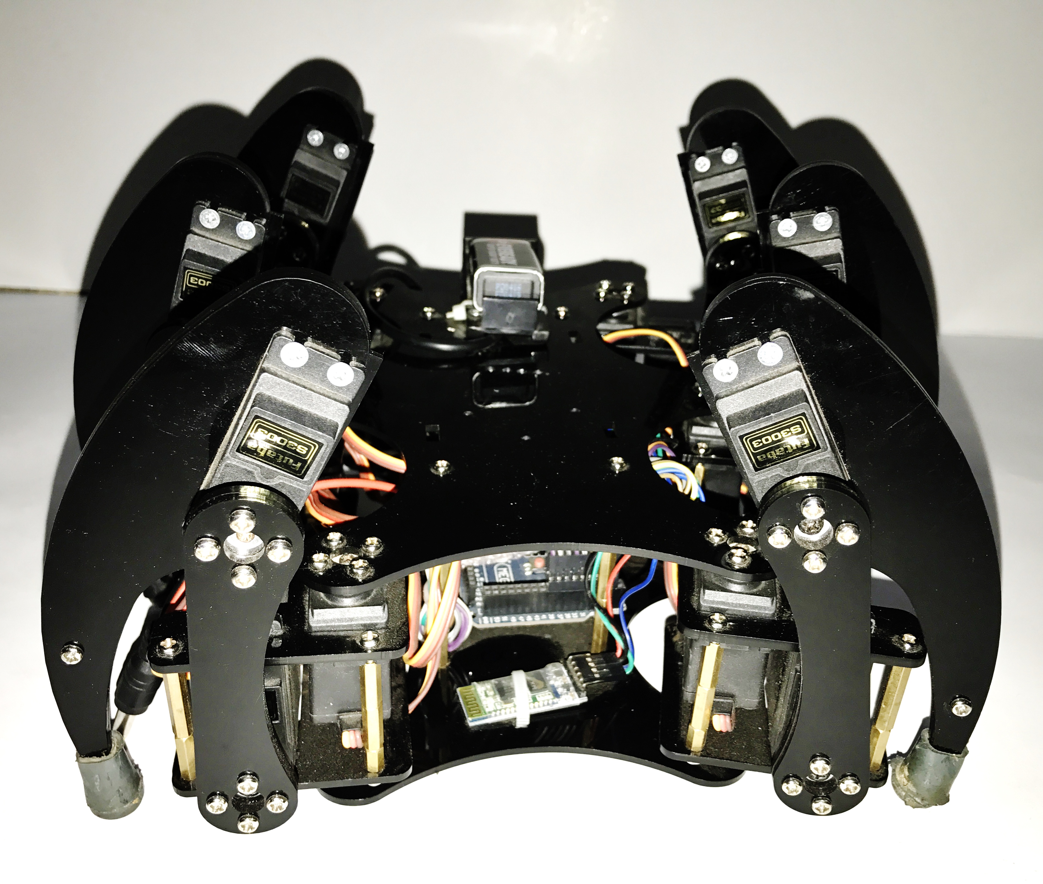
documents/Media/ZagHexa/ZagHexa (12).JPG
