RoboZag/zagHexa/documents/Media/ZagHexa/ZagHexa (13).JPG

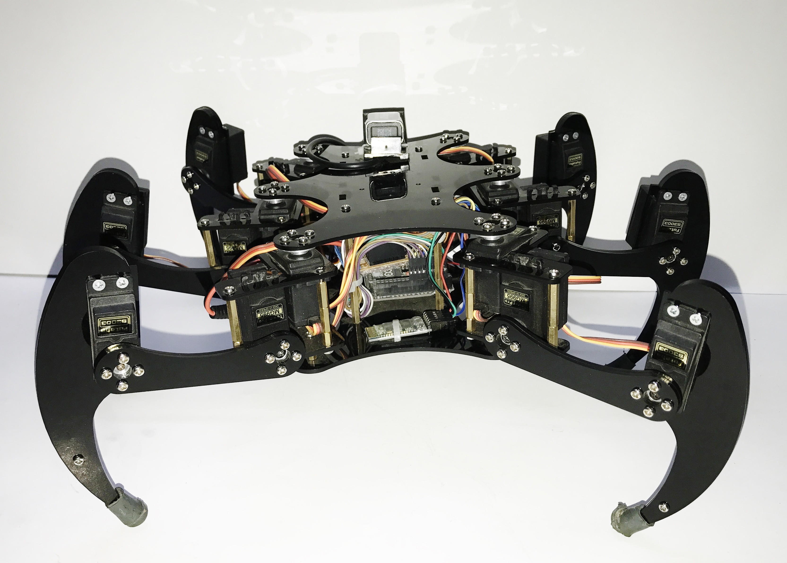
documents/Media/ZagHexa/ZagHexa (13).JPG
