RoboZag/zagHexa/documents/Media/ZagHexa/ZagHexa (14).JPG

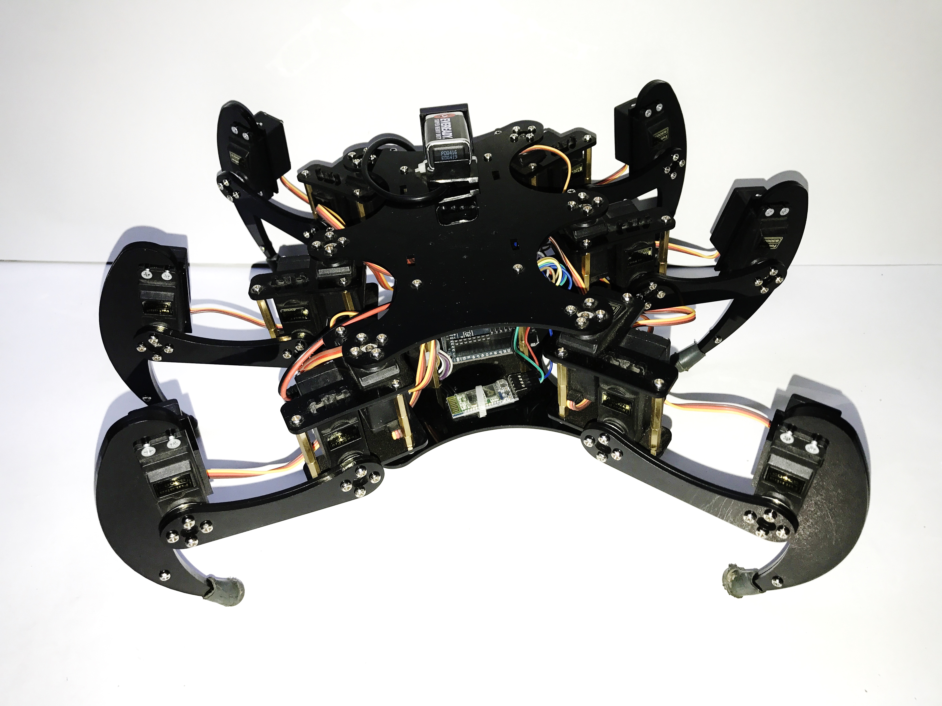
documents/Media/ZagHexa/ZagHexa (14).JPG
