RoboZag/zagHexa/documents/Media/ZagHexa/ZagHexa (15).JPG

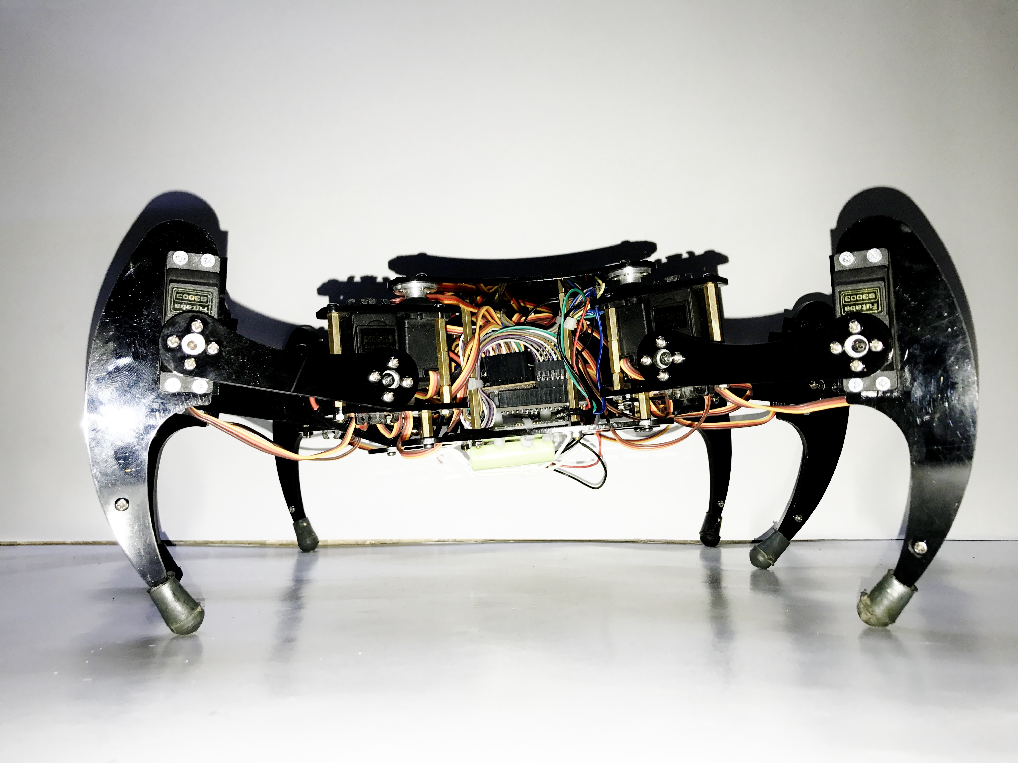
documents/Media/ZagHexa/ZagHexa (15).JPG
