RoboZag/zagHexa/documents/Media/ZagHexa/ZagHexa (16).JPG

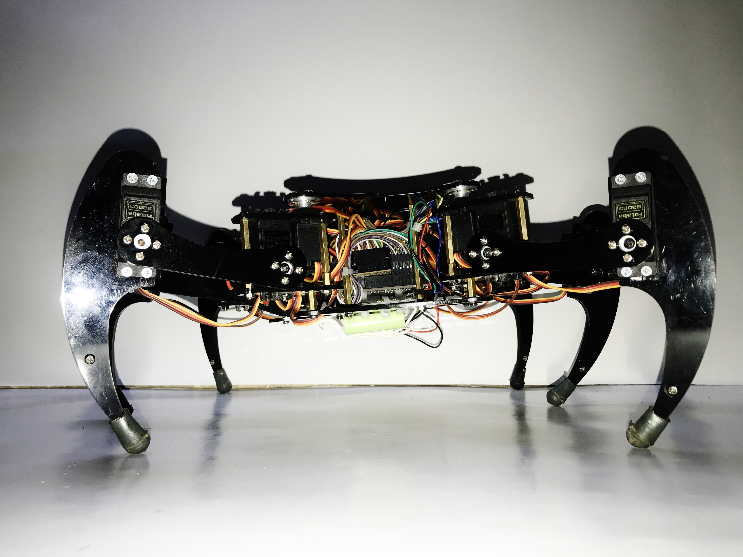
documents/Media/ZagHexa/ZagHexa (16).JPG
