RoboZag/zagHexa/documents/Media/ZagHexa/ZagHexa (18).JPG

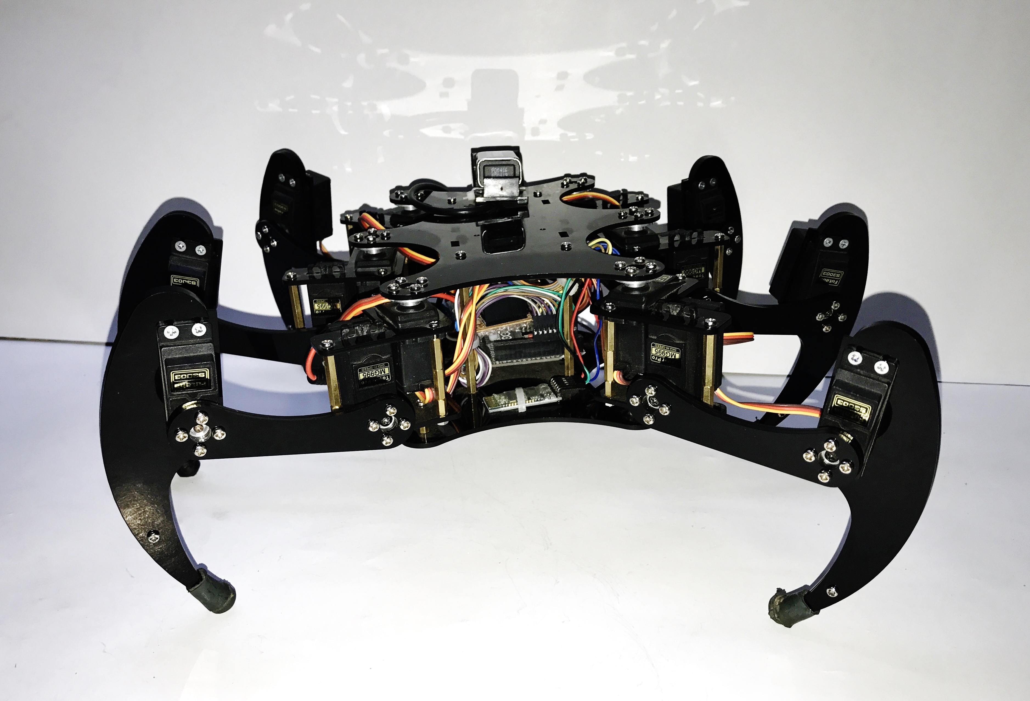
documents/Media/ZagHexa/ZagHexa (18).JPG
