RoboZag/zagHexa/documents/Media/ZagHexa/ZagHexa (19).JPG

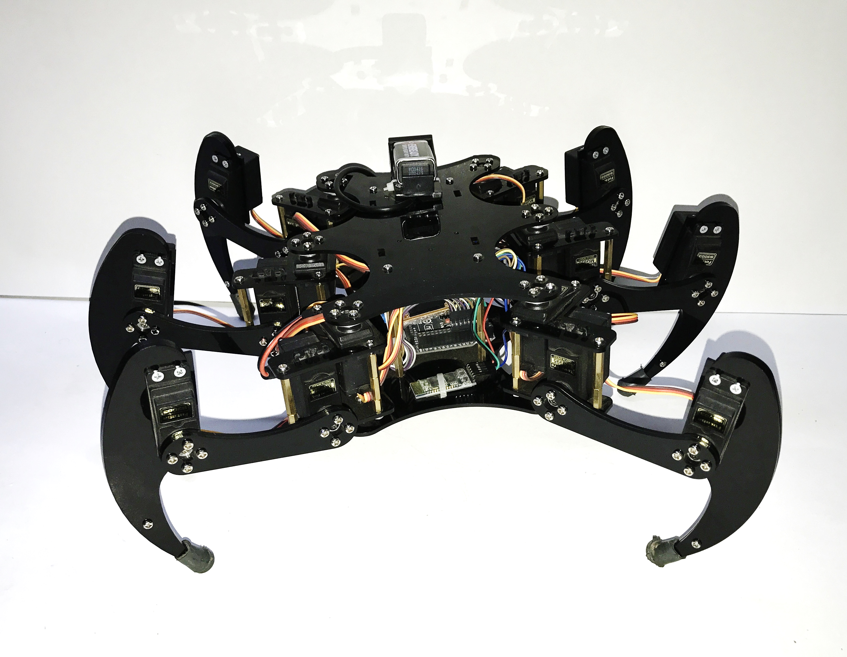
documents/Media/ZagHexa/ZagHexa (19).JPG
