RoboZag/zagHexa/documents/Media/ZagHexa/ZagHexa (20).JPG

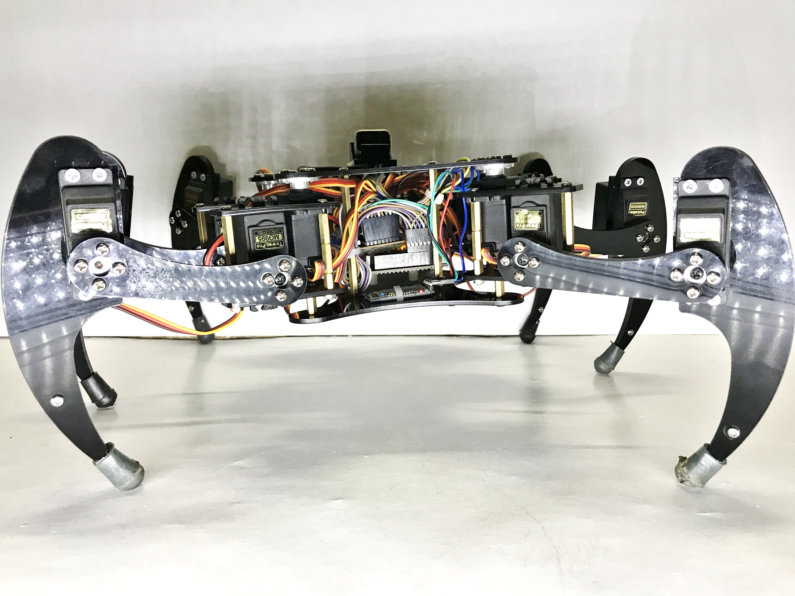
documents/Media/ZagHexa/ZagHexa (20).JPG
