RoboZag/zagHexa/documents/Media/ZagHexa/ZagHexa (21).JPG

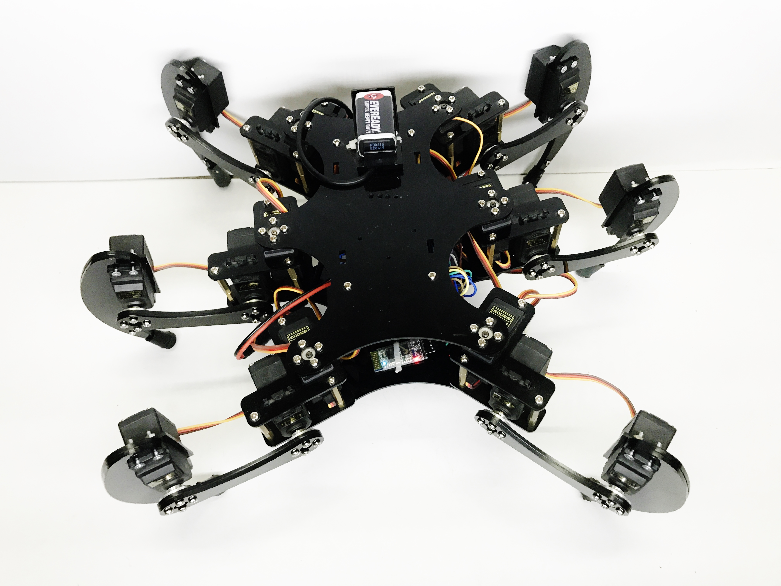
documents/Media/ZagHexa/ZagHexa (21).JPG
