RoboZag/zagHexa/documents/Media/ZagHexa/ZagHexa (22).JPG

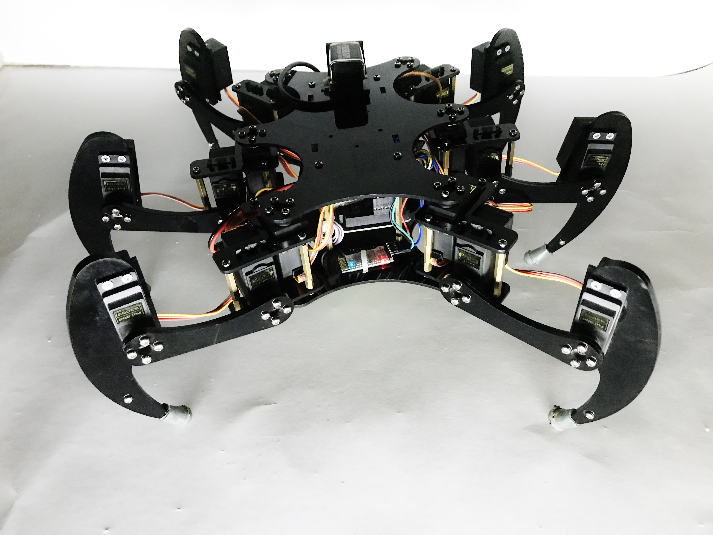
documents/Media/ZagHexa/ZagHexa (22).JPG
