RoboZag/zagHexa/documents/Media/ZagHexa/ZagHexa (23).JPG

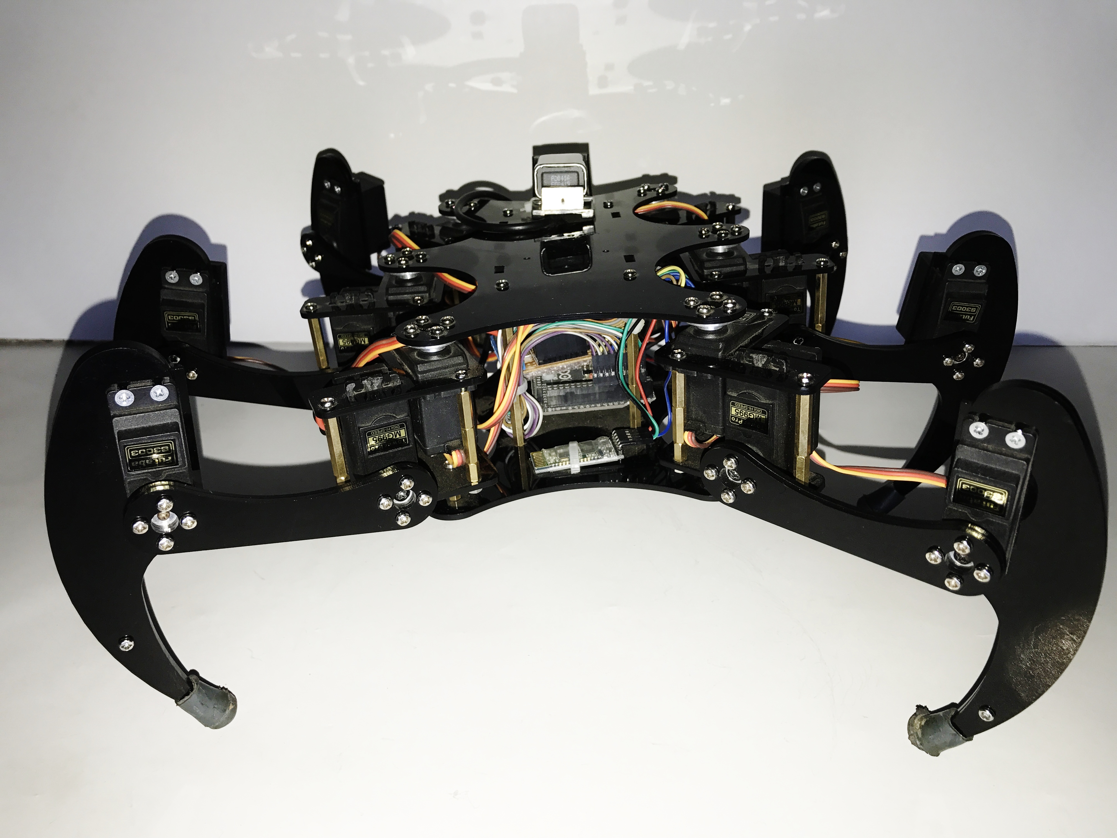
documents/Media/ZagHexa/ZagHexa (23).JPG
