RoboZag/zagHexa/documents/Media/ZagHexa/ZagHexa (24).JPG

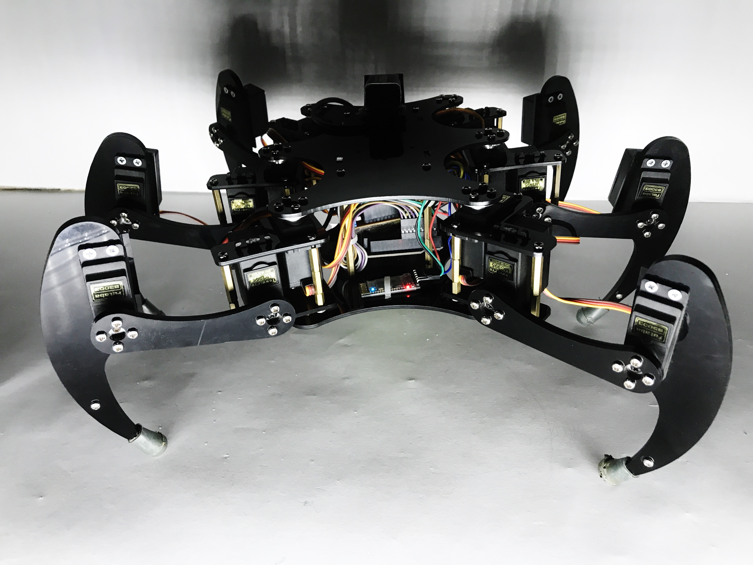
documents/Media/ZagHexa/ZagHexa (24).JPG
