RoboZag/zagHexa/Matlab/html/ZagHexaLegModelIK.png

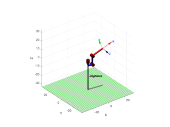
Matlab/html/ZagHexaLegModelIK.png
