RoboZag/zagHexa/rviz/zaghexa_sim/meshes/tibia_l.STL

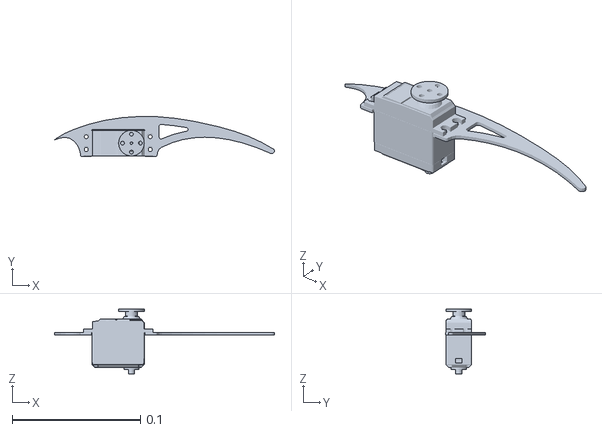
[picture p192: CAD file, 2017-06-20]
rviz/zaghexa_sim/meshes/tibia_l.STL
0.172 x 0.0313 x 0.0507
