RoboZag/zagHexa/rviz/zaghexa_sim/meshes/coxa_r.STL

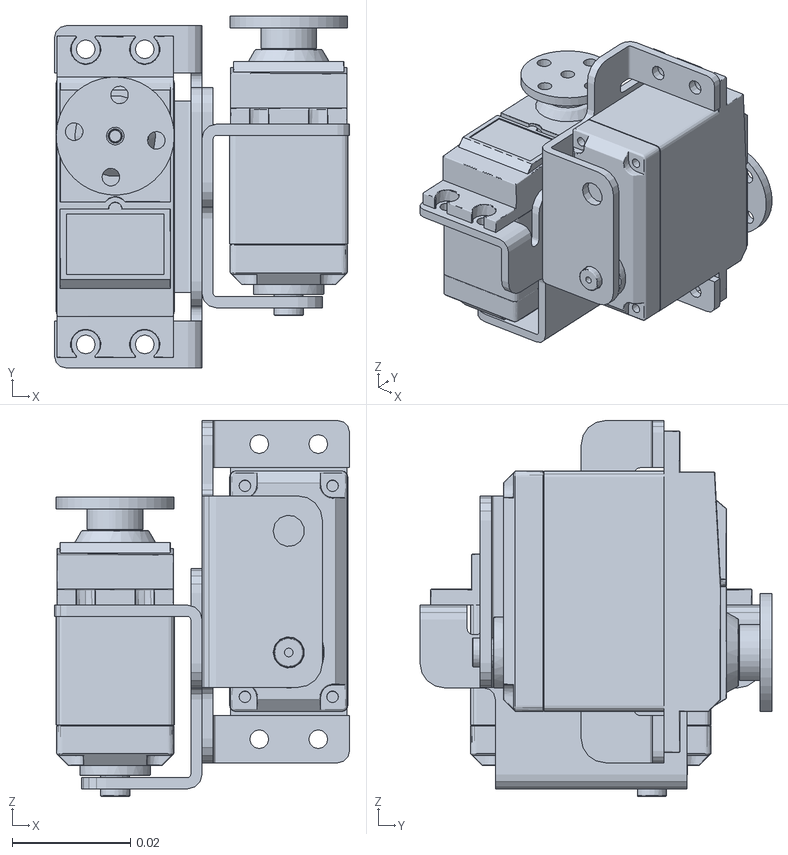
[picture p193: CAD file, 2017-06-20]
rviz/zaghexa_sim/meshes/coxa_r.STL
0.05 x 0.0596 x 0.0637
