RoboZag/zagHexa/rviz/zaghexa_sim/meshes/femur_l.STL

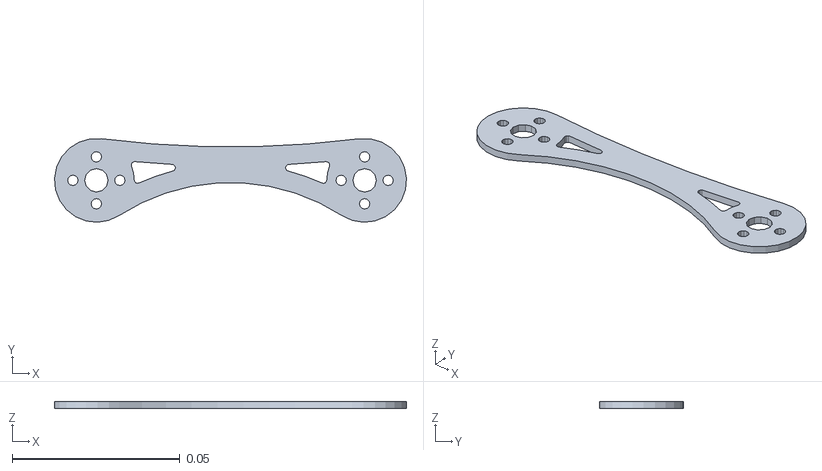
[picture p194: CAD file, 2017-06-20]
rviz/zaghexa_sim/meshes/femur_l.STL
0.105 x 0.0249 x 0.002
