RoboZag/zagHexa/rviz/zaghexa_sim/meshes/box.STL

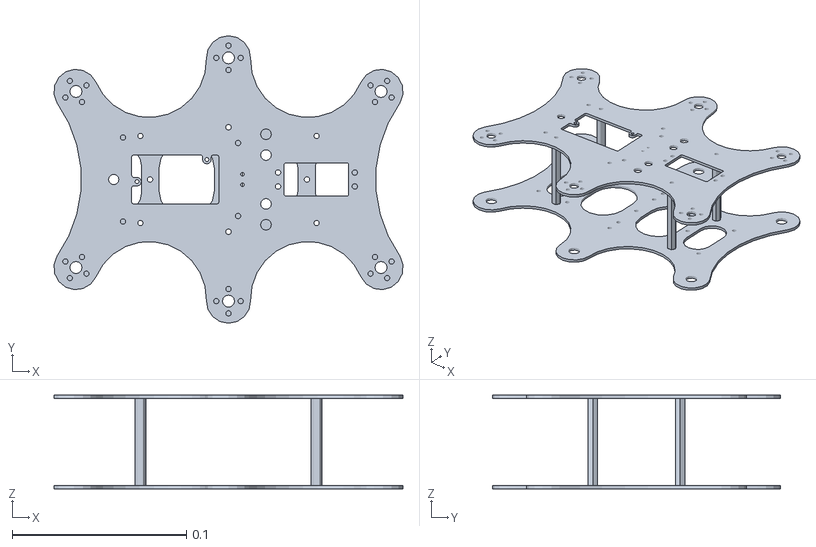
[picture p195: CAD file, 2017-06-20]
rviz/zaghexa_sim/meshes/box.STL
0.2 x 0.165 x 0.0538
