RoboZag/zagHexa/(list of files, cad)

Other CAD files:
rviz/zaghexa_sim/meshes/femur_r.STL
rviz/zaghexa_sim/meshes/tibia_r.STL
rviz/zaghexa_sim/meshes/coxa_l.STL
