RoboZag/zagHexa/docs/tutorials/img/zagHexa.jpg

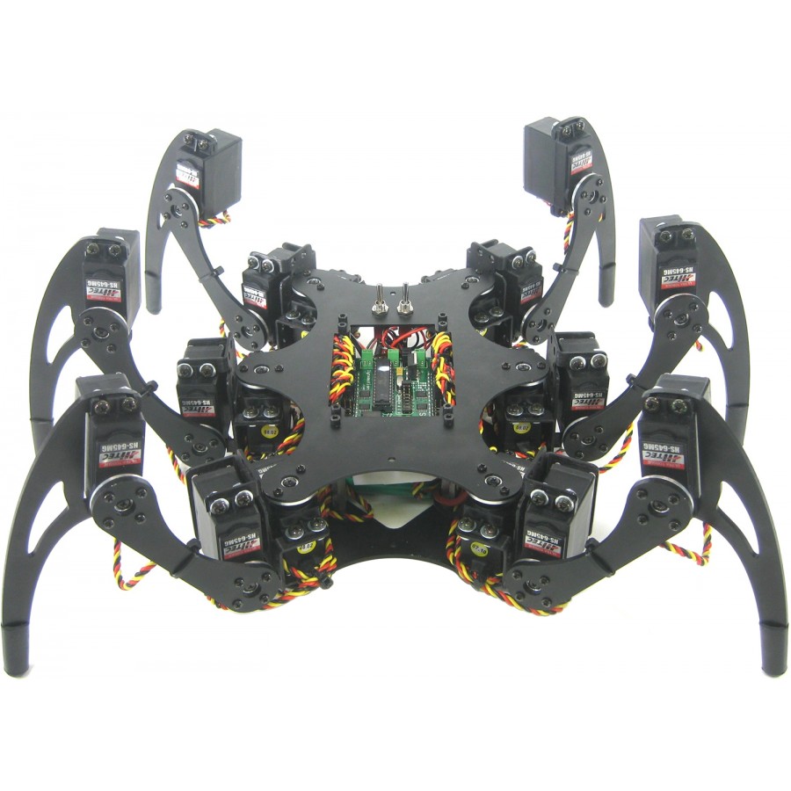
docs/tutorials/img/zagHexa.jpg
