RoboZag/zagHexa/(commit log)

2017-03-31 cpp file for the arduino code
    Convert the arduino code to an independent code for using it as a
    library
2017-04-23 change "about us " page style and add info. , change images of robos to our robot's image ,change logo.
    change "about us " page style and add info. , change images of robos to
    our robot's image ,change logo.
    add materialized files.
2017-04-24 added layout and used it with the assembly page
2017-04-25 more text to assembly page
2017-05-01 Revert "update ROS Files"
    This reverts commit a7a1318137e240ca56a16c4ccc05a322f25fd0eb.
    [JoyControl.py, Walking_Patterns.cpp, Walking_Patterns.h, ZagHexa_servodriver.cpp, ZagHexa_servodriver.h]
2017-06-20 Simulation
    rviz
    [box.STL, coxa_l.STL, coxa_r.STL, femur_l.STL, femur_r.STL, tibia_l.STL, tibia_r.STL, zaghexa_model.urdf]
2017-06-23 Convet from deg to rad, do some Calibration
2017-07-10 Arduino library for zagHexa IK
2017-07-15 Sonar system - new
2017-07-15 New feature - Sonar
