RoboZag/zagHexa/(notices)

Notices in the files:
publications/IUGRC/2017IUGRC-ZagHexa.tex:
This work is distributed under the LaTeX Project Public License (LPPL)
